Benjamin-girard-1/magnetometer-node/docs/Components choices/Capture d’écran, le 2026-01-07 à 11.52.20.png

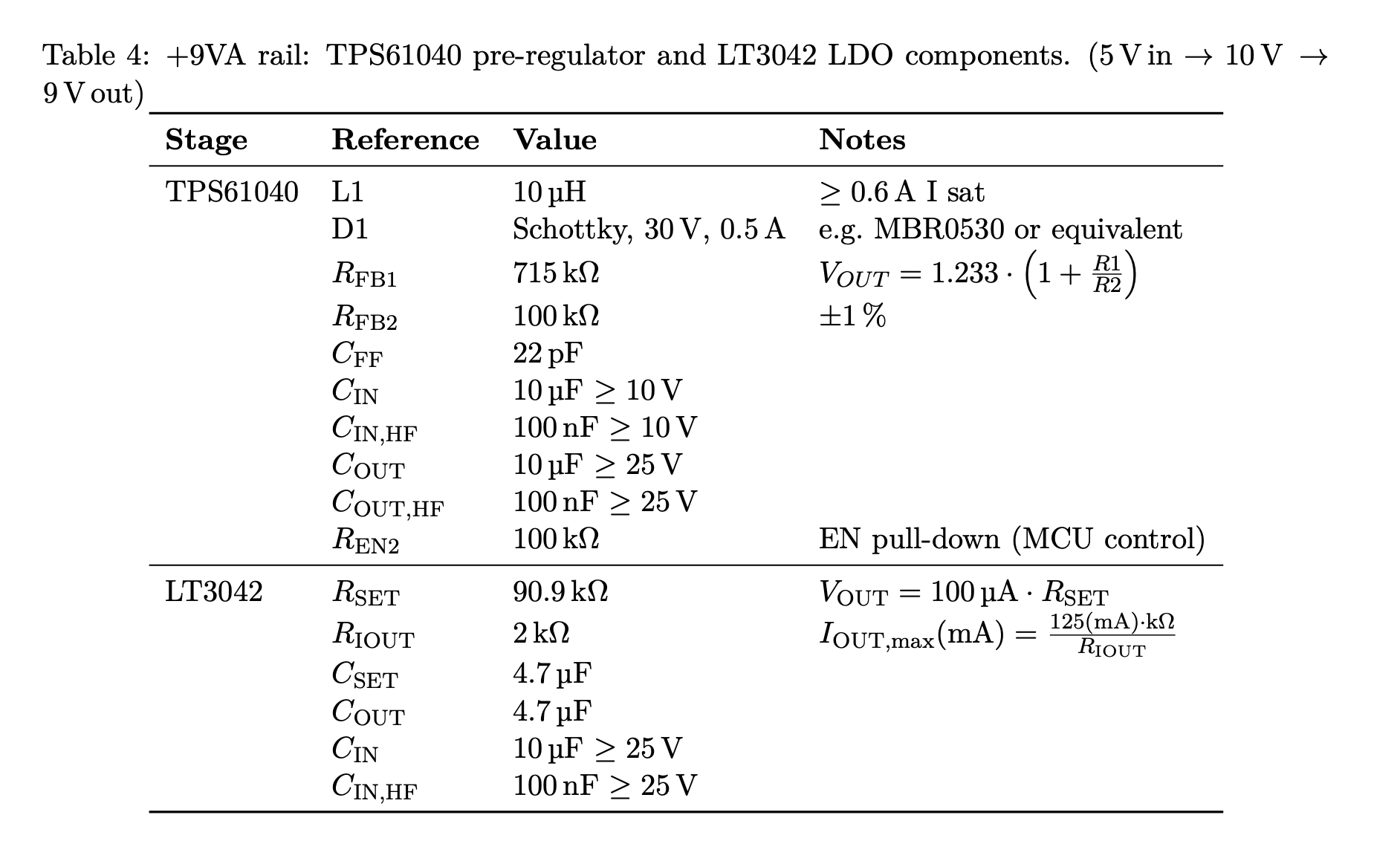
docs/Components choices/Capture d’écran, le 2026-01-07 à 11.52.20.png
