Benjamin-girard-1/magnetometer-node/docs/Components choices/fig/Lt3042.png

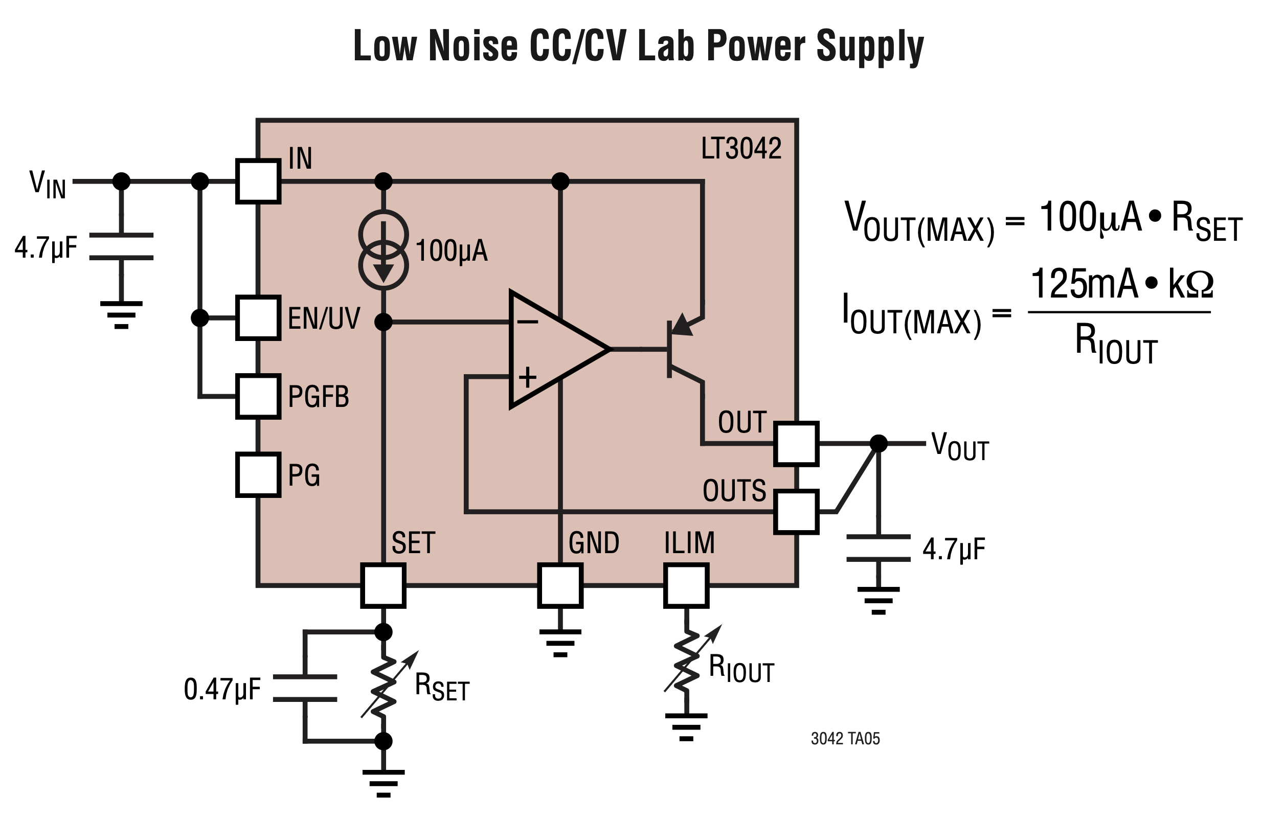
docs/Components choices/fig/Lt3042.png
