Benjamin-girard-1/magnetometer-node/docs/Components choices/fig/TPS62912.png

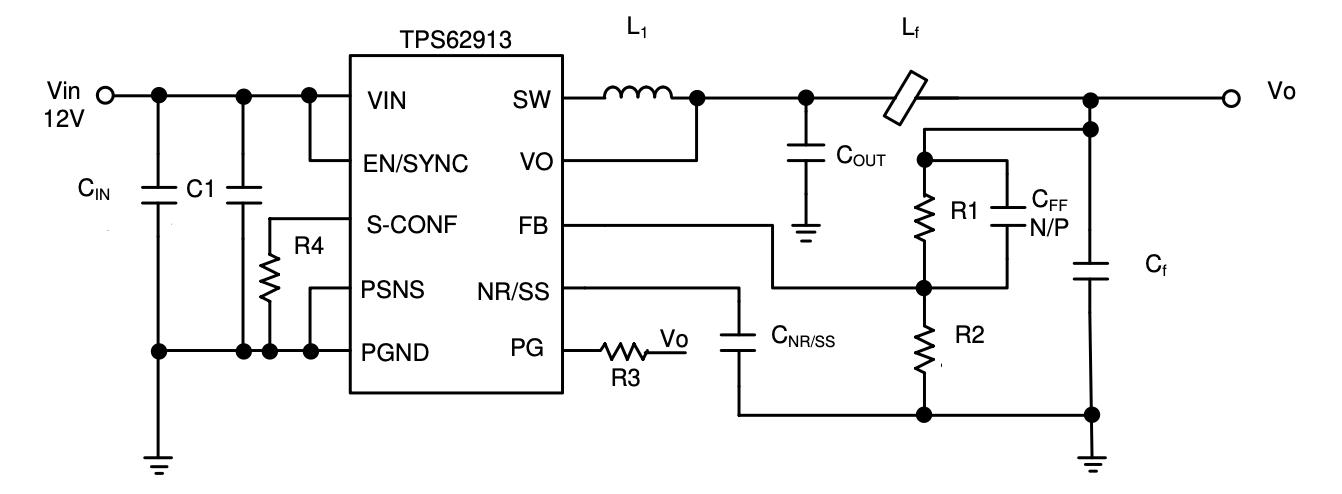
docs/Components choices/fig/TPS62912.png
