Benjamin-girard-1/magnetometer-node/hardware/pcb/Expension_card_design/3D_Assembly/Step_files/magnetometer_node_mainboard_simple.step

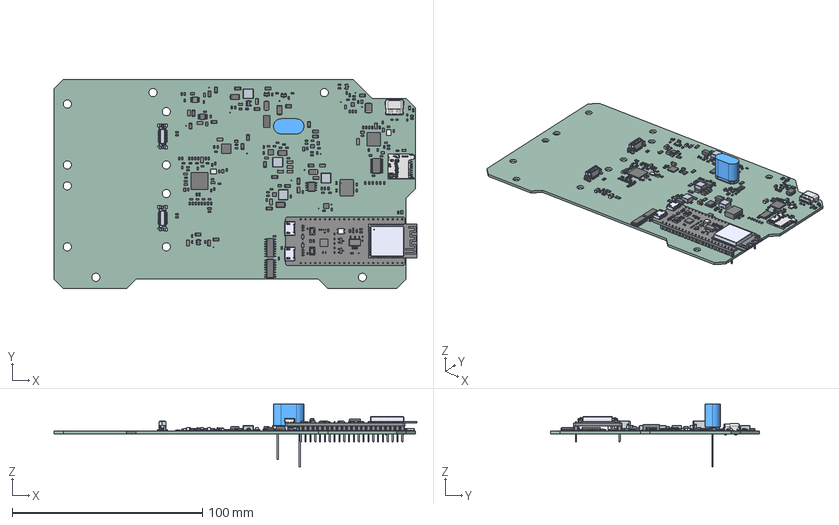
[picture p14: CAD file, 2026-04-30]
hardware/pcb/Expension_card_design/3D_Assembly/Step_files/magnetometer_node_mainboard_simple.step
190.7 x 110.0 x 33.0 mm
R_0603_1608Metric x 86
C_0805_2012Metric x 21
C_0603_1608Metric x 62
SOIC-16_3.9x9.9mm_P1.27mm x 2
R_1206_3216Metric x 23
SOT-23-5 x 2
D_SMA x 6
magnetometer_node_mainboard_simple 1.15.1 x 4
MOLD x 2
C_1206_3216Metric x 17
BODY-DGN0008G
LEAD-DGN0008G x 8
PIN1_DGN0008G
DAP_DGN0008G
LED_0805_2012Metric
D_SMB
D_SOD-523 x 4
Molex_micro_sd
QFN-64-1EP_9x9mm_P0.5mm_EP7.35x7.35mm
VSON-10-1EP_3x3mm_P0.5mm_EP1.2x2mm
LGA-14_3x2.5mm_P0.5mm_LayoutBorder3x4y
L_0603_1608Metric
Molex_USB_C_CONNECTOR2012670005
Texas_RGW0020A_VQFN-20-1EP_5x5mm_P0.65mm_EP3.15x3.15mm
R_2512_6332Metric
ESP32-S3-DEVKITC-1-N8
SOT-23 x 3
Crystal_SMD_3225-4Pin_3.2x2.5mm x 2
MSOP-10-1EP_3x3mm_P0.5mm_EP1.68x1.88mm
TSSOP-24_4.4x7.8mm_P0.65mm
QFN-48-1EP_7x7mm_P0.5mm_EP5.15x5.15mm
SCL3300-D01-10_MUR
R_0805_2012Metric
WSON-6-1EP_2x2mm_P0.65mm_EP1x1.6mm
SOIC-8_3.9x4.9mm_P1.27mm
CP_Radial_D8.0mm_P1150mm
geophys_mainboard_PCB
