Benjamin-girard-1/magnetometer-node/hardware/pcb/Expension_card_design/3D_Assembly/Assembly/Expension_design_3D.FCStd

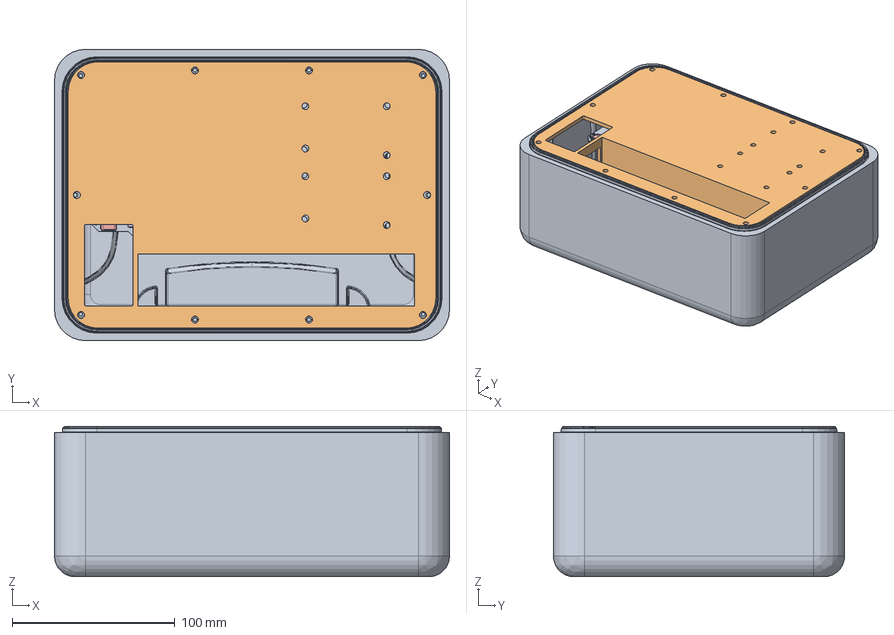
[picture p15: CAD file, 2026-04-30]
hardware/pcb/Expension_card_design/3D_Assembly/Assembly/Expension_design_3D.FCStd
242.8 x 179.0 x 92.5 mm
NANUK_904_Bottom001
R_0603_1608Metric
R_0603_1608Metric001
C_0805_2012Metric
R_0603_1608Metric002
C_0603_1608Metric
C_0603_1608Metric001
C_0805_2012Metric001
SOIC-16_3.9x9.9mm_P1.27mm
C_0603_1608Metric002
R_1206_3216Metric
SOT-23-5
R_0603_1608Metric003
D_SMA
C_0603_1608Metric003
magnetometer_node_mainboard_simple 1.15.1
magnetometer_node_mainboard_simple 1.15.002
magnetometer_node_mainboard_simple 1.15.003
C_0603_1608Metric004
C_0805_2012Metric002
R_1206_3216Metric001
MOLD
R_0603_1608Metric004
MOLD001
R_0603_1608Metric005
C_0603_1608Metric005
R_0603_1608Metric006
C_0603_1608Metric006
magnetometer_node_mainboard_simple 1.15.005
magnetometer_node_mainboard_simple 1.15.006
magnetometer_node_mainboard_simple 1.15.007
R_0603_1608Metric007
R_0603_1608Metric008
R_0603_1608Metric009
R_0603_1608Metric010
C_0805_2012Metric003
C_1206_3216Metric
R_1206_3216Metric002
C_0603_1608Metric007
R_1206_3216Metric003
R_0603_1608Metric011
BODY-DGN0008G
LEAD-DGN0008G
LEAD-DGN0008G001
LEAD-DGN0008G002
LEAD-DGN0008G003
LEAD-DGN0008G004
LEAD-DGN0008G005
LEAD-DGN0008G006
LEAD-DGN0008G007
DAP_DGN0008G
C_0603_1608Metric008
C_0603_1608Metric009
C_1206_3216Metric001
R_0603_1608Metric012
R_1206_3216Metric004
C_1206_3216Metric002
C_0603_1608Metric010
C_1206_3216Metric003
C_0603_1608Metric011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
