Benjamin-girard-1/magnetometer-node/hardware/pcb/Expension_card_design/3D_Assembly/FreeCAD_Designs/904_frame.FCStd

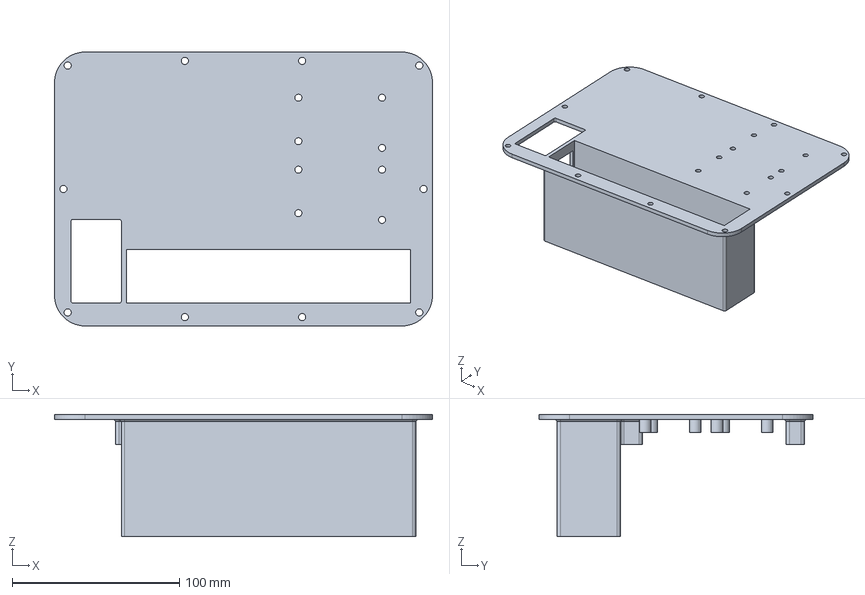
[picture p16: CAD file, 2026-04-30]
hardware/pcb/Expension_card_design/3D_Assembly/FreeCAD_Designs/904_frame.FCStd
225.9 x 163.7 x 73.2 mm
