Benjamin-girard-1/magnetometer-node/hardware/pcb/Expension_card_design/3D_Assembly/SLT_files/04_Coil_Top_HC_v1.stl

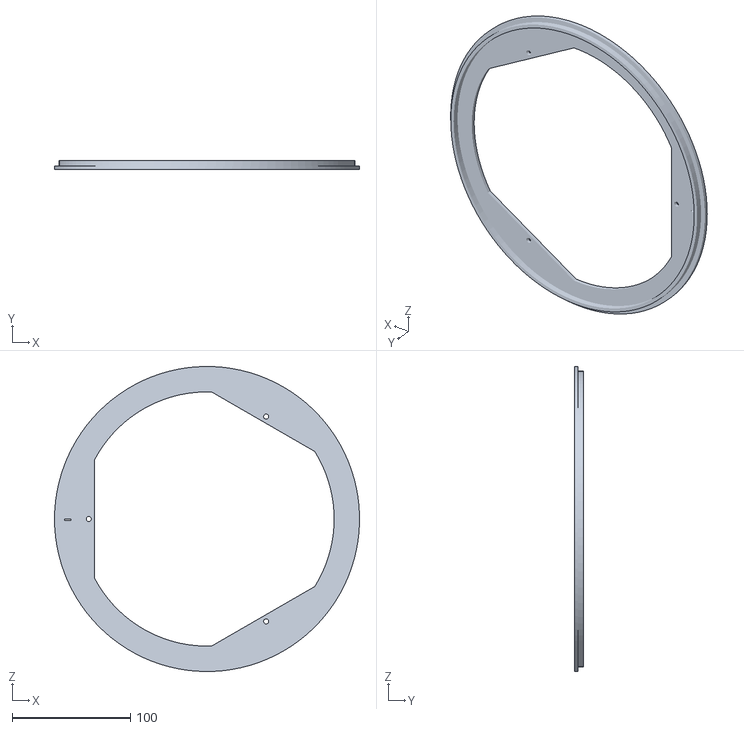
[picture p17: CAD file, 2026-05-25]
hardware/pcb/Expension_card_design/3D_Assembly/SLT_files/04_Coil_Top_HC_v1.stl
257.9 x 8.00 x 258.0
