Benjamin-girard-1/magnetometer-node/hardware/pcb/Expension_card_design/3D_Assembly/Step_files/Bottom_coil_B.stl

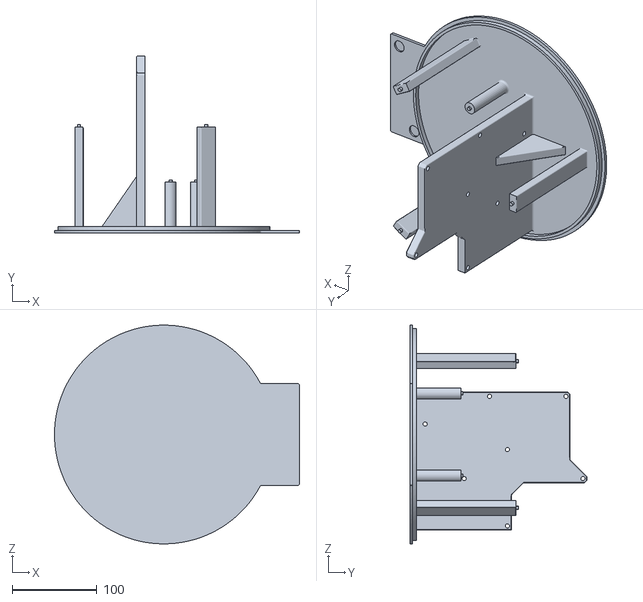
[picture p18: CAD file, 2026-05-25]
hardware/pcb/Expension_card_design/3D_Assembly/Step_files/Bottom_coil_B.stl
288.9 x 209.0 x 257.9
