Benjamin-girard-1/magnetometer-node/hardware/pcb/Expension_card_design/3D_Assembly/FreeCAD_Designs/904_plate.FCStd

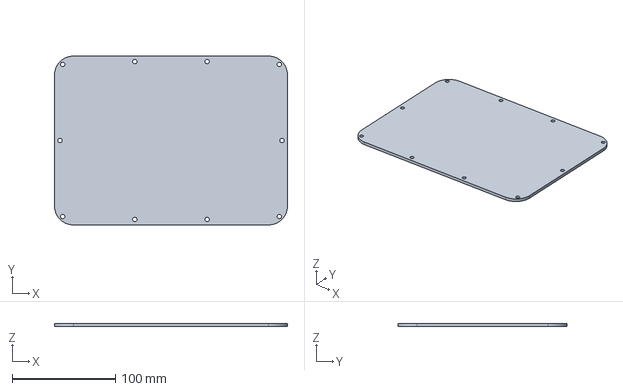
[picture p19: CAD file, 2026-04-30]
hardware/pcb/Expension_card_design/3D_Assembly/FreeCAD_Designs/904_plate.FCStd
225.9 x 163.7 x 3.20 mm
