Benjamin-girard-1/magnetometer-node/hardware/pcb/Expension_card_design/3D_Assembly/SLT_files/01_Base_HC_v1.stl

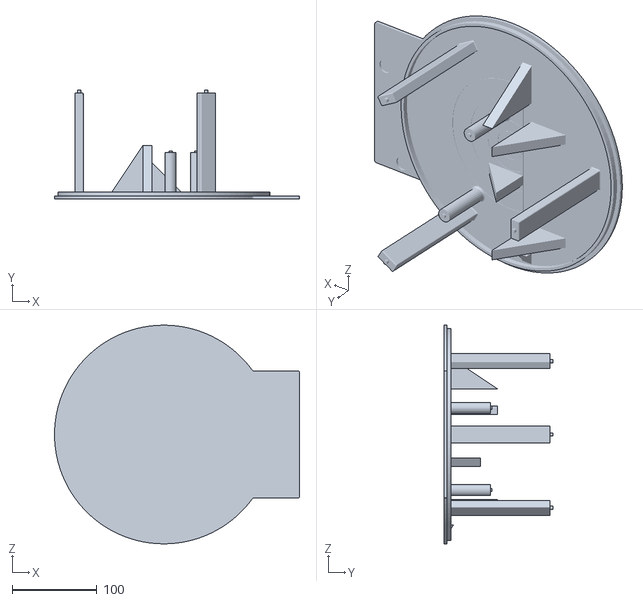
[picture p20: CAD file, 2026-05-25]
hardware/pcb/Expension_card_design/3D_Assembly/SLT_files/01_Base_HC_v1.stl
289.0 x 128.0 x 258.0
