Benjamin-girard-1/magnetometer-node/hardware/pcb/Expension_card_design/3D_Assembly/FreeCAD_Designs/904_body_top.FCStd

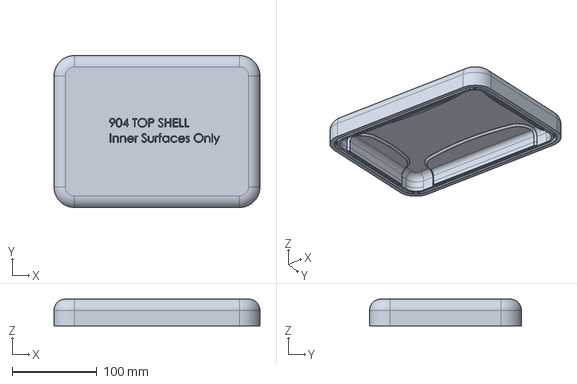
[picture p21: CAD file, 2026-04-30]
hardware/pcb/Expension_card_design/3D_Assembly/FreeCAD_Designs/904_body_top.FCStd
243.0 x 179.2 x 31.8 mm
