Benjamin-girard-1/magnetometer-node/hardware/pcb/Expension_card_design/3D_Assembly/SLT_files/05_Pillar_HC_v1.stl

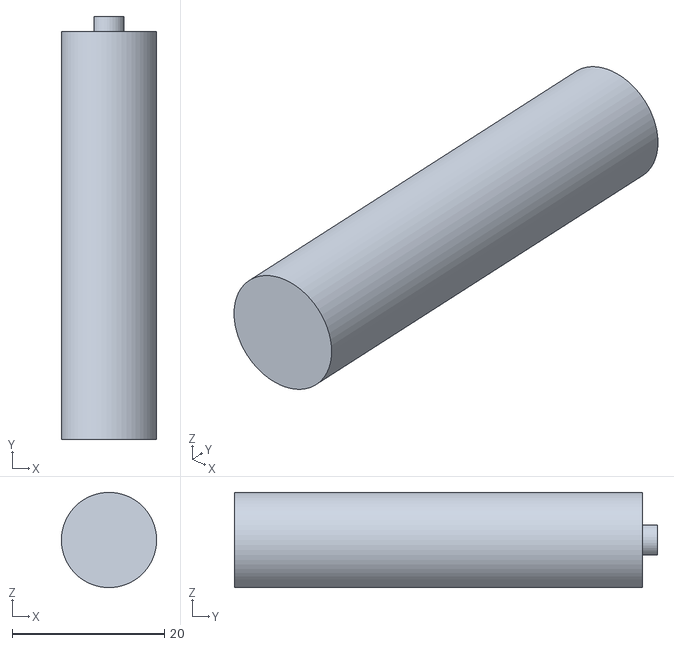
[picture p22: CAD file, 2026-05-25]
hardware/pcb/Expension_card_design/3D_Assembly/SLT_files/05_Pillar_HC_v1.stl
12.5 x 55.5 x 12.5
