Benjamin-girard-1/magnetometer-node/hardware/pcb/Expension_card_design/3D_Assembly/Step_files/904_frame10.step

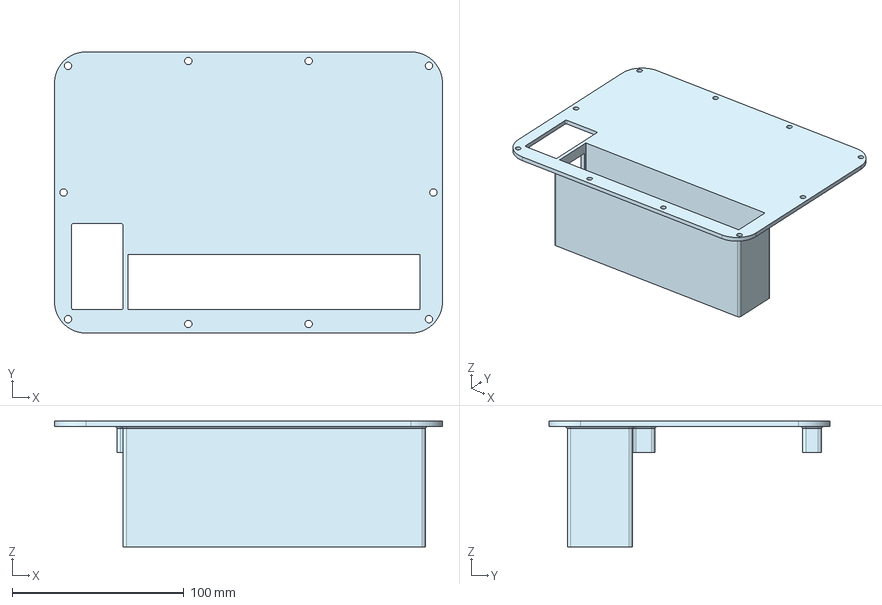
[picture p23: CAD file, 2026-04-30]
hardware/pcb/Expension_card_design/3D_Assembly/Step_files/904_frame10.step
225.9 x 163.7 x 73.2 mm
