Benjamin-girard-1/magnetometer-node/hardware/pcb/Expension_card_design/3D_Assembly/FreeCAD_Designs/904_body_bottom.FCStd

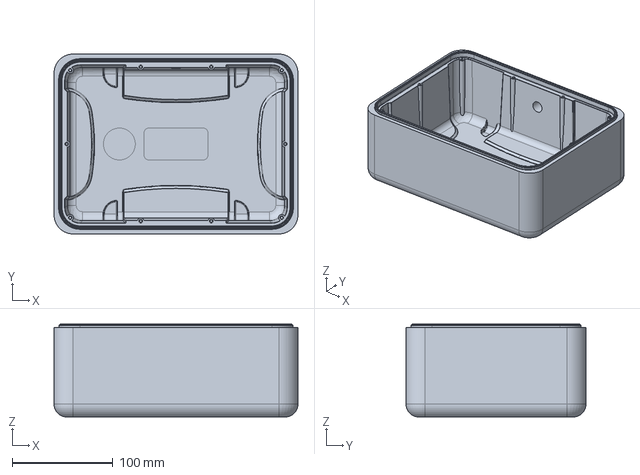
[picture p24: CAD file, 2026-04-30]
hardware/pcb/Expension_card_design/3D_Assembly/FreeCAD_Designs/904_body_bottom.FCStd
242.8 x 179.0 x 92.5 mm
