Benjamin-girard-1/magnetometer-node/hardware/pcb/Expension_card_design/3D_Assembly/SLT_files/03_Back_plate_HC_v1.stl

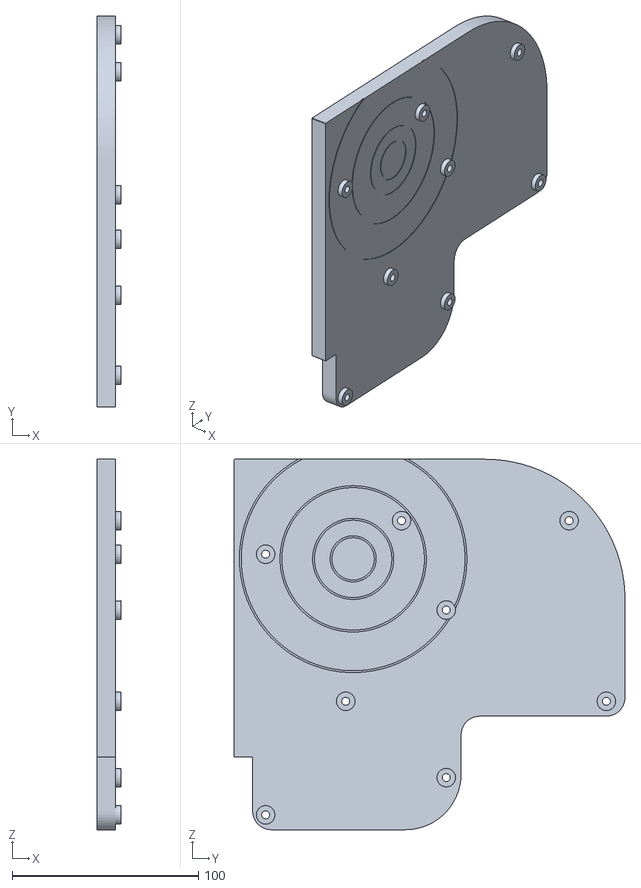
[picture p25: CAD file, 2026-05-25]
hardware/pcb/Expension_card_design/3D_Assembly/SLT_files/03_Back_plate_HC_v1.stl
13.0 x 210.0 x 199.0
