Benjamin-girard-1/magnetometer-node/hardware/pcb/Expension_card_design/3D_Assembly/Step_files/904_frame2.step

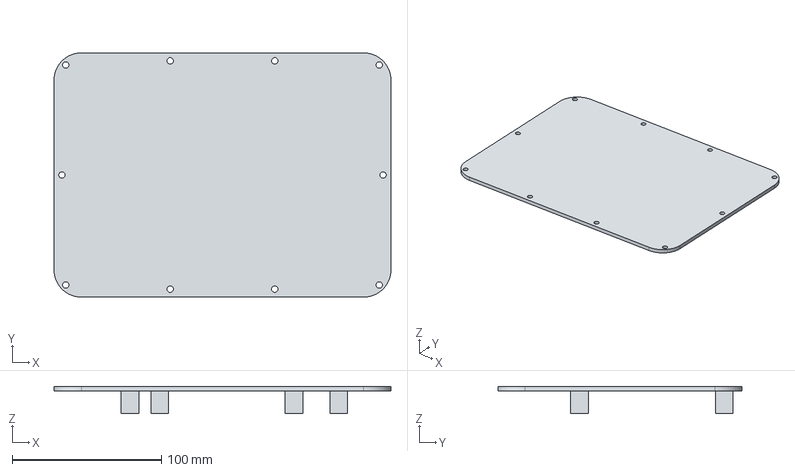
[picture p26: CAD file, 2026-04-30]
hardware/pcb/Expension_card_design/3D_Assembly/Step_files/904_frame2.step
225.9 x 163.7 x 18.2 mm
