Benjamin-girard-1/magnetometer-node/hardware/pcb/Expension_card_design/3D_Assembly/Step_files/Exp_mag.step

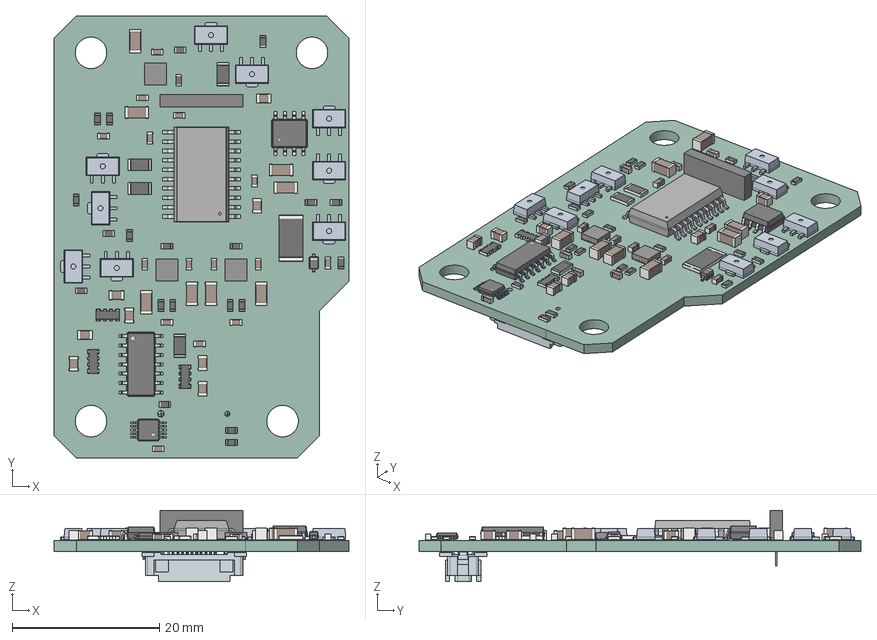
[picture p28: CAD file, 2026-04-30]
hardware/pcb/Expension_card_design/3D_Assembly/Step_files/Exp_mag.step
40.0 x 60.0 x 9.64 mm
R_0603_1608Metric x 21
C_0805_2012Metric x 8
C_0603_1608Metric x 15
C_1206_3216Metric x 8
SOIC20_HNW
BODY-QFN x 3
FRAME-RGT0016C x 3
PIN1-ID x 3
Exp_mag 1.10.1 x 9
SIP8_HMC1001_HNW
R_Array_Convex_4x0603 x 3
SOIC-14_3.9x8.7mm_P1.27mm
R_1206_3216Metric x 4
D_SOD-323
SO-8_3.9x4.9mm_P1.27mm
R_2512_6332Metric
MSOP-10_3x3mm_P0.5mm
magnetic_expension_PCB
