Benjamin-girard-1/magnetometer-node/hardware/pcb/Expension_card_design/3D_Assembly/Step_files/6mm_HEX_Spacer_M4.step

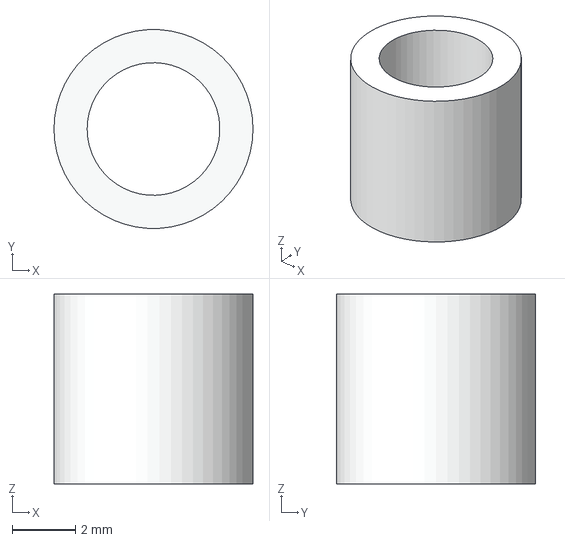
[picture p29: CAD file, 2026-04-30]
hardware/pcb/Expension_card_design/3D_Assembly/Step_files/6mm_HEX_Spacer_M4.step
6.30 x 6.29 x 6.00 mm
