Benjamin-girard-1/magnetometer-node/(list of files, cad)

Other CAD files:
hardware/pcb/Expension_card_design/3D_Assembly/Step_files/904_frame11.step
hardware/pcb/Expension_card_design/3D_Assembly/Step_files/904_plate.step
hardware/pcb/Expension_card_design/3D_Assembly/Step_files/904_frame7.step
hardware/pcb/Expension_card_design/3D_Assembly/Step_files/904_frame3.step
hardware/pcb/Expension_card_design/3D_Assembly/Step_files/904_body_top.step
hardware/pcb/Expension_card_design/3D_Assembly/Step_files/904_frame4.step
hardware/pcb/Expension_card_design/3D_Assembly/Step_files/904_frame.step
hardware/pcb/Expension_card_design/3D_Assembly/Step_files/904_frame8.step
hardware/pcb/Expension_card_design/3D_Assembly/Step_files/904_frame6.step
hardware/pcb/Expension_card_design/3D_Assembly/Step_files/904_frame9.step
hardware/pcb/Expension_card_design/3D_Assembly/Step_files/904_body_bottom.step
hardware/pcb/Expension_card_design/3D_Assembly/Step_files/904_plate_2.step
hardware/pcb/Expension_card_design/3D_Assembly/Step_files/904_frame12.step
hardware/pcb/Expension_card_design/3D_Assembly/Step_files/904_frame5.step
hardware/pcb/Expension_card_design/3D_Assembly/Step_files/904_frame12.stl
