Benjamin-girard-1/magnetometer-node/hardware/pcb/Expension_card_design/3D_Assembly/SLT_files/Instruction_impression.docx

Instruction des fichiers à imprimer pour la bobine d’Helmholtz

Pièce 01 (base) : 1x

Pièce 02 (Coil closer) : 2x

Pièce 03 (Back plate) : 1x

Pièce 04 (Coil top) : 1x

Pièce 05 (Pillar) : 2x
