Benjamin-girard-1/magnetometer-node/firmware/esp32/ESP32-S3-WROOM-1/Mainboard/geophys-daq/calibration_code/noise_density_compare_difference.png

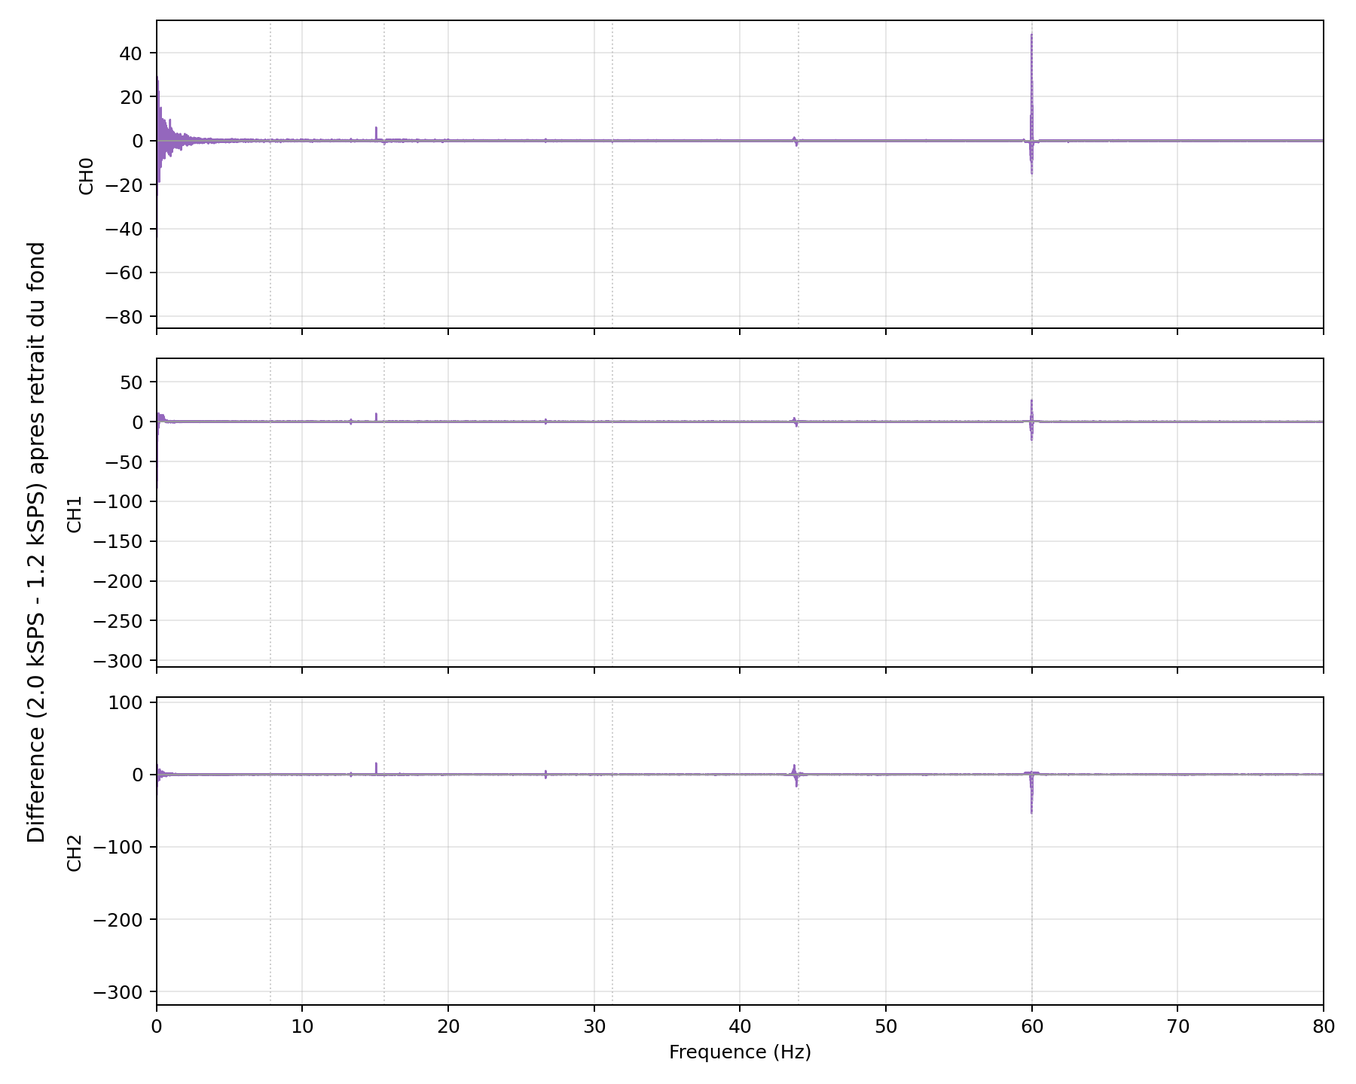
firmware/esp32/ESP32-S3-WROOM-1/Mainboard/geophys-daq/calibration_code/noise_density_compare_difference.png
