Benjamin-girard-1/magnetometer-node/firmware/esp32/ESP32-S3-WROOM-1/Mainboard/geophys-daq/calibration_data/board_mag_1/x axis/x_axis_ch2_noise_density_all.png

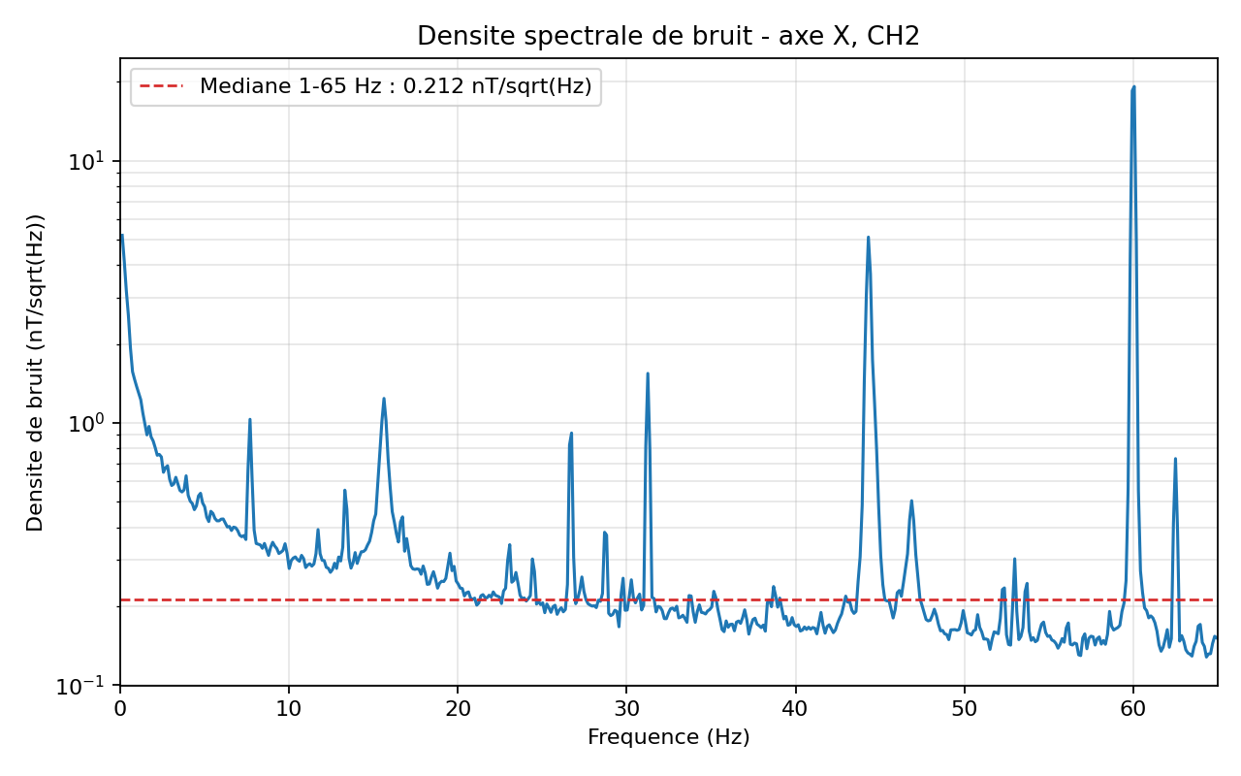
firmware/esp32/ESP32-S3-WROOM-1/Mainboard/geophys-daq/calibration_data/board_mag_1/x axis/x_axis_ch2_noise_density_all.png
