Benjamin-girard-1/magnetometer-node/firmware/esp32/ESP32-S3-WROOM-1/Mainboard/geophys-daq/calibration_data/board_mag_1/y axis/y_axis_ch1_calibration.png

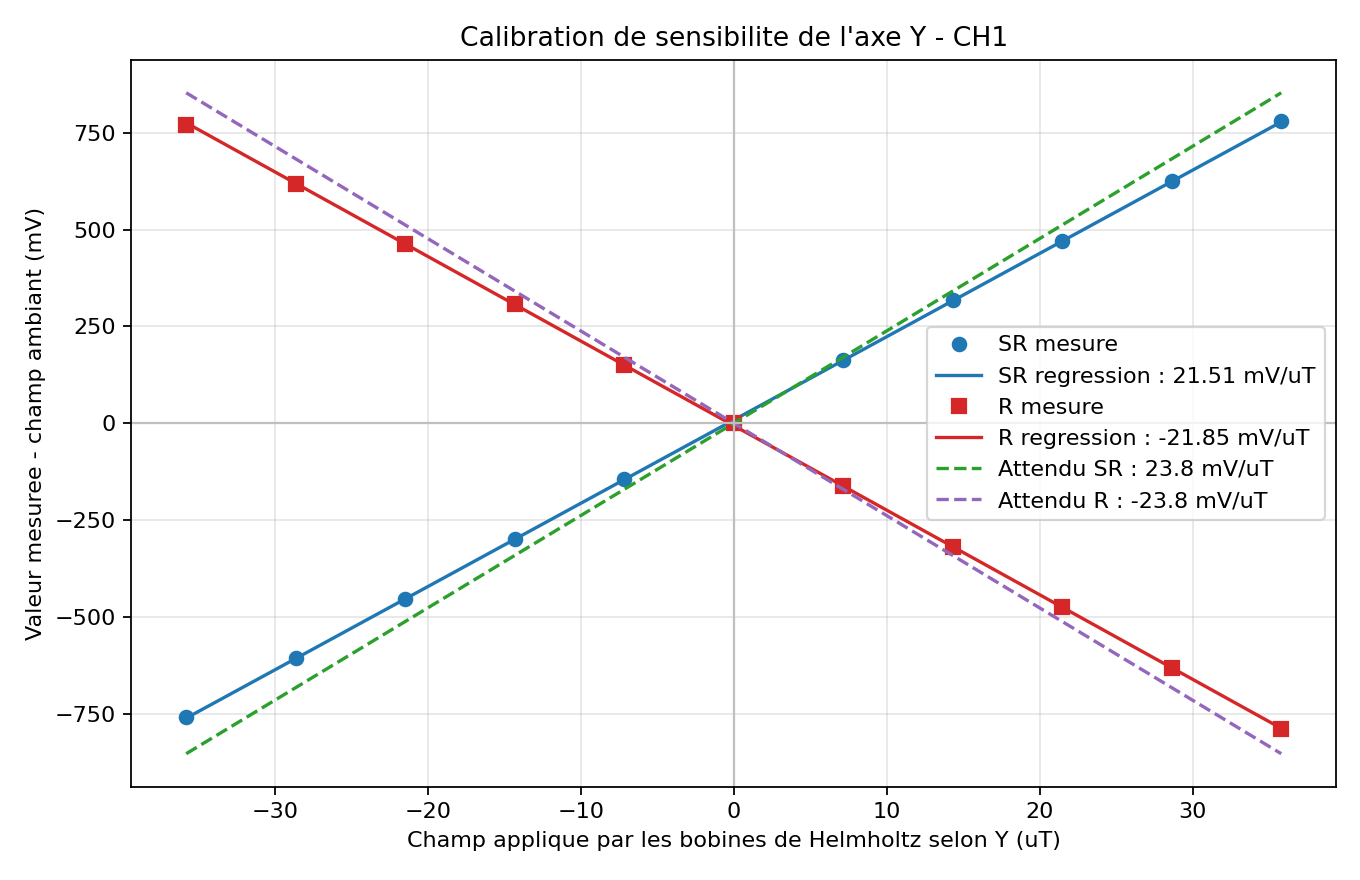
firmware/esp32/ESP32-S3-WROOM-1/Mainboard/geophys-daq/calibration_data/board_mag_1/y axis/y_axis_ch1_calibration.png
