Benjamin-girard-1/magnetometer-node/firmware/esp32/ESP32-S3-WROOM-1/Mainboard/geophys-daq/calibration_data/board_mag_1/z axis/z_axis_ch0_noise_density_z_f200_n16384.png

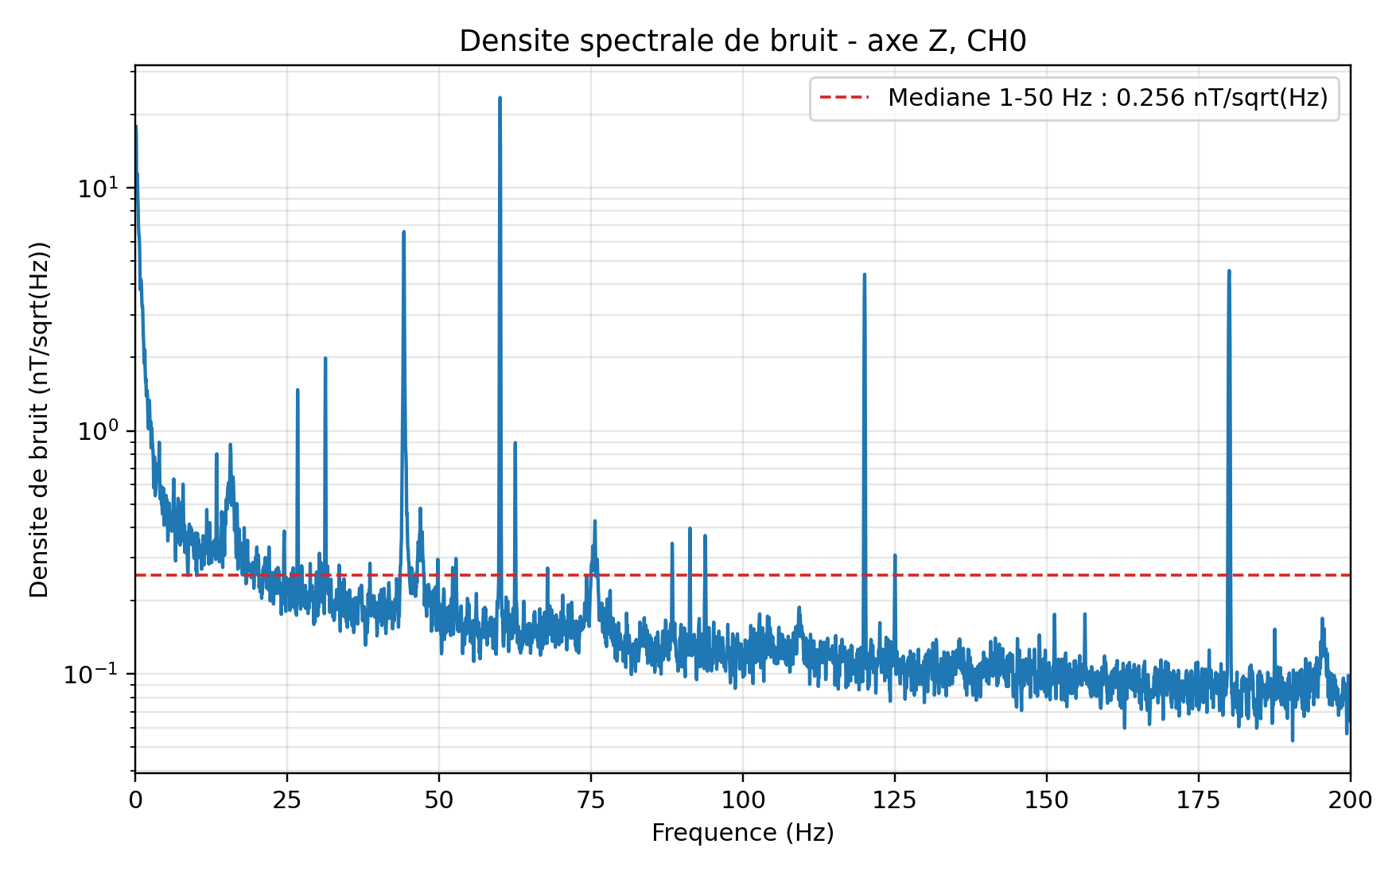
firmware/esp32/ESP32-S3-WROOM-1/Mainboard/geophys-daq/calibration_data/board_mag_1/z axis/z_axis_ch0_noise_density_z_f200_n16384.png
