Benjamin-girard-1/magnetometer-node/firmware/esp32/ESP32-S3-WROOM-1/Mainboard/geophys-daq/tools/spice/models/tests/opa1197_tran_settle.cir

* OPA1197_FUNC transient settling from DC input
.include ../OPA1197_functional.lib

VCC vcc 0 15
VEE vee 0 -15
VIN inp 0 1
XU1 inp out vcc vee out OPA1197_FUNC

.tran 1u 100u
.control
run
print v(out)[length(v(out))-1]
print v(xu1.err)[length(v(out))-1]
quit
.endc
.end
