Benjamin-girard-1/magnetometer-node/hardware/pcb/Expension_card_design/mainboard_v2/mainboard_v2.kicad_pcb

## KiCad design hardware/pcb/Expension_card_design/mainboard_v2/mainboard_v2.kicad_pcb (2026-06-26)

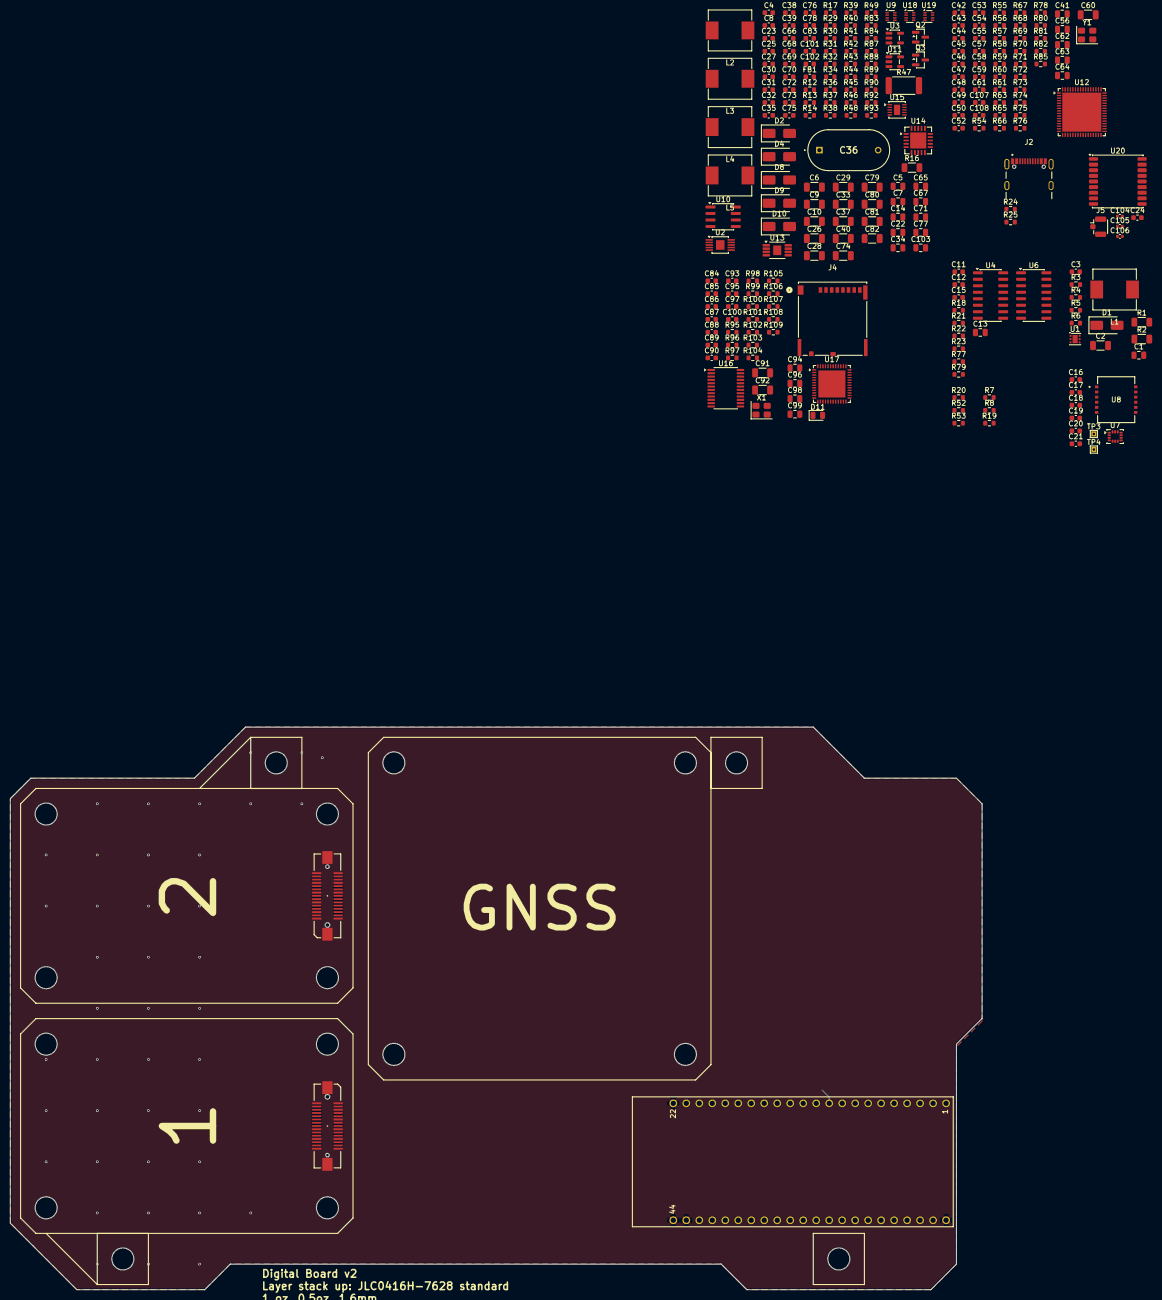
[picture p42: board mainboard_v2.kicad_pcb from above]

Board: 4 copper layers, 190.0 x 110.0 mm, 260 parts (0 on the bottom side), 178 nets.

Parts:
C1, C7, C13, C22, C34, C41, C56, C65, C67, C71, C77, C96: 10u; C_0805_2012Metric
C2, C6, C9, C10, C37, C40, C79, C80, C81, C82, C91, C92: 4u7; C_1206_3216Metric
C3, C66, C68, C73, C78: 10n; C_0603_1608Metric
C4: 22p; C_0603_1608Metric
C5, C14, C62, C63, C64, C94, C98, C99, C103: 1u; C_0805_2012Metric
C8, C11, C12, C15, C16, C17, C18, C19, C20, C21, C23, C25, C38, C39, C42, C43, C44, C45, C46, C47, C48, C55, C58, C59, C61, C69, C72, C76, C84, C85, C86, C87, C88, C89, C90, C93, C95, C101, C102: 100n; C_0603_1608Metric
C24: 10u; C_0603_1608Metric
C26, C28: 22u; C_1206_3216Metric
C27, C97, C100: 15p; C_0603_1608Metric
C29, C33, C60, C74: 47u; C_1206_3216Metric
C30, C83: 4n7; C_0603_1608Metric
C31, C75: 10p; C_0603_1608Metric
C32, C35: 22n; C_0603_1608Metric
C36: 470mF; C_Radial_D8.0mm_P11.50mm
C49, C50, C52, C53, C54, C57, C107, C108: 1n; C_0603_1608Metric
C70: 220n; C_0603_1608Metric
C104, C105, C106: 100n; C_0402_1005Metric
D1, D2, D4, D8, D9, D10: SS34; D_SMA
D11: LED; LED_0805_2012Metric
FB1: 120Ω@100MHz 2A 50mΩ; L_0603_1608Metric
H1, H2, H3, H4, H5, H6, H7, H8, H9, H10, H11, H12, H13, H14, H15, H16: MountingHole; MountingHole_4.3mm_M4
J1, J3: 550910374; CONN_MOLEX_02x15_55091-0374
J2: USB_C_Receptacle_USB2.0_16P; GCT_USB4105-GF-A
J4: Micro_SD_CARD; CONN_503398-1892_MOL
J5: Conn_Coaxial; U.FL_Hirose_U.FL-R-SMT-1_Vertical
L1, L2, L3, L4, L5: 10u; ZEMS0850-100M_8.5x8.0mm
Q2: AO3401A; SOT-23
Q3: AO3400A; SOT-23
R1, R2: 0; R_1206_3216Metric
R3: 49k9; R_0603_1608Metric
R4, R7, R8, R17, R29, R31, R41, R42, R49, R52, R53, R56, R70, R73, R75, R78, R87, R90, R93, R95, R96, R108: 100k; R_0603_1608Metric
R5, R18, R19, R20, R39, R58, R77, R79, R97, R99, R100, R101, R102, R103, R104, R107, R109: 10k; R_0603_1608Metric
R6: 3k6; R_0603_1608Metric
R12, R92: 510k; R_0603_1608Metric
R13, R55, R80, R105: 1k; R_0603_1608Metric
R14, R48: 200k; R_0603_1608Metric
R16: 90k9; R_1206_3216Metric
R21, R22, R23, R57, R59, R60, R61, R63, R65, R66, R67, R68, R69, R71, R72, R74, R76, R81, R82, R85: 22; R_0603_1608Metric
R24, R25: 5k1; R_0603_1608Metric
R30, R32, R34, R37, R54: 300k; R_0603_1608Metric
R36: R_0603_1608Metric
R38, R43: 75k; R_0603_1608Metric
R40: 24k; R_0603_1608Metric
R44, R83: 39k; R_0603_1608Metric
R45, R46: 100; R_0603_1608Metric
R47: 22; R_2512_6332Metric
R84, R98: 12k; R_0603_1608Metric
R88: 330k; R_0603_1608Metric
R89: 10; R_0603_1608Metric
R106: 68k; R_0603_1608Metric
TP3, TP4: TestPoint; TestPoint_THTPad_1.0x1.0mm_Drill0.5mm
U1: TPS61170; WSON-6-1EP_2x2mm_P0.65mm_EP1x1.6mm
U2: LT3042xMSE; MSOP-10-1EP_3x3mm_P0.5mm_EP1.68x1.88mm
U3: TPS61040DBV; SOT-23-5
U4, U6: 74HC595D,118; SOIC-16_3.9x9.9mm_P1.27mm
U5: ESP32-S3-DevKitC; MODULE_ESP32-S3-DEVKITC
U7: LSM6DSVETR; LGA-14_3x2.5mm_P0.5mm_LayoutBorder3x4y
U8: SCL3300-D01-10; SCL3300-D01-10_MUR
U9, U18: TPS2116DRL; SOT-583-8
U10: TPS54331DR; SOIC-8_3.9x4.9mm_P1.27mm
U11: TPS7A2033PDBVR; SOT-23-5
U12: AD7779ACPZ; QFN-64-1EP_9x9mm_P0.5mm_EP7.65x7.65mm
U13: TPS7A4901DGNR; HVSSOP-8-1EP_3x3mm_P0.65mm_EP1.57x1.89mm
U14: TPS7A3301RGWR; Texas_RGW0020A_VQFN-20-1EP_5x5mm_P0.65mm_EP3.15x3.15mm
U15: TPS63700DRCR; VSON-10-1EP_3x3mm_P0.5mm_EP1.2x2mm
U16: TS3A27518EPWR; TSSOP-24_4.4x7.8mm_P0.65mm
U17: USB2641-HZH-02; QFN-48-1EP_7x7mm_P0.5mm_EP5.3x5.3mm
U19: TPS62933; SOT-583-8
U20: MAX-M10S; ublox_MAX
X1: X322524MOB4SI; Crystal_SMD_3225-4Pin_3.2x2.5mm
Y1: OT2JI-111-8.192M; Crystal_SMD_3225-4Pin_3.2x2.5mm

Connections:
+1V65: J1.17, J3.17, U12.57 (VCM)
+3V3: C11.1, C12.1, C13.1, C15.1, C16.2, C17.2, C18.2, C19.2, C24.1, C29.1, C47.1, C55.1, C56.1, C84.1, C85.1, C86.1, C87.1, C88.1, C89.1, C90.1, C91.1, C92.1, C93.1, C94.2, C95.1, C96.1, C104.1, C105.1, C106.1, J4.4 (VDD), L3.2, R18.1, R19.2, R20.2, R29.1, R38.1, R42.1, R58.2, R75.1, R77.1, R78.1, R79.1, R95.1, R96.1, R97.1, R99.1, R100.1, R101.1, R102.1, R103.1, R104.1, U4.16 (VCC), U5.1 (ESP_3V3), U5.2 (ESP_3V3), U6.16 (VCC), U7.5 (VDD_IO), U7.8 (VDD), U8.4 (VDD), U8.9 (DVIO), U12.24 (IOVDD), U16.8 (VCC), U17.5 (VDD33), U17.12 (VDD33), U17.16 (VDD33), U17.25 (VDD33), U17.34 (VDD33), U17.41 (VDD33), U17.48 (VDD33), U20.6 (V_BCKP), U20.7 (VCC_IO), U20.8 (VCC), Y1.4 (VDD)
+3V3A: C39.1, C40.1, C41.1, C42.1, C43.1, C44.1, C45.1, C46.1, J1.22, J3.22, U11.5 (OUT), U12.6 (AVDD1A), U12.43 (AVDD1B), U12.52 (AVDD2B), U12.54 (FORMAT1), U12.55 (FORMAT0), U12.58 (AVDD2A), U12.62 (AVDD4)
+3V3D: J1.23, J3.23
+5V: C10.1, C23.2, C37.1, C38.1, C77.1, C103.1, L2.1, Q2.2, R1.1, R30.2, R44.1, R89.2, U3.5 (VIN), U9.3 (VIN1), U9.5 (MODE), U11.1 (IN), U15.5 (IN), U18.2 (VOUT), U18.7 (VOUT)
+5VA: C66.1, C67.1, J1.19, J3.19, R83.1, U13.1 (OUT)
+9VA: C6.1, J1.21, J3.21, R54.1, U2.9 (OUTS), U2.10 (OUT)
+10V: C4.1, C5.1, C7.1, C8.1, C65.1, D2.1 (K), R12.1, U2.1 (IN), U2.2 (IN), U2.3 (EN/UV), U2.6 (PGFB), U13.5 (EN), U13.8 (IN)
+18V: J1.18, J3.18, R2.2
-5VA: C73.1, C74.1, J1.20, J3.20, R88.1, U14.1 (OUT), U14.20 (OUT)
-6V2: C71.1, C72.1, C78.1, C79.1, C80.1, C81.1, C82.1, D10.2 (A), R92.2, R93.2, U14.13 (EN), U14.15 (IN), U14.16 (IN), U15.8 (OUT)
/ADC_AD777x/ADC_9VA_MON: C48.1, R54.2, R55.1, R56.1
/ADC_AD777x/ADC_9VA_MON_FLT: R55.2, U12.63 (AUXAIN+)
/ADC_AD777x/ADC_AREG1CAP: C63.1, U12.59 (AREG1CAP)
/ADC_AD777x/ADC_AREG2CAP: C64.1, U12.51 (AREG2CAP)
/ADC_AD777x/ADC_CONVST_SAR: R70.1, U6.5 (QF), U12.17 (CONVST_SAR)
/ADC_AD777x/ADC_CS: R21.1, R58.1, U12.18 (ALERT/~CS)
/ADC_AD777x/ADC_DRDY: U5.16 (GPIO10), U12.30 (~DRDY)
/ADC_AD777x/ADC_DREGCAP: C62.1, U12.23 (DREGCAP)
/ADC_AD777x/ADC_IN0+: C49.1, R57.2, U12.2 (AIN0+)
/ADC_AD777x/ADC_IN0-: C49.2, R59.2, U12.1 (AIN0-)
/ADC_AD777x/ADC_IN1+: C50.1, R60.2, U12.4 (AIN1+)
/ADC_AD777x/ADC_IN1-: C50.2, R63.2, U12.3 (AIN1-)
/ADC_AD777x/ADC_IN2+: C52.1, R65.2, U12.10 (AIN2+)
/ADC_AD777x/ADC_IN2-: C52.2, R67.2, U12.9 (AIN2-)
/ADC_AD777x/ADC_IN3+: C57.1, C107.1, R66.2, R74.2, U12.12 (AIN3+), U12.37 (AIN7+)
/ADC_AD777x/ADC_IN3-: C57.2, C107.2, R76.2, R81.2, U12.11 (AIN3-), U12.38 (AIN7-)
/ADC_AD777x/ADC_IN4+: C53.1, R68.2, U12.47 (AIN4+)
/ADC_AD777x/ADC_IN4-: C53.2, R69.2, U12.48 (AIN4-)
/ADC_AD777x/ADC_IN5+: C54.1, R71.2, U12.45 (AIN5+)
/ADC_AD777x/ADC_IN5-: C54.2, R72.2, U12.46 (AIN5-)
/ADC_AD777x/ADC_IN6+: C108.1, R82.2, U12.39 (AIN6+)
/ADC_AD777x/ADC_IN6-: C108.2, R85.2, U12.40 (AIN6-)
/ADC_AD777x/ADC_MCLK: U12.32 (XTAL2/MCLK), Y1.3 (OUT)
/ADC_AD777x/ADC_MCLK_EN: R78.2, U6.4 (QE), Y1.1 (Tri-State)
/ADC_AD777x/ADC_REF+: C58.1, C59.1, C60.1, R80.1, U12.8 (REF1+), U12.41 (REF2+)
/ADC_AD777x/ADC_REF_OUT: C61.1, R80.2, U12.49 (REF_OUT)
/ADC_AD777x/ADC_RESET: R75.2, U6.2 (QC), U12.36 (~RESET)
/ADC_AD777x/ADC_SCLK: R22.1, U12.19 (DCLK2/SCLK)
/ADC_AD777x/ADC_SDI: R23.1, U12.20 (DCLK1/SDI)
/ADC_AD777x/ADC_SDO: R61.2, U5.20 (GPIO14)
/ADC_AD777x/ADC_SDO_R: R61.1, U12.21 (DCLK0/SDO)
/ADC_AD777x/ADC_START: R73.1, U6.3 (QD), U12.33 (~START)
/ADC_AD777x/AIN0+: J3.4, R59.1
/ADC_AD777x/AIN0-: J3.5, R57.1
/ADC_AD777x/AIN1+: J3.11, R63.1
/ADC_AD777x/AIN1-: J3.10, R60.1
/ADC_AD777x/AIN2+: J3.8, R65.1
/ADC_AD777x/AIN2-: J3.7, R67.1
/ADC_AD777x/AIN4+: J1.11, R69.1
/ADC_AD777x/AIN4-: J1.10, R68.1
/ADC_AD777x/AIN5+: J1.7, R71.1
/ADC_AD777x/AIN5-: J1.8, R72.1
/ADC_AD777x/AIN7+: J1.5, R74.1
/ADC_AD777x/AIN7-: J1.4, R76.1
/ADC_AD777x/TH1+: J3.13, R66.1
/ADC_AD777x/TH1-: J3.14, R81.1
/ADC_AD777x/TH2+: J1.13, R82.1
/ADC_AD777x/TH2-: J1.14, R85.1
/DATA_SAVING/+5VBUS: J2.A4 (VBUS), J2.B4 (VBUS), R106.1, R108.1
/DATA_SAVING/CC1: J2.B5 (CC2), R25.1
/DATA_SAVING/CC2: J2.A5 (CC1), R24.1
/DATA_SAVING/CRFLIT: C99.1, U17.15 (CRFILT)
/DATA_SAVING/D+: J2.A6 (D+), J2.B6 (D+), U17.42 (USB+)
/DATA_SAVING/D-: J2.A7 (D-), J2.B7 (D-), U17.43 (USB-)
/DATA_SAVING/EN_SD_MUX: R96.2, U4.6 (QG), U16.20 (~EN)
/DATA_SAVING/E_CLK: R101.2, U5.5 (GPIO5), U16.23 (NC3)
/DATA_SAVING/E_CMD: R102.2, U5.9 (GPIO16), U16.21 (NC4)
/DATA_SAVING/E_D0: R100.2, U5.6 (GPIO5), U16.1 (NC2)
/DATA_SAVING/E_D1: R99.2, U5.4 (GPIO4), U16.2 (NC1)
/DATA_SAVING/E_D2: R104.2, U5.7 (GPIO7), U16.22 (NC6)
/DATA_SAVING/E_D3: R103.2, U5.8 (GPIO15), U16.19 (NC5)
/DATA_SAVING/LED_IN: D11.2 (A), R105.2
/DATA_SAVING/LED_OUT: R105.1, U17.37 (LED)
/DATA_SAVING/MCLK: J4.5 (CLK), U16.7 (COM3)
/DATA_SAVING/MCMD: J4.3 (CMD), U16.9 (COM4)
/DATA_SAVING/MD0: J4.7 (DAT0), U16.6 (COM2)
/DATA_SAVING/MD1: J4.8 (DAT1), U16.4 (COM1)
/DATA_SAVING/MD2: J4.1 (DAT2), U16.12 (COM6)
/DATA_SAVING/MD3: J4.2 (DAT3), U16.10 (COM5)
/DATA_SAVING/PLL_FLIT: C98.1, U17.46 (PLLFILT)
/DATA_SAVING/RBIAS: R98.1, U17.47 (RBIAS)
/DATA_SAVING/SD_MUX_SEL: R95.2, U4.15 (QA), U16.14 (IN2), U16.24 (IN1)
/DATA_SAVING/SD_WP: R109.1, U17.13 (SD_WP)
/DATA_SAVING/SD_nCD: R107.1, U17.14 (SD_nCD)
/DATA_SAVING/USB2641_XTAL1: C100.1, U17.45 (XTAL1), X1.1
/DATA_SAVING/USB2641_XTAL2: C97.1, U17.44 (XTAL2), X1.3
/DATA_SAVING/USB2641_nRESET: R97.2, U4.5 (QF), U17.38 (nRESET)
/DATA_SAVING/USB_CLK: U16.15 (NO3), U17.21 (SD_CLK)
/DATA_SAVING/USB_CMD: U16.17 (NO4), U17.24 (SD_CMD)
/DATA_SAVING/USB_D0: U16.13 (NO2), U17.18 (SD_D0)
/DATA_SAVING/USB_D1: U16.11 (NO1), U17.17 (SD_D1)
/DATA_SAVING/USB_D2: U16.16 (NO6), U17.33 (SD_D2)
/DATA_SAVING/USB_D3: U16.18 (NO5), U17.32 (SD_D3)
/DATA_SAVING/VBUS_DET_3V: R106.2, U17.39 (VBUS_DET)
/DEVICE_DETECT_1: J3.2, R20.1, U5.13 (GPIO3)
/DEVICE_DETECT_2: J1.2, R19.1, U5.12 (GPIO8)
/GNSS/GPS_RX: U5.38 (GPIO48), U20.2 (TXD)
/GNSS/GPS_TX: U5.37 (GPIO45), U20.3 (RXD)
/IMU/CS_SCL: U5.14 (GPIO46), U8.5 (CS)
/IMU/MISO: U5.15 (GPIO9), U7.1 (SDO), U8.6 (MISO)
/IMU/MOSI: U5.11 (GPIO18), U7.14 (SDA), U8.7 (MOSI)
/IMU/SCLK: U5.10 (GPIO17), U7.13 (SCL), U8.8 (SCK)
/MCU_ESP32S3/EN_BST_18V: R4.1, U1.5 (CTRL), U4.3 (QD)
/MCU_ESP32S3/EN_SUPERCAP_CHARGE: R46.2, U5.28 (GPIO42)
/MCU_ESP32S3/ESP_CS: R21.2, U5.17 (GPIO11)
/MCU_ESP32S3/ESP_SCLK: R22.2, U5.18 (GPIO12)
/MCU_ESP32S3/ESP_SDO: R23.2, U5.19 (GPIO13)
/MCU_ESP32S3/SR_CHAIN_DATA: U4.9 (QH'), U6.14 (SER)
/MCU_ESP32S3/SR_DATA: U4.14 (SER), U5.42 (GPIO19)
/MCU_ESP32S3/SR_LATCH: U4.12 (RCLK), U5.40 (GPIO21), U6.12 (RCLK)
/MCU_ESP32S3/SR_OE_N: R18.2, U4.13 (~OE), U5.41 (GPIO20), U6.13 (~OE)
/MCU_ESP32S3/SR_SHIFT_CLK: U4.11 (SRCLK), U5.39 (GPIO47), U6.11 (SRCLK)
/POWER/5V_HOLDUP_CAP: C14.1, D9.1 (K), U9.6 (VIN2)
/POWER/5V_STEP_DOWN_IN: C28.1, R48.1, U9.2 (VOUT), U9.7 (VOUT), U10.2 (VIN)
/POWER/5V_SUPERCAP: C36.1, D9.2 (A), R47.2
/POWER/5V_USB_PRESENT: R29.2, U9.8 (ST)
/POWER/+5V_SOLAR: C27.2, C33.1, C102.2, L5.2, R32.2, R37.2, U18.3 (VIN1), U18.5 (MODE)
/POWER/BST_10V_FB: C4.2, R14.2, R17.1, U3.3 (FB)
/POWER/BST_10V_FB_DIV: R12.2, R14.1
/POWER/BST_10V_SW: D2.2 (A), L2.2, U3.1 (SW)
/POWER/INV_N5V5_COMP: C83.1, U15.1 (COMP)
/POWER/INV_N5V5_FB: C75.1, R87.2, R92.1, U15.9 (FB)
/POWER/INV_N5V5_FF: C75.2, R93.1
/POWER/INV_N5V5_SW: D10.1 (K), L4.1, U15.6 (SW)
/POWER/INV_N5V5_VIN: C69.1, R89.1, U15.3 (VIN)
/POWER/INV_N5V5_VREF: C70.1, R87.1, U15.10 (VREF)
/POWER/LDO_9V_ILIM: R13.2, U2.5 (ILIM)
/POWER/LDO_9V_SET: C9.1, R16.1, U2.7 (SET)
/POWER/LDO_N5V_FB: C73.2, R88.2, R90.1, U14.3 (FB)
/POWER/LDO_N5V_NR: C76.1, U14.14 (NR/SS)
/POWER/LDO_P5V_FB: C66.2, R83.2, R84.1, U13.2 (FB)
/POWER/LDO_P5V_NR: C68.1, U13.6 (NR/SS)
/POWER/SOLAR_PRESENT: R42.2, U18.8 (ST)
/POWER/SOLAR_VOLTAGE: C34.1, C101.2, R34.2, U19.3 (VIN)
/POWER/STPD_3V3_BOOT: C26.1, U10.1 (BOOT)
/POWER/STPD_3V3_COMP: C30.1, C31.1, U10.6 (COMP)
/POWER/STPD_3V3_COMP_F: C30.2, R39.1
/POWER/STPD_3V3_PH: C26.2, D4.1 (K), L3.1, U10.8 (PH)
/POWER/STPD_3V3_SS: C32.1, U10.4 (SS)
/POWER/STPD_3V3_VSENS: R38.2, R40.1, U10.5 (VSENSE)
/RESET_1: J3.26, R52.1, U6.6 (QG)
/RESET_2: J1.26, R7.1, U6.15 (QA)
/SCL_1: J3.28, U5.30 (GPIO40)
/SCL_2: J1.28, U5.27 (GPIO2)
/SDA_1: J3.29, U5.29 (GPIO41)
/SDA_2: J1.29, U5.26 (GPIO1)
/SENSOR_SET_RESET_DRIVER/+18V_OUT: C2.1, D1.1 (K), R2.1, R3.1
/SENSOR_SET_RESET_DRIVER/BST_18V_COMP: R5.1, U1.2 (COMP)
/SENSOR_SET_RESET_DRIVER/BST_18V_COMP_FILT: C3.1, R5.2
/SENSOR_SET_RESET_DRIVER/BST_18V_FB: R3.2, R6.1, U1.1 (FB)
/SENSOR_SET_RESET_DRIVER/BST_18V_IN: C1.1, L1.1, R1.2, U1.6 (VIN)
/SENSOR_SET_RESET_DRIVER/BST_18V_SW: D1.2 (A), L1.2, U1.4 (SW)
/SET_1: J3.25, R53.1, U6.7 (QH)
/SET_2: J1.25, R8.1, U6.1 (QB)
GND: C1.2, C2.2, C3.2, C5.2, C6.2, C7.2, C8.2, C9.2, C10.2, C11.2, C12.2, C13.2, C14.2, C15.2, C16.1, C17.1, C18.1, C19.1, C20.1, C21.1, C22.2, C23.1, C24.2, C28.2, C29.2, C31.2, C32.2, C33.2, C34.2, C35.2, C36.2, C37.2, C38.2, C39.2, C40.2, C41.2, C42.2, C43.2, C44.2, C45.2, C46.2, C47.2, C48.2, C55.2, C56.2, C58.2, C59.2, C60.2, C61.2, C62.2, C63.2, C64.2, C65.2, C67.2, C68.2, C69.2, C70.2, C71.2, C72.2, C74.2, C76.2, C77.2, C78.2, C79.2, C80.2, C81.2, C82.2, C83.2, C84.2, C85.2, C86.2, C87.2, C88.2, C89.2, C90.2, C91.2, C92.2, C93.2, C94.1, C95.2, C96.2, C97.2, C98.2, C99.2, C100.2, C101.1, C102.1, C103.2, C104.2, C105.2, C106.2, D4.2 (A), D11.1 (K), J1.1, J1.3, J1.6, J1.9, J1.12, J1.15, J1.16, J1.24, J1.27, J1.30, J1.P1, J1.P2, J2.A1 (GND), J2.B1 (GND), J2.S1 (SHIELD), J3.1, J3.3, J3.6, J3.9, J3.12, J3.15, J3.16, J3.24, J3.27, J3.30, J3.P1, J3.P2, J4.6 (VSS), J4.10 (SHIELD), J4.11 (VSS), J4.12 (VSS), J4.13 (VSS), J4.14 (VSS), J5.2 (Ext_2), L4.2, Q3.2, R4.2, R6.2, R7.2, R8.2, R13.1, R16.2, R17.2, R24.2, R25.2, R31.2, R36.2, R39.2, R40.2, R41.2, R43.2, R49.2, R52.2, R53.2, R56.2, R70.2, R73.2, R84.2, R90.2, R98.2, R107.2, R108.2, R109.2, U1.3 (GND), U1.7 (TP), U2.8 (GND), U2.11 (GND), U3.2 (GND), U4.8 (GND), U5.22 (GND), U5.23 (GND), U5.43 (GND), U5.44 (GND), U6.8 (GND), U7.2 (SDx), U7.3 (SCx), U7.6 (GND), U7.7 (GND), U8.1 (AVSS), U8.3 (RESERVED), U8.11 (DVSS), U8.12 (EMC_GND), U9.1 (GND), U10.7 (GND), U11.2 (GND), U11.4 (NC), U12.5 (AVSS1A), U12.7 (REF1-), U12.22 (DGND), U12.31 (XTAL1), U12.42 (REF2-), U12.44 (AVSS1B), U12.50 (AVSS2B), U12.53 (AVSS3), U12.56 (CLK_SEL), U12.60 (AVSS2A), U12.61 (AVSS4), U12.64 (AUXAIN-), U12.65 (EPAD(AVSSx)), U13.3 (NC), U13.4 (GND), U13.9 (PwPd), U14.7 (GND), U14.21 (EP), U15.2 (GND), U15.7 (PSGND), U15.11 (PowerPAD), U16.5 (GND), U17.40 (TEST), U17.49 (GND), U18.1 (GND), U19.4 (GND), U20.1 (GND), U20.10 (GND), U20.12 (GND), X1.2, X1.4, Y1.2 (GND)
unnamed: D8.2 (A), Q2.3
unnamed: D8.1 (K), R47.1
unnamed: Q2.1, R45.2
unnamed: Q3.1, R46.1, R49.1
unnamed: Q3.3, R44.2, R45.1
unnamed: R77.2, U4.10 (~SRCLR)
unnamed: R79.2, U6.10 (~SRCLR)
unnamed: TP3.1 (1_1), U7.4 (INT1)
unnamed: TP4.1 (1_1), U7.9 (INT2)
unnamed: C21.2, U8.2 (A_EXTC)
unnamed: C20.2, U8.10 (D_EXTC)
unnamed: R30.1, R31.1, U9.4 (PR1)
unnamed: R43.1, R48.2, U10.3 (EN)
unnamed: U12.34 (~SYNC_OUT), U12.35 (~SYNC_IN)
unnamed: R37.1, R41.1, U18.4 (PR1)
unnamed: C22.1, FB1.2, U18.6 (VIN2)
unnamed: C25.2, U19.6 (BST)
unnamed: R34.1, U19.2 (EN)
unnamed: C27.1, R32.1, U19.8 (FB)
unnamed: R36.1, U19.1 (RT)
unnamed: C35.1, U19.7 (SS)
unnamed: C25.1, L5.1, U19.5 (SW)
