Benjamin-girard-1/magnetometer-node/hardware/pcb/Expension_card_design/magnetic_expension_v2/magnetic_expension_v2.kicad_pcb

## KiCad design hardware/pcb/Expension_card_design/magnetic_expension_v2/magnetic_expension_v2.kicad_pcb (2026-06-26)

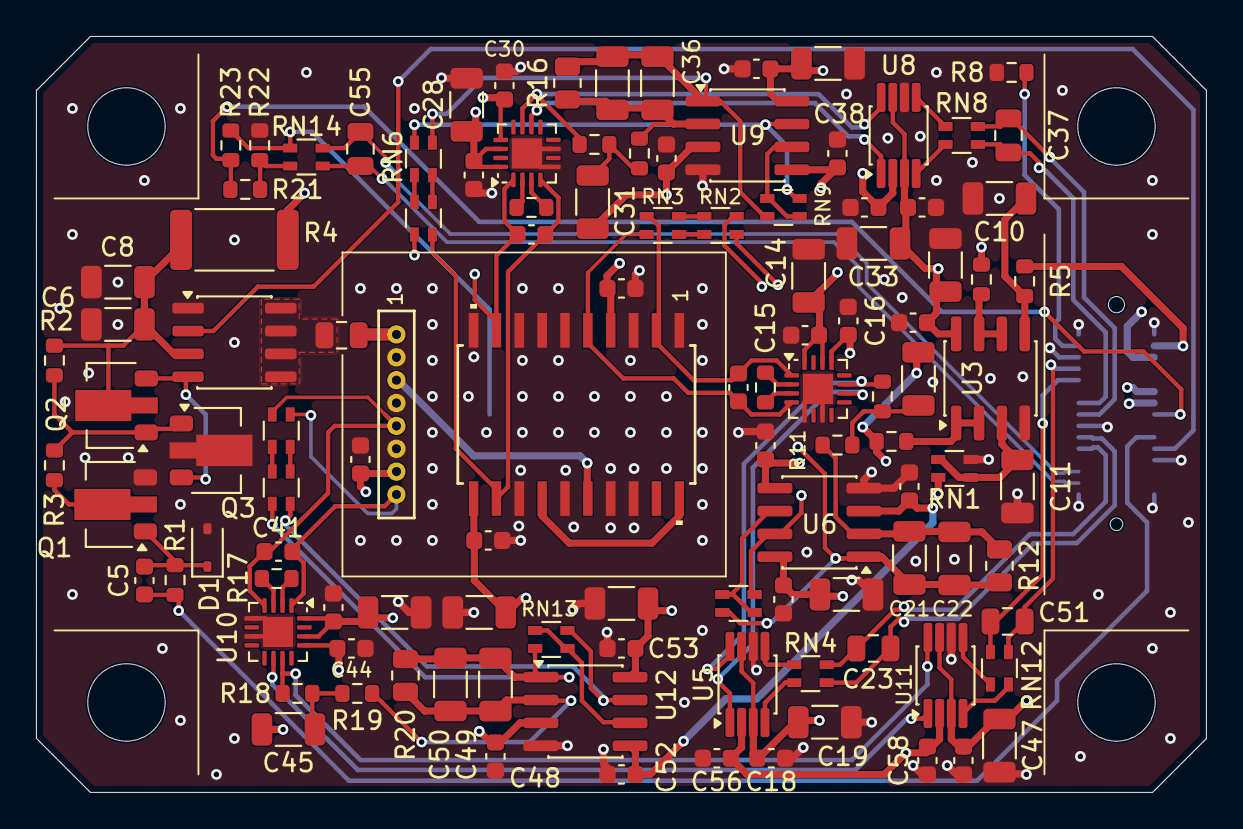
[picture p43: board magnetic_expension_v2.kicad_pcb from above]

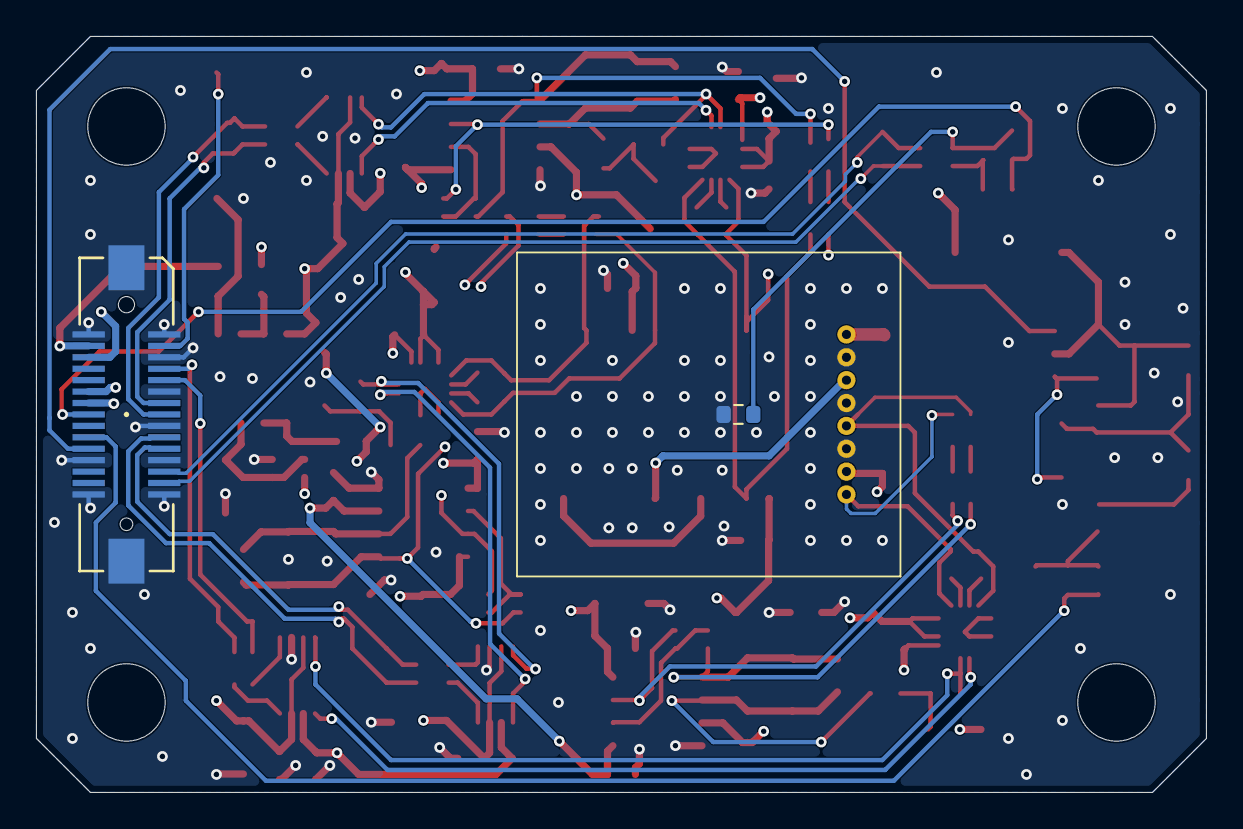
[picture p44: board magnetic_expension_v2.kicad_pcb from below]

Board: 4 copper layers, 65.0 x 42.0 mm, 118 parts (2 on the bottom side), 79 nets.

Parts:
C1, C6, C8: 10u; C_1206_3216Metric
C2, C3, C4, C9, C15, C16, C18, C20, C24, C25, C29, C30, C32, C34, C38, C39, C43, C44, C46, C48, C52, C53, C56, C57, C58: 100n; C_0603_1608Metric
C5: 1n; C_0603_1608Metric
C7, C23, C37, C51, C55: 220n; C_0805_2012Metric
C10, C11, C12, C14, C19, C21, C22, C26, C28, C33, C35, C36, C40, C42, C47, C49, C50, C54: 4u7; C_1206_3216Metric
C13, C27, C41: 10n; C_0603_1608Metric
C17, C31, C45: 47u; C_1206_3216Metric
D1: 1N4148WS; D_SOD-323
H1, H2, H3, H4: MountingHole; MountingHole_4.3mm_M4
J1: 528850374; CONN_MOLEX_02x15_52885-0374
Q1, Q2: D882; SOT-89-3
Q3: B772; SOT-89-3
Q4: DMC3028LSD; SO-8_3.9x4.9mm_P1.27mm
R1, R2, R3, R5: 1k; R_0603_1608Metric
R4: 220; R_2512_6332Metric
R6, R7: 20; R_0603_1608Metric
R8, R11, R15, R19: 20k; R_0603_1608Metric
R9, R13, R17: 120; R_0603_1608Metric
R10, R14, R18: 300k; R_0603_1608Metric
R12, R16, R20: 100M; R_0805_2012Metric
R21, R22, R23: 100k; R_0603_1608Metric
RN1: 10k; R_Array_Convex_2x0603
RN2, RN3, RN5, RN6, RN7, RN9, RN10, RN11, RN13: 20k; R_Array_Convex_2x0603
RN4, RN8, RN12, RN14: 1k; R_Array_Convex_2x0603
TH1: 100k NTC; R_0603_1608Metric
U1: HMC1001-RC; SIP8_HMC1001_HNW
U2: HMC1002-TR; SOIC20_HNW
U3, U6, U9, U12: OPA2197xD; SOIC-8_3.9x4.9mm_P1.27mm
U4, U7, U10: INA851RGTR; VQFN-16-1EP_3x3mm_P0.5mm_EP1.68x1.68mm
U5, U8, U11: THP210DGK; VSSOP-8_3x3mm_P0.65mm

Connections:
+1V65: J1.17, R5.1
+1V65B: C56.1, C57.1, C58.1, R7.2, U5.2 (VCM), U8.2 (VCM), U11.2 (VCM)
+3V3A: J1.23, R21.2, R23.2
+4V5B: C16.1, C17.2, C20.1, C24.1, C30.1, C31.2, C34.1, C38.1, C44.1, C45.2, C48.1, C52.1, R6.2, U4.13 (VOCM), U6.3 (+), U6.5 (+), U7.13 (VOCM), U9.3 (+), U9.5 (+), U10.13 (VOCM), U12.3 (+), U12.5 (+)
+9VA: C9.1, C12.1, C14.1, C15.1, C18.1, C19.1, C25.1, C26.1, C28.1, C29.1, C32.1, C33.1, C39.1, C40.1, C42.1, C43.1, C46.1, C47.1, C53.1, C54.1, J1.21, U3.8 (V+), U4.14 (VS+), U4.16 (VCLAMP+), U5.3 (V+), U5.7 (~PD), U6.8 (V+), U7.14 (VS+), U7.16 (VCLAMP+), U8.3 (V+), U8.7 (~PD), U9.8 (V+), U10.14 (VS+), U10.16 (VCLAMP+), U11.3 (V+), U11.7 (~PD), U12.8 (V+)
+9Vb: C1.1, C2.1, C3.1, C4.1, J1.22, RN1.2 (R2.1), U1.7 (VBRIDGE), U2.4 (VBRIDGE(A)), U2.11 (VBRIDGE(B))
+18V: J1.18, R4.2
/CONNECTOR/DEVICE_DETECT: J1.2, R8.1
/CONNECTOR/SENSOR_RESET_CTRL: J1.26, Q4.2 (G1)
/CONNECTOR/SENSOR_SET_CTRL: C5.1, J1.25, R1.1
/CONNECTOR/TH+: C55.1, J1.13, RN14.2 (R2.1)
/CONNECTOR/TH-: C55.2, J1.14, RN14.1 (R1.1)
/CONNECTOR/X_CONN+: C23.2, J1.10, RN4.1 (R1.1)
/CONNECTOR/X_CONN-: C23.1, J1.11, RN4.2 (R2.1)
/CONNECTOR/Y_CONN+: C37.2, J1.7, RN8.1 (R1.1)
/CONNECTOR/Y_CONN-: C37.1, J1.8, RN8.2 (R2.1)
/CONNECTOR/Z_CONN+: C51.2, J1.4, RN12.1 (R1.1)
/CONNECTOR/Z_CONN-: C51.1, J1.5, RN12.2 (R2.1)
/SENSOR_3AXIS_HMC100X/BR_X+: C13.1, RN3.1 (R1.1), U2.2 (OUT+(A)), U4.1 (IN-)
/SENSOR_3AXIS_HMC100X/BR_X-: C13.2, RN3.2 (R2.1), U2.5 (OUT-(A)), U4.4 (IN+)
/SENSOR_3AXIS_HMC100X/BR_Y+: C27.1, RN7.1 (R1.1), U2.9 (OUT+(B)), U7.1 (IN-)
/SENSOR_3AXIS_HMC100X/BR_Y-: C27.2, RN7.2 (R2.1), U2.12 (OUT-(B)), U7.4 (IN+)
/SENSOR_3AXIS_HMC100X/BR_Z+: C41.1, RN11.1 (R1.1), U1.8 (OUT-), U10.1 (IN-)
/SENSOR_3AXIS_HMC100X/BR_Z-: C41.2, RN11.2 (R2.1), U1.5 (OUT+), U10.4 (IN+)
/SENSOR_3AXIS_HMC100X/SETRESET_AFTER_1001: U1.3 (S/R-), U2.16 (S/R+(A))
/SENSOR_3AXIS_HMC100X/SETRESET_AFTER_1002A: U2.14 (S/R+(B)), U2.20 (S/R-(A))
/SENSOR_3AXIS_HMC100X/SETRESET_STRAP: C7.2, U1.1 (S/R+)
/SENSOR_SET_RESET_DRIVER/3V3_SET_CTRL: C5.2, D1.1 (K), Q1.1 (B), R1.2
/SENSOR_SET_RESET_DRIVER/18V_BUF: Q2.1 (B), Q3.1, R2.2, R3.1
/SENSOR_SET_RESET_DRIVER/18V_IN: C6.1, C8.1, Q2.2 (C), Q4.3 (S2), R2.1, R4.1
/SENSOR_SET_RESET_DRIVER/18V_PULSE: C7.1, Q4.5 (D2), Q4.6 (D2), Q4.7 (D1), Q4.8 (D1)
/SENSOR_SET_RESET_DRIVER/PULL_DOWN: Q1.2 (C), R3.2
/SENSOR_SET_RESET_DRIVER/PULSE_SET_CTRL: Q2.3 (E), Q3.3, Q4.4 (G2)
/THERMISTOR/TH_BRIDGE+: R21.1, R22.1, RN14.4 (R1.2)
/THERMISTOR/TH_BRIDGE-: R23.1, RN14.3 (R2.2), TH1.2
/VOLTAGE_REF/1V65_FB: R7.1, U3.6 (-), U3.7
/VOLTAGE_REF/1V65_FLTR: C10.1, R5.2, U3.5 (+)
/VOLTAGE_REF/4V5_DIV: C11.1, RN1.1 (R1.1), RN1.3 (R2.2), U3.3 (+)
/VOLTAGE_REF/4V5_FB: R6.1, U3.1, U3.2 (-)
/X_BALANCING/COMP+: C21.2, C22.2, R12.2, RN2.3 (R2.2), RN5.4 (R1.2), U6.1
/X_BALANCING/COMP-: RN2.4 (R1.2), RN5.2 (R2.1), U6.7
/X_BALANCING/INA_OUT+: R10.1, U4.11 (OUT+), U5.8 (+)
/X_BALANCING/INA_OUT-: U4.10 (OUT-), U5.1 (-)
/X_BALANCING/INA_OUT_FLTR+: C17.1, R10.2, R11.1
/X_BALANCING/INT_FB: C21.1, C22.1, R11.2, R12.1, U6.2 (-)
/X_BALANCING/INV_FB: RN5.1 (R1.1), RN5.3 (R2.2), U6.6 (-)
/X_BALANCING/THP_OUT+: RN4.4 (R1.2), U5.4
/X_BALANCING/THP_OUT-: RN4.3 (R2.2), U5.5
/X_BALANCING/X_RG+: R9.2, U4.2 (RG+)
/X_BALANCING/X_RG-: R9.1, U4.3 (RG-)
/Y_BALANCING/COMP+: C35.2, C36.2, R16.2, RN6.3 (R2.2), RN9.4 (R1.2), U9.1
/Y_BALANCING/COMP-: RN6.4 (R1.2), RN9.2 (R2.1), U9.7
/Y_BALANCING/INA_OUT+: R14.1, U7.11 (OUT+), U8.8 (+)
/Y_BALANCING/INA_OUT-: U7.10 (OUT-), U8.1 (-)
/Y_BALANCING/INA_OUT_FLTR+: C31.1, R14.2, R15.1
/Y_BALANCING/INT_FB: C35.1, C36.1, R15.2, R16.1, U9.2 (-)
/Y_BALANCING/INV_FB: RN9.1 (R1.1), RN9.3 (R2.2), U9.6 (-)
/Y_BALANCING/THP_OUT+: RN8.4 (R1.2), U8.4
/Y_BALANCING/THP_OUT-: RN8.3 (R2.2), U8.5
/Y_BALANCING/X_RG+: R13.2, U7.2 (RG+)
/Y_BALANCING/X_RG-: R13.1, U7.3 (RG-)
/Z_BALANCING/COMP+: C49.2, C50.2, R20.2, RN10.3 (R2.2), RN13.4 (R1.2), U12.1
/Z_BALANCING/COMP-: RN10.4 (R1.2), RN13.2 (R2.1), U12.7
/Z_BALANCING/INA_OUT+: R18.1, U10.11 (OUT+), U11.8 (+)
/Z_BALANCING/INA_OUT-: U10.10 (OUT-), U11.1 (-)
/Z_BALANCING/INA_OUT_FLTR+: C45.1, R18.2, R19.1
/Z_BALANCING/INT_FB: C49.1, C50.1, R19.2, R20.1, U12.2 (-)
/Z_BALANCING/INV_FB: RN13.1 (R1.1), RN13.3 (R2.2), U12.6 (-)
/Z_BALANCING/THP_OUT+: RN12.4 (R1.2), U11.4
/Z_BALANCING/THP_OUT-: RN12.3 (R2.2), U11.5
/Z_BALANCING/X_RG+: R17.2, U10.2 (RG+)
/Z_BALANCING/X_RG-: R17.1, U10.3 (RG-)
GND: C1.2, C2.2, C3.2, C4.2, C6.2, C8.2, C9.2, C10.2, C11.2, C12.2, C14.2, C15.2, C16.2, C18.2, C19.2, C20.2, C24.2, C25.2, C26.2, C28.2, C29.2, C30.2, C32.2, C33.2, C34.2, C38.2, C39.2, C40.2, C42.2, C43.2, C44.2, C46.2, C47.2, C48.2, C52.2, C53.2, C54.2, C56.2, C57.2, C58.2, D1.2 (A), J1.1, J1.3, J1.6, J1.9, J1.12, J1.15, J1.16, J1.27, J1.30, J1.P1, J1.P2, Q1.3 (E), Q3.2, Q4.1 (S1), R8.2, R22.2, RN1.4 (R1.2), TH1.1, U1.2 (OFFSET+), U1.4 (GND), U1.6 (OFFSET-), U2.1 (GND1(A)), U2.3 (OFFSET-(A)), U2.6 (GND2(A)), U2.7 (S/R-(B)), U2.8 (GND1(B)), U2.10 (OFFSET-(B)), U2.13 (GND2(B)), U2.15 (OFFSET+(B)), U2.17 (OFFSET(+A)), U2.18 (GND_PLN), U3.4 (V-), U4.5 (VCLAMP-), U4.7 (VS-), U4.17 (TP), U5.6 (V-), U6.4 (V-), U7.5 (VCLAMP-), U7.7 (VS-), U7.17 (TP), U8.6 (V-), U9.4 (V-), U10.5 (VCLAMP-), U10.7 (VS-), U10.17 (TP), U11.6 (V-), U12.4 (V-)
unnamed: RN2.1 (R1.1), RN3.4 (R1.2)
unnamed: RN2.2 (R2.1), RN3.3 (R2.2)
unnamed: RN6.1 (R1.1), RN7.4 (R1.2)
unnamed: RN6.2 (R2.1), RN7.3 (R2.2)
unnamed: RN10.1 (R1.1), RN11.4 (R1.2)
unnamed: RN10.2 (R2.1), RN11.3 (R2.2)
