Benjamin-girard-1/magnetometer-node/hardware/pcb/Expension_card_design/magnetic_expension/magnetic_expension.kicad_pcb

## KiCad design hardware/pcb/Expension_card_design/magnetic_expension/magnetic_expension.kicad_pcb (2026-06-23, an earlier design)

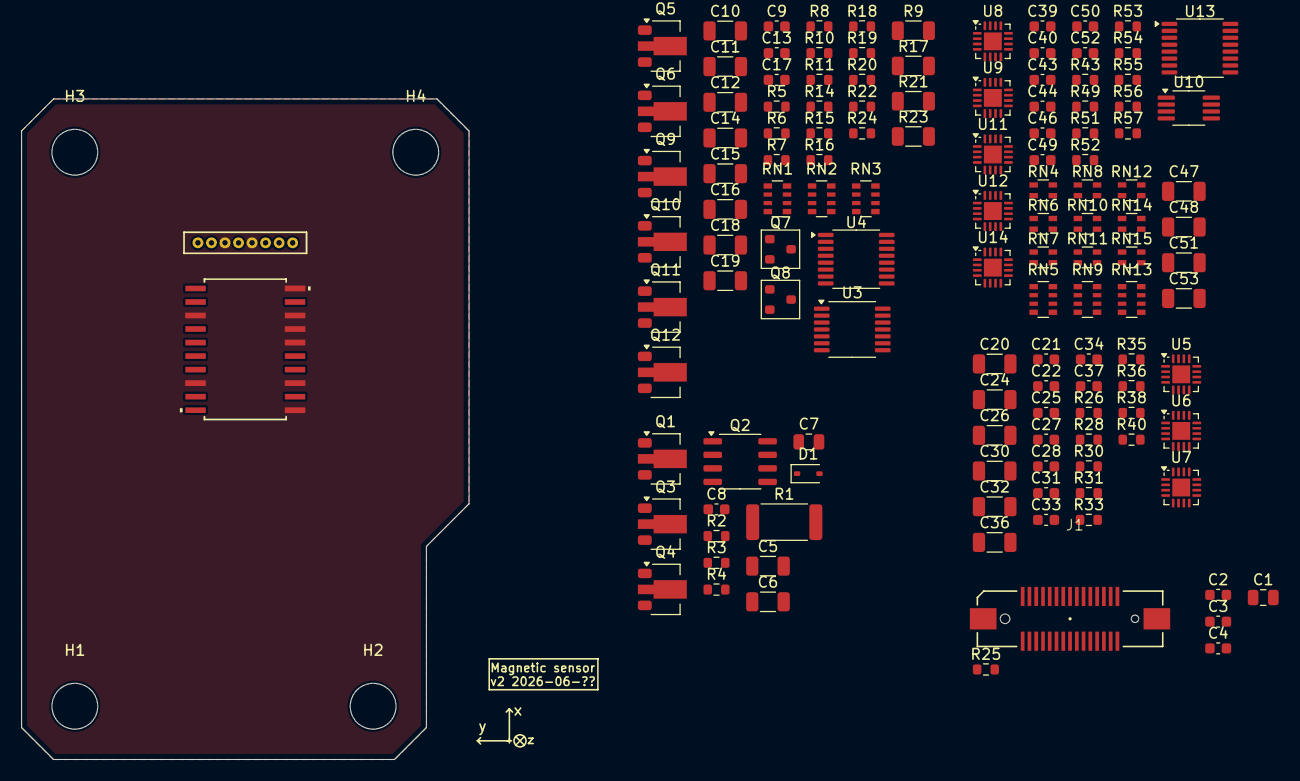
[picture p45: board magnetic_expension.kicad_pcb from above]

Board: 4 copper layers, 42.0 x 62.0 mm, 134 parts (0 on the bottom side), 101 nets, no tracks yet.

Parts:
C1: 10u; C_0805_2012Metric
C2, C3, C4, C9, C13, C17, C21, C25, C27, C31, C33, C37, C46, C52: 100n; C_0603_1608Metric
C5, C6: 10u; C_1206_3216Metric
C7: 220n; C_0805_2012Metric
C8, C39, C43, C49: 1n; C_0603_1608Metric
C10, C11, C12, C14, C15, C16, C18, C19, C20, C24, C26, C30, C32, C36, C47, C48, C51, C53: 4u7; C_1206_3216Metric
C22, C28, C34: 10n; C_0603_1608Metric
C40, C44, C50: 220n; C_0603_1608Metric
D1: 1N4148WS; D_SOD-323
H1, H2, H3, H4: MountingHole; MountingHole_4.3mm_M4
J1: 528850374; CONN_MOLEX_02x15_52885-0374
Q1, Q4, Q5, Q9, Q11: D882; SOT-89-3
Q2: DMC3028LSD; SO-8_3.9x4.9mm_P1.27mm
Q3, Q6, Q10, Q12: B772; SOT-89-3
Q7: MMBT5551; SOT-23
Q8: MMBT5401; SOT-23
R1: 220; R_2512_6332Metric
R2, R3, R4, R43, R49, R51, R52, R53, R55, R56, R57: 1k; R_0603_1608Metric
R5, R10, R14, R18, R19, R24: 470; R_0603_1608Metric
R6, R8, R15, R16, R20, R22: 22k; R_0603_1608Metric
R7: 10; R_0603_1608Metric
R9, R17, R23: 200; R_1206_3216Metric
R11, R25, R54: 20k; R_0603_1608Metric
R21: 20; R_1206_3216Metric
R26, R30, R31, R35, R36, R40: 49.9; R_0603_1608Metric
R28, R33, R38: 100; R_0603_1608Metric
RN1, RN2, RN3, RN5, RN9, RN13: 10k; R_Array_Convex_4x0603
RN4, RN8, RN12: 20k; R_Array_Convex_2x0603
RN6, RN7, RN10, RN11, RN14, RN15: 5k; R_Array_Convex_2x0603
U1: HMC1001-RC; SIP8_HMC1001_HNW
U2: HMC1002-TR; SOIC20_HNW
U3: OPA4197xPW; TSSOP-14_4.4x5mm_P0.65mm
U4, U13: DAC7678SPWR; TSSOP-16_4.4x5mm_P0.65mm
U5, U6, U7: INA851RGTR; VQFN-16-1EP_3x3mm_P0.5mm_EP1.68x1.68mm
U8, U9, U11, U12, U14: THS4551IRGTR; VQFN-16-1EP_3x3mm_P0.5mm_EP1.68x1.68mm
U10: DAC8571IDGK; MSOP-8_3x3mm_P0.65mm

Connections:
+1V65: J1.17, U3.12 (+)
+1V65B: C17.1, R21.2, U5.13 (VOCM), U6.13 (VOCM), U7.13 (VOCM), U8.9 (V_{OCM}), U9.9 (V_{OCM}), U11.9 (V_{OCM}), U12.9 (V_{OCM}), U14.9 (V_{OCM})
+3V3A: C46.1, C47.1, C52.1, C53.1, J1.22, U5.16 (VCLAMP+), U6.16 (VCLAMP+), U7.16 (VCLAMP+), U8.5 (V_{S+}), U8.6 (V_{S+}), U8.7 (V_{S+}), U8.8 (V_{S+}), U9.5 (V_{S+}), U9.6 (V_{S+}), U9.7 (V_{S+}), U9.8 (V_{S+}), U11.5 (V_{S+}), U11.6 (V_{S+}), U11.7 (V_{S+}), U11.8 (V_{S+}), U11.12 (~PD), U12.5 (V_{S+}), U12.6 (V_{S+}), U12.7 (V_{S+}), U12.8 (V_{S+}), U12.12 (~PD), U13.2 (ADDR0), U13.3 (AV_{DD}), U13.8 (V_{REFIN}/V_{REFOUT}), U14.5 (V_{S+}), U14.6 (V_{S+}), U14.7 (V_{S+}), U14.8 (V_{S+}), U14.12 (~PD)
+5VA: C20.1, C21.1, C24.1, C25.1, C30.1, C31.1, J1.19, Q5.2, Q9.2, Q11.2, R7.1, R11.2, R54.2, U3.4 (V+), U5.14 (VS+), U6.14 (VS+), U7.14 (VS+)
+9VA: C1.1, C2.1, C3.1, C4.1, J1.21, U1.7 (VBRIDGE), U2.4 (VBRIDGE(A)), U2.11 (VBRIDGE(B))
+18V: J1.18, R1.2
-5VA: C26.1, C27.1, C32.1, C33.1, C36.1, C37.1, J1.20, Q6.2, Q10.2, Q12.2, U3.11 (V-), U5.7 (VS-), U6.7 (VS-), U7.7 (VS-)
/BRIDGE_OFFSET/DAC_B_OUTA: RN5.8 (R1.2), U13.4 (V_{OUT}A)
/BRIDGE_OFFSET/DAC_B_OUTB: RN5.6 (R3.2), U13.13 (V_{OUT}B)
/BRIDGE_OFFSET/DAC_B_OUTC: RN9.8 (R1.2), U13.5 (V_{OUT}C)
/BRIDGE_OFFSET/DAC_B_OUTD: RN9.6 (R3.2), U13.12 (V_{OUT}D)
/BRIDGE_OFFSET/DAC_B_OUTE: RN13.8 (R1.2), U13.6 (V_{OUT}E)
/BRIDGE_OFFSET/DAC_B_OUTF: RN13.6 (R3.2), U13.11 (V_{OUT}F)
/BRIDGE_OFFSET/V_{OUT}+: R49.2, U9.10 (+)
/BRIDGE_OFFSET/V_{OUT}-: R43.2, U9.11 (-)
/BRIDGE_OFFSET/X_COMP_FILT+: RN5.1 (R1.1), RN5.7 (R2.2)
/BRIDGE_OFFSET/X_COMP_FILT-: RN5.3 (R3.1), RN5.5 (R4.2)
/BRIDGE_OFFSET/X_CONN+: C40.2, C50.2, J1.10, R52.2, R57.2
/BRIDGE_OFFSET/X_CONN-: C40.1, C50.1, J1.11, R51.2, R56.2
/BRIDGE_OFFSET/X_INA_FILT+: C39.1, RN6.2 (R2.1), RN7.3 (R2.2)
/BRIDGE_OFFSET/X_INA_FILT-: C39.2, RN6.1 (R1.1), RN7.4 (R1.2)
/BRIDGE_OFFSET/X_SUM_FB+: RN4.3 (R2.2), RN5.4 (R4.1), RN7.2 (R2.1), U11.3 (-)
/BRIDGE_OFFSET/X_SUM_FB-: RN4.4 (R1.2), RN5.2 (R2.1), RN7.1 (R1.1), U11.2 (+)
/BRIDGE_OFFSET/X_SUM_OUT+: R52.1, RN4.2 (R2.1), U11.10 (+)
/BRIDGE_OFFSET/X_SUM_OUT-: R51.1, RN4.1 (R1.1), U11.11 (-)
/BRIDGE_OFFSET/Y_COMP_FILT+: RN9.1 (R1.1), RN9.7 (R2.2)
/BRIDGE_OFFSET/Y_COMP_FILT-: RN9.3 (R3.1), RN9.5 (R4.2)
/BRIDGE_OFFSET/Y_CONN+: C44.2, J1.7, R55.2
/BRIDGE_OFFSET/Y_CONN-: C44.1, J1.8, R53.2
/BRIDGE_OFFSET/Y_INA_FILT+: C43.1, RN10.2 (R2.1), RN11.3 (R2.2)
/BRIDGE_OFFSET/Y_INA_FILT-: C43.2, RN10.1 (R1.1), RN11.4 (R1.2)
/BRIDGE_OFFSET/Y_SUM_FB+: RN8.3 (R2.2), RN9.4 (R4.1), RN11.2 (R2.1), U12.3 (-)
/BRIDGE_OFFSET/Y_SUM_FB-: RN8.4 (R1.2), RN9.2 (R2.1), RN11.1 (R1.1), U12.2 (+)
/BRIDGE_OFFSET/Y_SUM_OUT+: R55.1, RN8.2 (R2.1), U12.10 (+)
/BRIDGE_OFFSET/Y_SUM_OUT-: R53.1, RN8.1 (R1.1), U12.11 (-)
/BRIDGE_OFFSET/Z_COMP_FILT+: C48.1, RN13.1 (R1.1), RN13.7 (R2.2)
/BRIDGE_OFFSET/Z_COMP_FILT-: C51.1, RN13.3 (R3.1), RN13.5 (R4.2)
/BRIDGE_OFFSET/Z_INA_FILT+: C49.1, RN14.2 (R2.1), RN15.3 (R2.2)
/BRIDGE_OFFSET/Z_INA_FILT-: C49.2, RN14.1 (R1.1), RN15.4 (R1.2)
/BRIDGE_OFFSET/Z_SUM_FB+: RN12.3 (R2.2), RN13.4 (R4.1), RN15.2 (R2.1), U14.3 (-)
/BRIDGE_OFFSET/Z_SUM_FB-: RN12.4 (R1.2), RN13.2 (R2.1), RN15.1 (R1.1), U14.2 (+)
/BRIDGE_OFFSET/Z_SUM_OUT+: R57.1, RN12.2 (R2.1), U14.10 (+)
/BRIDGE_OFFSET/Z_SUM_OUT-: R56.1, RN12.1 (R1.1), U14.11 (-)
/CONNECTOR/DEVICE_DETECT: J1.2, R25.1
/CONNECTOR/I2C.SCL: J1.28, U4.16 (SCL)
/CONNECTOR/I2C.SDA: J1.29, U4.15 (SDA)
/CONNECTOR/SENSOR_RESET_CTRL: J1.26, Q2.2 (G1)
/CONNECTOR/SENSOR_SET_CTRL: C8.1, J1.25, R4.1
/INA_GAIN/BR_FTL_X+: C22.1, C28.1, C34.1, R26.2, R31.2, R36.2, U5.1 (IN-), U6.1 (IN-), U7.1 (IN-)
/INA_GAIN/BR_FTL_X-: C22.2, C28.2, C34.2, R30.2, R35.2, R40.2, U5.4 (IN+), U6.4 (IN+), U7.4 (IN+)
/INA_GAIN/BR_X+: R26.1, U2.2 (OUT+(A))
/INA_GAIN/BR_X-: R30.1, U2.5 (OUT-(A))
/INA_GAIN/BR_Y+: R36.1, U2.9 (OUT+(B))
/INA_GAIN/BR_Y-: R40.1, U2.12 (OUT-(B))
/INA_GAIN/BR_Z+: R31.1, U1.8 (OUT-)
/INA_GAIN/BR_Z-: R35.1, U1.5 (OUT+)
/INA_GAIN/X_RG+: R28.2, U5.2 (RG+)
/INA_GAIN/X_RG-: R28.1, U5.3 (RG-)
/INA_GAIN/Y_RG+: R38.2, U7.2 (RG+)
/INA_GAIN/Y_RG-: R38.1, U7.3 (RG-)
/INA_GAIN/Z_RG+: R33.2, U6.2 (RG+)
/INA_GAIN/Z_RG-: R33.1, U6.3 (RG-)
/MAGNETIC_OFFSET_DRIVERS/1V65_FB: R21.1, U3.13 (-), U3.14
/MAGNETIC_OFFSET_DRIVERS/OFFSET_X+: R9.2, RN1.5, U2.17 (OFFSET(+A))
/MAGNETIC_OFFSET_DRIVERS/OFFSET_Y+: R17.2, RN2.5, U2.15 (OFFSET+(B))
/MAGNETIC_OFFSET_DRIVERS/OFFSET_Z+: R23.2, RN3.5, U1.2 (OFFSET+)
/MAGNETIC_OFFSET_DRIVERS/OFF_X_BN: Q5.1, R5.2, R6.2
/MAGNETIC_OFFSET_DRIVERS/OFF_X_BP: Q6.1, R8.2, R10.2
/MAGNETIC_OFFSET_DRIVERS/OFF_X_DRV: R5.1, R10.1, U3.1
/MAGNETIC_OFFSET_DRIVERS/OFF_X_INN: C11.1, RN1.4, RN1.7, U3.2 (-)
/MAGNETIC_OFFSET_DRIVERS/OFF_X_INP: C12.1, RN1.3, RN1.8, U3.3 (+)
/MAGNETIC_OFFSET_DRIVERS/OFF_X_SENSE_P: Q5.3, Q6.3, R6.1, R8.1, R9.1, RN1.6
/MAGNETIC_OFFSET_DRIVERS/OFF_Y_BN: Q9.1, R14.2, R15.2
/MAGNETIC_OFFSET_DRIVERS/OFF_Y_BP: Q10.1, R16.2, R18.2
/MAGNETIC_OFFSET_DRIVERS/OFF_Y_DRV: R14.1, R18.1, U3.7
/MAGNETIC_OFFSET_DRIVERS/OFF_Y_INN: C15.1, RN2.4, RN2.7, U3.6 (-)
/MAGNETIC_OFFSET_DRIVERS/OFF_Y_INP: C16.1, RN2.3, RN2.8, U3.5 (+)
/MAGNETIC_OFFSET_DRIVERS/OFF_Y_SENSE_P: Q9.3, Q10.3, R15.1, R16.1, R17.1, RN2.6
/MAGNETIC_OFFSET_DRIVERS/OFF_Z_BN: Q11.1, R19.2, R20.2
/MAGNETIC_OFFSET_DRIVERS/OFF_Z_BP: Q12.1, R22.2, R24.2
/MAGNETIC_OFFSET_DRIVERS/OFF_Z_DRV: R19.1, R24.1, U3.8
/MAGNETIC_OFFSET_DRIVERS/OFF_Z_INN: C18.1, RN3.4, RN3.7, U3.9 (-)
/MAGNETIC_OFFSET_DRIVERS/OFF_Z_INP: C19.1, RN3.3, RN3.8, U3.10 (+)
/MAGNETIC_OFFSET_DRIVERS/OFF_Z_SENSE_P: Q11.3, Q12.3, R20.1, R22.1, R23.1, RN3.6
/SENSOR_3AXIS_HMC100X/SETRESET_AFTER_1001: U1.3 (S/R-), U2.16 (S/R+(A))
/SENSOR_3AXIS_HMC100X/SETRESET_AFTER_1002A: U2.14 (S/R+(B)), U2.20 (S/R-(A))
/SENSOR_3AXIS_HMC100X/SETRESET_STRAP: C7.2, U1.1 (S/R+)
/SENSOR_SET_RESET_DRIVER/3V3_SET_CTRL: C8.2, D1.1 (K), Q4.1 (B), R4.2
/SENSOR_SET_RESET_DRIVER/18V_BUF: Q1.1 (B), Q3.1, R2.2, R3.1
/SENSOR_SET_RESET_DRIVER/18V_IN: C5.1, C6.1, Q1.2 (C), Q2.3 (S2), R1.1, R2.1
/SENSOR_SET_RESET_DRIVER/18V_PULSE: C7.1, Q2.5 (D2), Q2.6 (D2), Q2.7 (D1), Q2.8 (D1)
/SENSOR_SET_RESET_DRIVER/PULL_DOWN: Q4.2 (C), R3.2
/SENSOR_SET_RESET_DRIVER/PULSE_SET_CTRL: Q1.3 (E), Q2.4 (G2), Q3.3
GND: C1.2, C2.2, C3.2, C4.2, C5.2, C6.2, C9.2, C10.2, C11.2, C12.2, C13.2, C14.2, C15.2, C16.2, C17.2, C18.2, C19.2, C20.2, C21.2, C24.2, C25.2, C26.2, C27.2, C30.2, C31.2, C32.2, C33.2, C36.2, C37.2, C46.2, C47.2, C48.2, C51.2, C52.2, C53.2, D1.2 (A), J1.1, J1.3, J1.6, J1.9, J1.12, J1.15, J1.16, J1.24, J1.27, J1.30, J1.P1, J1.P2, Q2.1 (S1), Q3.2, Q4.3 (E), R25.2, U1.4 (GND), U1.6 (OFFSET-), U2.1 (GND1(A)), U2.3 (OFFSET-(A)), U2.6 (GND2(A)), U2.7 (S/R-(B)), U2.8 (GND1(B)), U2.10 (OFFSET-(B)), U2.13 (GND2(B)), U2.18 (GND_PLN), U4.2 (ADDR0), U4.14 (GND), U5.5 (VCLAMP-), U5.17 (TP), U6.5 (VCLAMP-), U6.17 (TP), U7.5 (VCLAMP-), U7.17 (TP), U8.13 (V_{S-}), U8.14 (V_{S-}), U8.15 (V_{S-}), U8.16 (V_{S-}), U8.17 (EP), U9.13 (V_{S-}), U9.14 (V_{S-}), U9.15 (V_{S-}), U9.16 (V_{S-}), U9.17 (EP), U10.8 (GND), U11.13 (V_{S-}), U11.14 (V_{S-}), U11.15 (V_{S-}), U11.16 (V_{S-}), U11.17 (EP), U12.13 (V_{S-}), U12.14 (V_{S-}), U12.15 (V_{S-}), U12.16 (V_{S-}), U12.17 (EP), U13.14 (GND), U14.13 (V_{S-}), U14.14 (V_{S-}), U14.15 (V_{S-}), U14.16 (V_{S-}), U14.17 (EP)
unnamed: Q7.2 (E), Q8.2 (E)
unnamed: R43.1, U9.2 (+)
unnamed: R49.1, U9.3 (-)
unnamed: C9.1, C10.1, R7.2, U4.3 (AV_{DD})
unnamed: C13.1, C14.1, U4.8 (V_{REFIN}/V_{REFOUT})
unnamed: R11.1, U4.9 (~CLR)
unnamed: R54.1, U13.9 (~CLR)
