Benjamin-girard-1/magnetometer-node/hardware/pcb/Expension_card_design/Commande mars 2026/magnetic_board/Untitled/Untitled.kicad_pcb

## KiCad design hardware/pcb/Expension_card_design/Commande mars 2026/magnetic_board/Untitled/Untitled.kicad_pcb (2026-04-30)

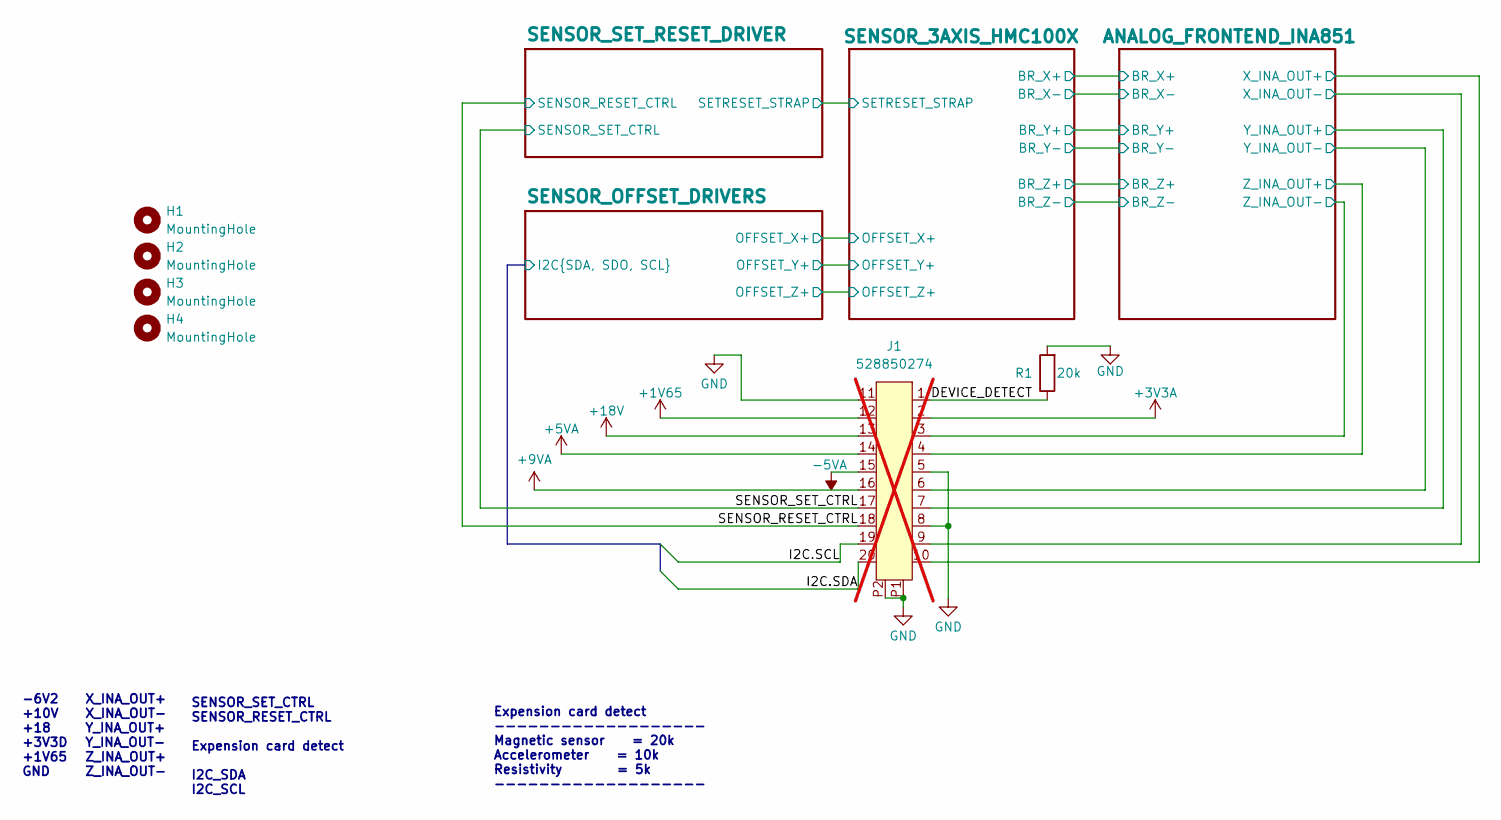
[picture p46: schematic Untitled.kicad_sch]

Parts:
H1, H2, H3, H4: MountingHole; MountingHole_4.3mm_M4
J1: 528850274; CON_528850274_MOL; not fitted
R1: 20k; R_0603_1608Metric; LCSC C4184

Connections:
+1V65: J1.12; also elsewhere on the board
+3V3A: J1.2; also elsewhere on the board
+5VA: J1.14; also elsewhere on the board
+9VA: J1.16; also elsewhere on the board
+18V: J1.13; also elsewhere on the board
-5VA: J1.15; also elsewhere on the board
/ANALOG_FRONTEND_INA851/X_INA_OUT+: J1.10; also elsewhere on the board
/ANALOG_FRONTEND_INA851/X_INA_OUT-: J1.9; also elsewhere on the board
/ANALOG_FRONTEND_INA851/Y_INA_OUT+: J1.7; also elsewhere on the board
/ANALOG_FRONTEND_INA851/Y_INA_OUT-: J1.6; also elsewhere on the board
/ANALOG_FRONTEND_INA851/Z_INA_OUT+: J1.4; also elsewhere on the board
/ANALOG_FRONTEND_INA851/Z_INA_OUT-: J1.3; also elsewhere on the board
/DEVICE_DETECT: J1.1, R1.1
/SENSOR_OFFSET_DRIVERS/I2C.SCL: J1.19; also elsewhere on the board
/SENSOR_OFFSET_DRIVERS/I2C.SDA: J1.20; also elsewhere on the board
/SENSOR_RESET_CTRL: J1.18; also elsewhere on the board
/SENSOR_SET_CTRL: J1.17; also elsewhere on the board
GND: J1.5, J1.8, J1.11, J1.P1, J1.P2, R1.2; also elsewhere on the board

Notes on the sheet:
SENSOR_SET_CTRL SENSOR_RESET_CTRL Expension card detect I2C_SDA I2C_SCL
Expension card detect ------------------- Magnetic sensor = 20k Accelerometer = 10k Resistivity = 5k -------------------
X_INA_OUT+ X_INA_OUT- Y_INA_OUT+ Y_INA_OUT- Z_INA_OUT+ Z_INA_OUT-
-6V2 +10V +18 +3V3D +1V65 GND

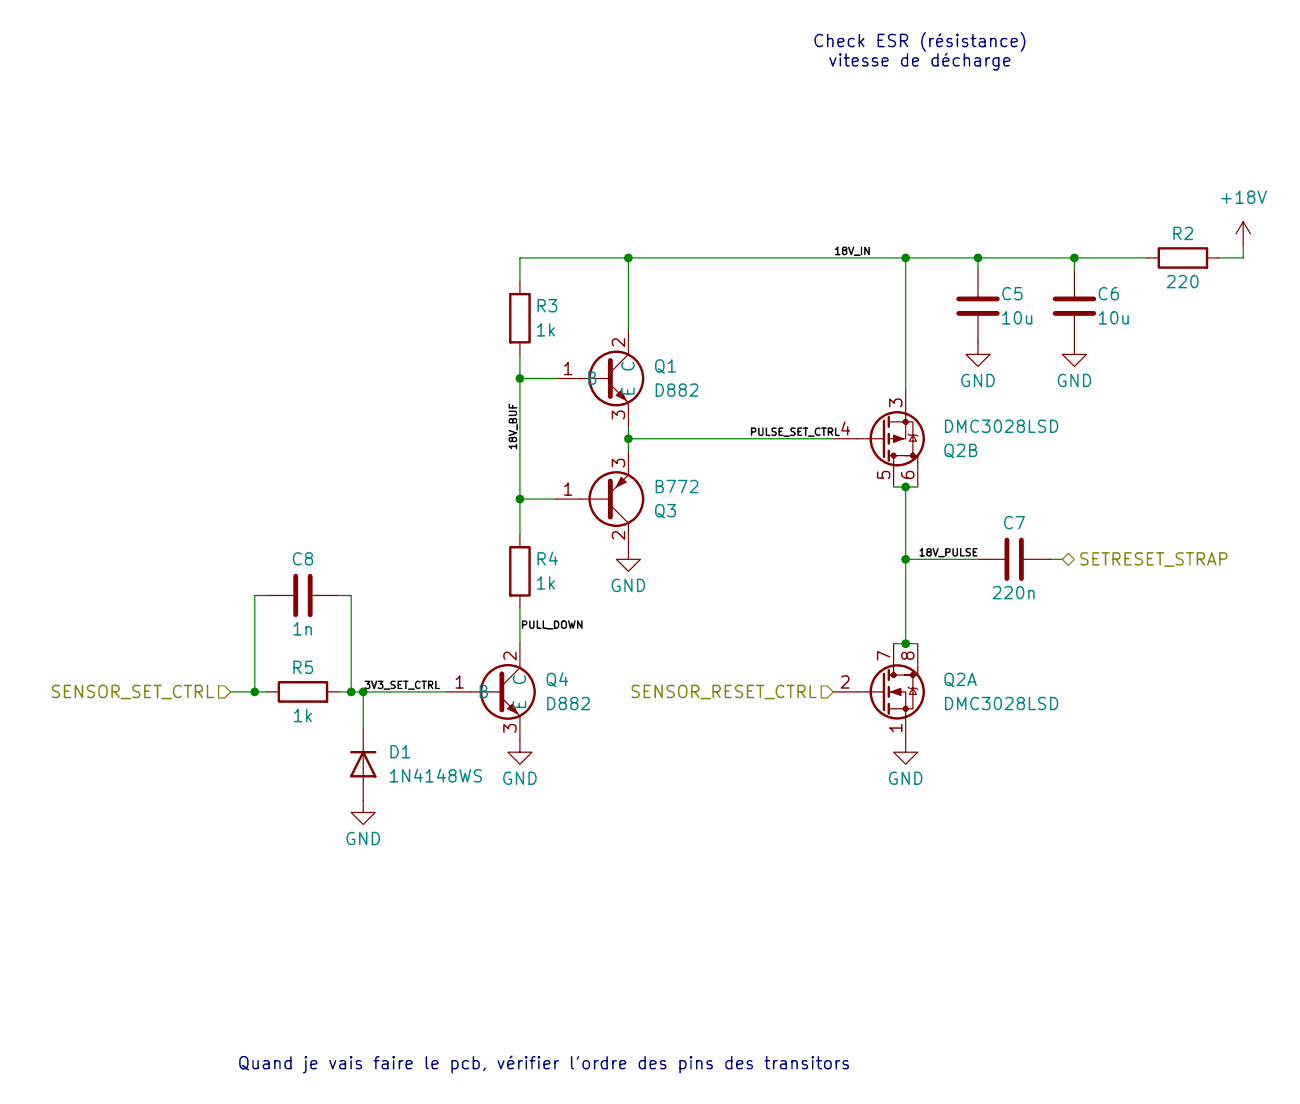
[picture p47: schematic sensor_set_reset_driver.kicad_sch]

Parts:
C5, C6: 10u; C_1206_3216Metric; LCSC C13585
C7: 220n; C_0805_2012Metric; LCSC C5378
C8: 1n; C_0603_1608Metric; LCSC C1588
D1: 1N4148WS; D_SOD-323; LCSC C2128
Q1, Q4: D882; SOT-89-3; LCSC C9634
Q2: DMC3028LSD; SO-8_3.9x4.9mm_P1.27mm; LCSC C460874
Q3: B772; SOT-89-3; LCSC C24278
R2: 220; R_2512_6332Metric; LCSC C4202072
R3, R4, R5: 1k; R_0603_1608Metric; LCSC C21190

Connections:
+18V: R2.2; also elsewhere on the board
/SENSOR_3AXIS_HMC100X/SETRESET_STRAP: C7.2; also elsewhere on the board
/SENSOR_RESET_CTRL: Q2.2 (G1); also elsewhere on the board
/SENSOR_SET_CTRL: C8.1, R5.1; also elsewhere on the board
/SENSOR_SET_RESET_DRIVER/3V3_SET_CTRL: C8.2, D1.1 (K), Q4.1 (B), R5.2
/SENSOR_SET_RESET_DRIVER/18V_BUF: Q1.1 (B), Q3.1, R3.2, R4.1
/SENSOR_SET_RESET_DRIVER/18V_IN: C5.1, C6.1, Q1.2 (C), Q2.3 (S2), R2.1, R3.1
/SENSOR_SET_RESET_DRIVER/18V_PULSE: C7.1, Q2.5 (D2), Q2.6 (D2), Q2.7 (D1), Q2.8 (D1)
/SENSOR_SET_RESET_DRIVER/PULL_DOWN: Q4.2 (C), R4.2
/SENSOR_SET_RESET_DRIVER/PULSE_SET_CTRL: Q1.3 (E), Q2.4 (G2), Q3.3
GND: C5.2, C6.2, D1.2 (A), Q2.1 (S1), Q3.2, Q4.3 (E); also elsewhere on the board

Notes on the sheet:
Check ESR (résistance) vitesse de décharge
Quand je vais faire le pcb, vérifier l'ordre des pins des transitors

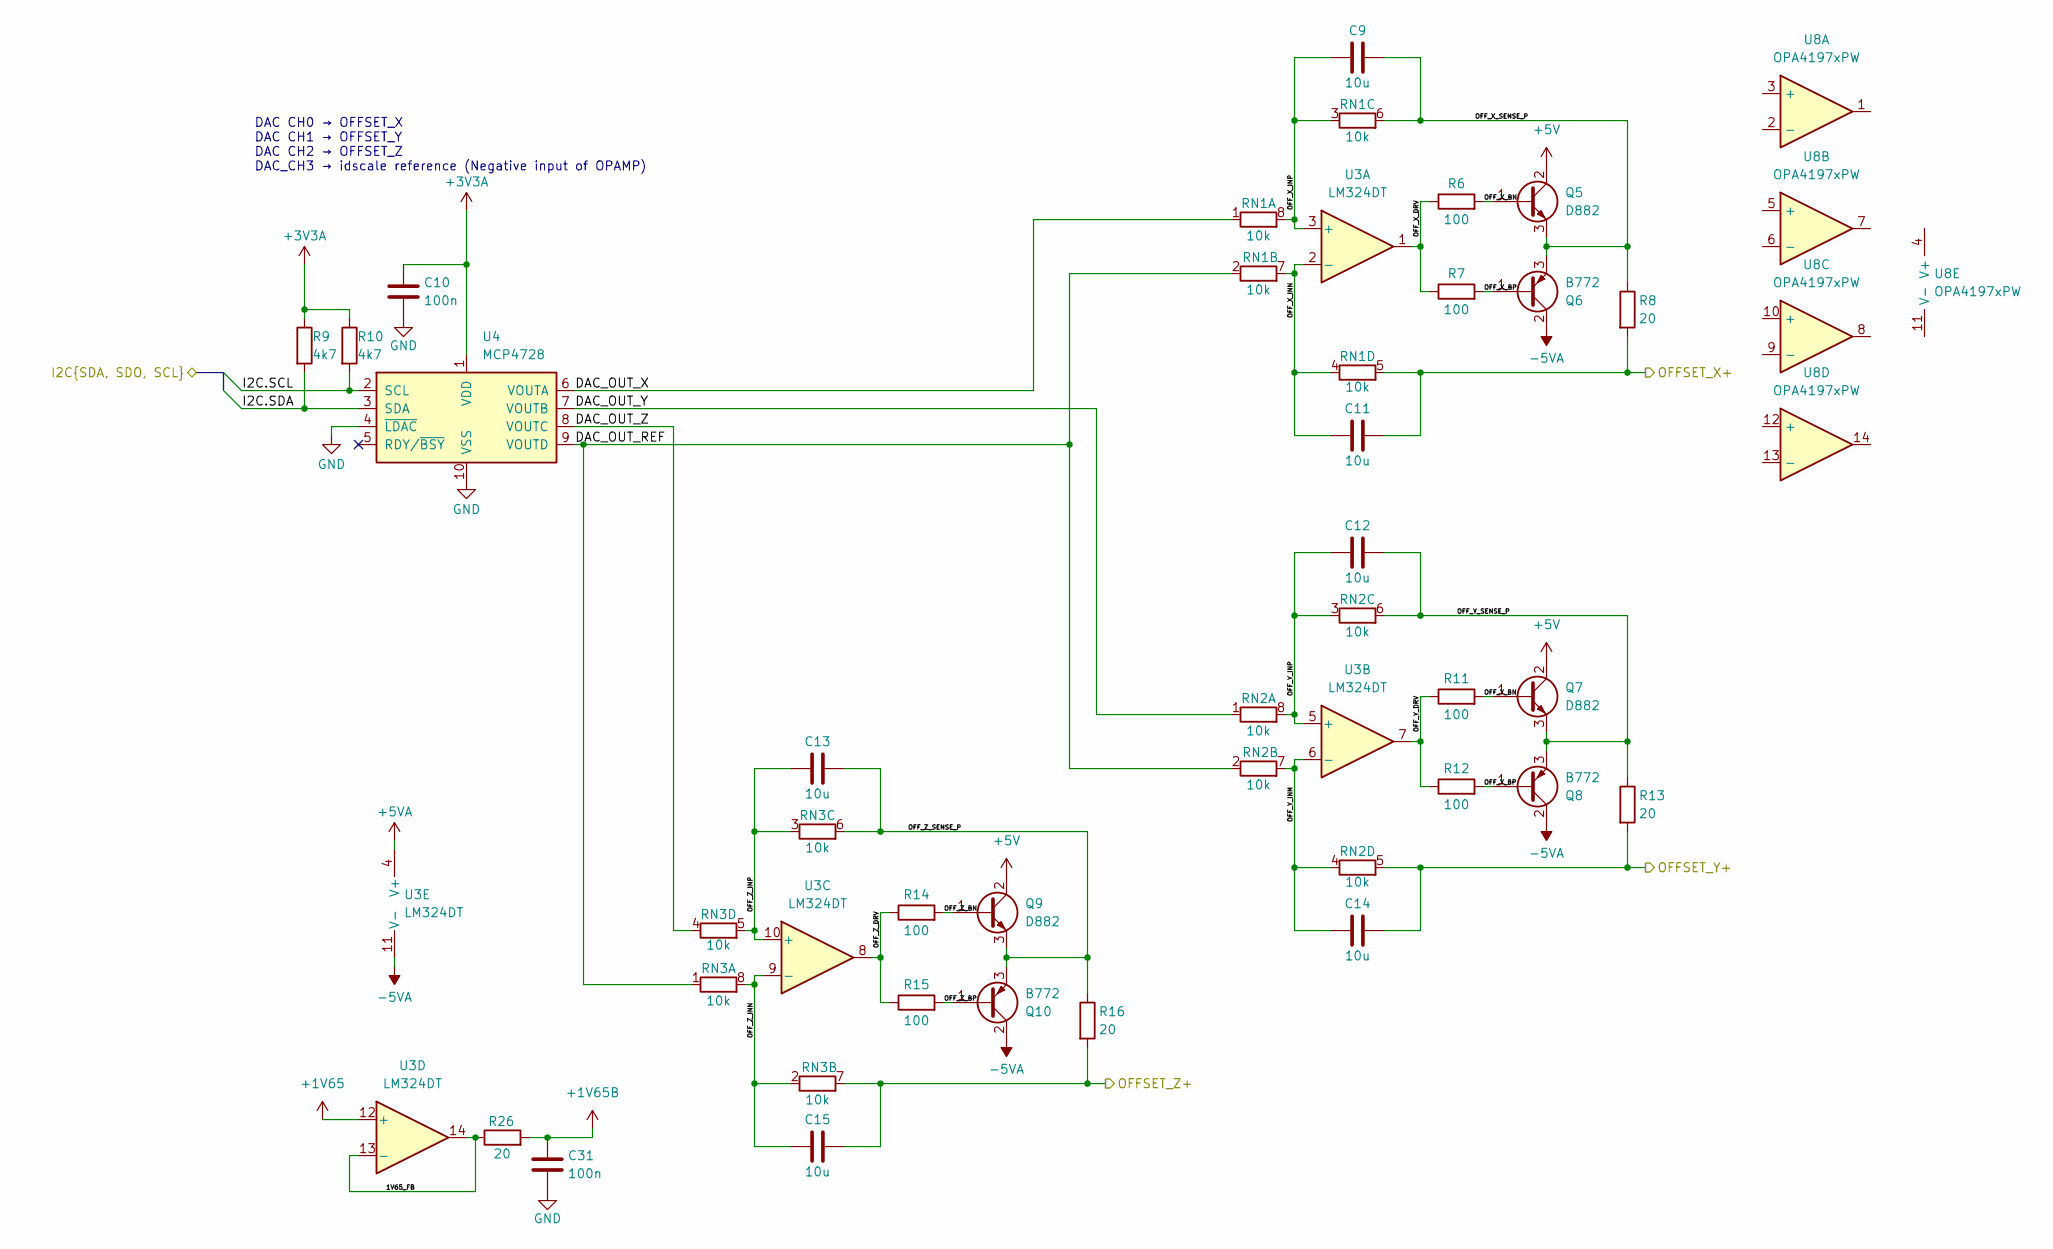
[picture p48: schematic sensor_offset_drivers.kicad_sch]

Parts:
C9, C11, C12, C13, C14, C15: 10u; C_0805_2012Metric; LCSC C15850
C10, C31: 100n; C_0603_1608Metric; LCSC C14663
Q5, Q7, Q9: D882; SOT-89-3; LCSC C9634
Q6, Q8, Q10: B772; SOT-89-3; LCSC C24278
R6, R7, R11, R12, R14, R15: 100; R_0603_1608Metric; LCSC C22775
R8, R13, R16, R26: 20; R_1206_3216Metric; LCSC C17955
R9, R10: 4k7; R_0603_1608Metric; LCSC C23162
RN1, RN2, RN3: 10k; R_Array_Convex_4x0612; LCSC C29718
U3: LM324DT; SOIC-14_3.9x8.7mm_P1.27mm; LCSC C71035
U4: MCP4728; MSOP-10_3x3mm_P0.5mm; LCSC C108207
U8: OPA4197xPW; TSSOP-14_4.4x5mm_P0.65mm

Connections:
+1V65: U3.12 (+); also elsewhere on the board
+1V65B: C31.1, R26.2; also elsewhere on the board
+3V3A: C10.1, R9.1, R10.1, U4.1 (VDD); also elsewhere on the board
+5V: Q5.2, Q7.2, Q9.2
+5VA: U3.4 (V+); also elsewhere on the board
-5VA: Q6.2, Q8.2, Q10.2, U3.11 (V-); also elsewhere on the board
/SENSOR_3AXIS_HMC100X/OFFSET_X+: C11.2, R8.2, RN1.5; also elsewhere on the board
/SENSOR_3AXIS_HMC100X/OFFSET_Y+: C14.2, R13.2, RN2.5; also elsewhere on the board
/SENSOR_3AXIS_HMC100X/OFFSET_Z+: C15.2, R16.2, RN3.7; also elsewhere on the board
/SENSOR_OFFSET_DRIVERS/1V65_FB: R26.1, U3.13 (-), U3.14
/SENSOR_OFFSET_DRIVERS/DAC_OUT_REF: RN1.2, RN2.2, RN3.1, U4.9 (VOUTD)
/SENSOR_OFFSET_DRIVERS/DAC_OUT_X: RN1.1, U4.6 (VOUTA)
/SENSOR_OFFSET_DRIVERS/DAC_OUT_Y: RN2.1, U4.7 (VOUTB)
/SENSOR_OFFSET_DRIVERS/DAC_OUT_Z: RN3.4, U4.8 (VOUTC)
/SENSOR_OFFSET_DRIVERS/I2C.SCL: R10.2, U4.2 (SCL); also elsewhere on the board
/SENSOR_OFFSET_DRIVERS/I2C.SDA: R9.2, U4.3 (SDA); also elsewhere on the board
/SENSOR_OFFSET_DRIVERS/OFF_X_BN: Q5.1, R6.2
/SENSOR_OFFSET_DRIVERS/OFF_X_BP: Q6.1, R7.2
/SENSOR_OFFSET_DRIVERS/OFF_X_DRV: R6.1, R7.1, U3.1
/SENSOR_OFFSET_DRIVERS/OFF_X_INN: C11.1, RN1.4, RN1.7, U3.2 (-)
/SENSOR_OFFSET_DRIVERS/OFF_X_INP: C9.1, RN1.3, RN1.8, U3.3 (+)
/SENSOR_OFFSET_DRIVERS/OFF_X_SENSE_P: C9.2, Q5.3, Q6.3, R8.1, RN1.6
/SENSOR_OFFSET_DRIVERS/OFF_Y_BN: Q7.1, R11.2
/SENSOR_OFFSET_DRIVERS/OFF_Y_BP: Q8.1, R12.2
/SENSOR_OFFSET_DRIVERS/OFF_Y_DRV: R11.1, R12.1, U3.7
/SENSOR_OFFSET_DRIVERS/OFF_Y_INN: C14.1, RN2.4, RN2.7, U3.6 (-)
/SENSOR_OFFSET_DRIVERS/OFF_Y_INP: C12.1, RN2.3, RN2.8, U3.5 (+)
/SENSOR_OFFSET_DRIVERS/OFF_Y_SENSE_P: C12.2, Q7.3, Q8.3, R13.1, RN2.6
/SENSOR_OFFSET_DRIVERS/OFF_Z_BN: Q9.1, R14.2
/SENSOR_OFFSET_DRIVERS/OFF_Z_BP: Q10.1, R15.2
/SENSOR_OFFSET_DRIVERS/OFF_Z_DRV: R14.1, R15.1, U3.8
/SENSOR_OFFSET_DRIVERS/OFF_Z_INN: C15.1, RN3.2, RN3.8, U3.9 (-)
/SENSOR_OFFSET_DRIVERS/OFF_Z_INP: C13.1, RN3.3, RN3.5, U3.10 (+)
/SENSOR_OFFSET_DRIVERS/OFF_Z_SENSE_P: C13.2, Q9.3, Q10.3, R16.1, RN3.6
GND: C10.2, C31.2, U4.4 (~LDAC), U4.10 (VSS); also elsewhere on the board

Notes on the sheet:
DAC CH0 → OFFSET_X DAC CH1 → OFFSET_Y DAC CH2 → OFFSET_Z DAC_CH3 → idscale reference (Negative input of OPAMP)

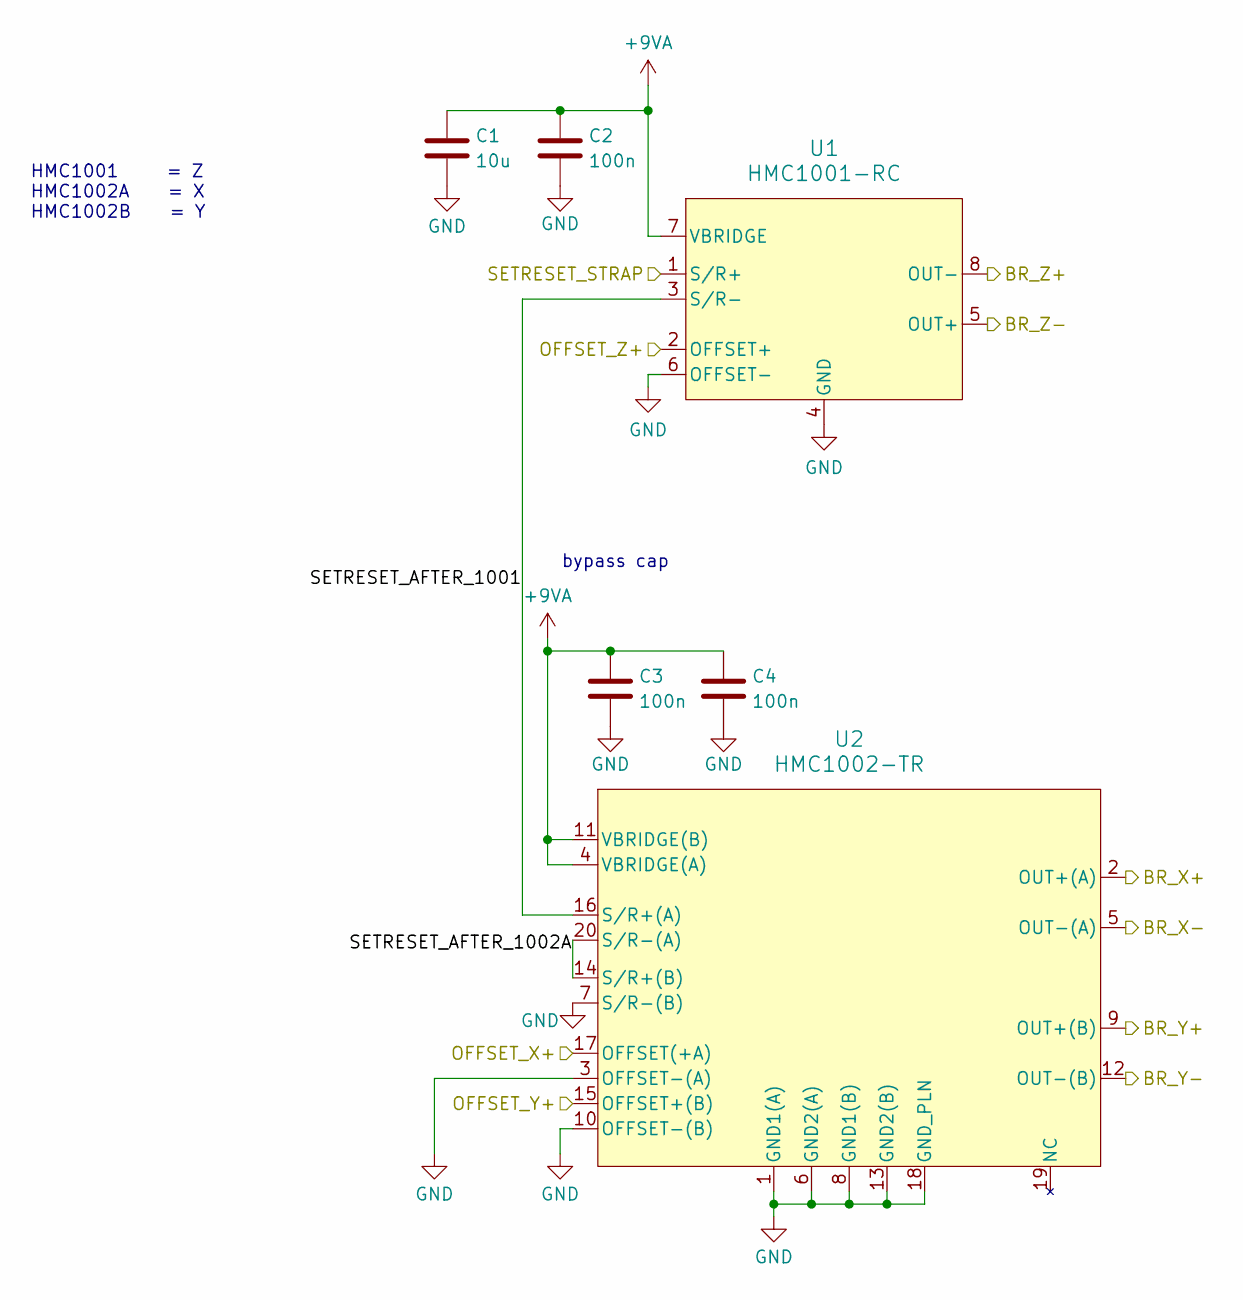
[picture p49: schematic sensor_hmc100x_3axis.kicad_sch]

Parts:
C1: 10u; C_0805_2012Metric; LCSC C15850
C2, C3, C4: 100n; C_0603_1608Metric; LCSC C14663
U1: HMC1001-RC; SIP8_HMC1001_HNW
U2: HMC1002-TR; SOIC20_HNW

Connections:
+9VA: C1.1, C2.1, C3.1, C4.1, U1.7 (VBRIDGE), U2.4 (VBRIDGE(A)), U2.11 (VBRIDGE(B)); also elsewhere on the board
/ANALOG_FRONTEND_INA851/BR_X+: U2.2 (OUT+(A)); also elsewhere on the board
/ANALOG_FRONTEND_INA851/BR_X-: U2.5 (OUT-(A)); also elsewhere on the board
/ANALOG_FRONTEND_INA851/BR_Y+: U2.9 (OUT+(B)); also elsewhere on the board
/ANALOG_FRONTEND_INA851/BR_Y-: U2.12 (OUT-(B)); also elsewhere on the board
/ANALOG_FRONTEND_INA851/BR_Z+: U1.8 (OUT-); also elsewhere on the board
/ANALOG_FRONTEND_INA851/BR_Z-: U1.5 (OUT+); also elsewhere on the board
/SENSOR_3AXIS_HMC100X/OFFSET_X+: U2.17 (OFFSET(+A)); also elsewhere on the board
/SENSOR_3AXIS_HMC100X/OFFSET_Y+: U2.15 (OFFSET+(B)); also elsewhere on the board
/SENSOR_3AXIS_HMC100X/OFFSET_Z+: U1.2 (OFFSET+); also elsewhere on the board
/SENSOR_3AXIS_HMC100X/SETRESET_AFTER_1001: U1.3 (S/R-), U2.16 (S/R+(A))
/SENSOR_3AXIS_HMC100X/SETRESET_AFTER_1002A: U2.14 (S/R+(B)), U2.20 (S/R-(A))
/SENSOR_3AXIS_HMC100X/SETRESET_STRAP: U1.1 (S/R+); also elsewhere on the board
GND: C1.2, C2.2, C3.2, C4.2, U1.4 (GND), U1.6 (OFFSET-), U2.1 (GND1(A)), U2.3 (OFFSET-(A)), U2.6 (GND2(A)), U2.7 (S/R-(B)), U2.8 (GND1(B)), U2.10 (OFFSET-(B)), U2.13 (GND2(B)), U2.18 (GND_PLN); also elsewhere on the board

Notes on the sheet:
HMC1001 = Z HMC1002A = X HMC1002B = Y
bypass cap

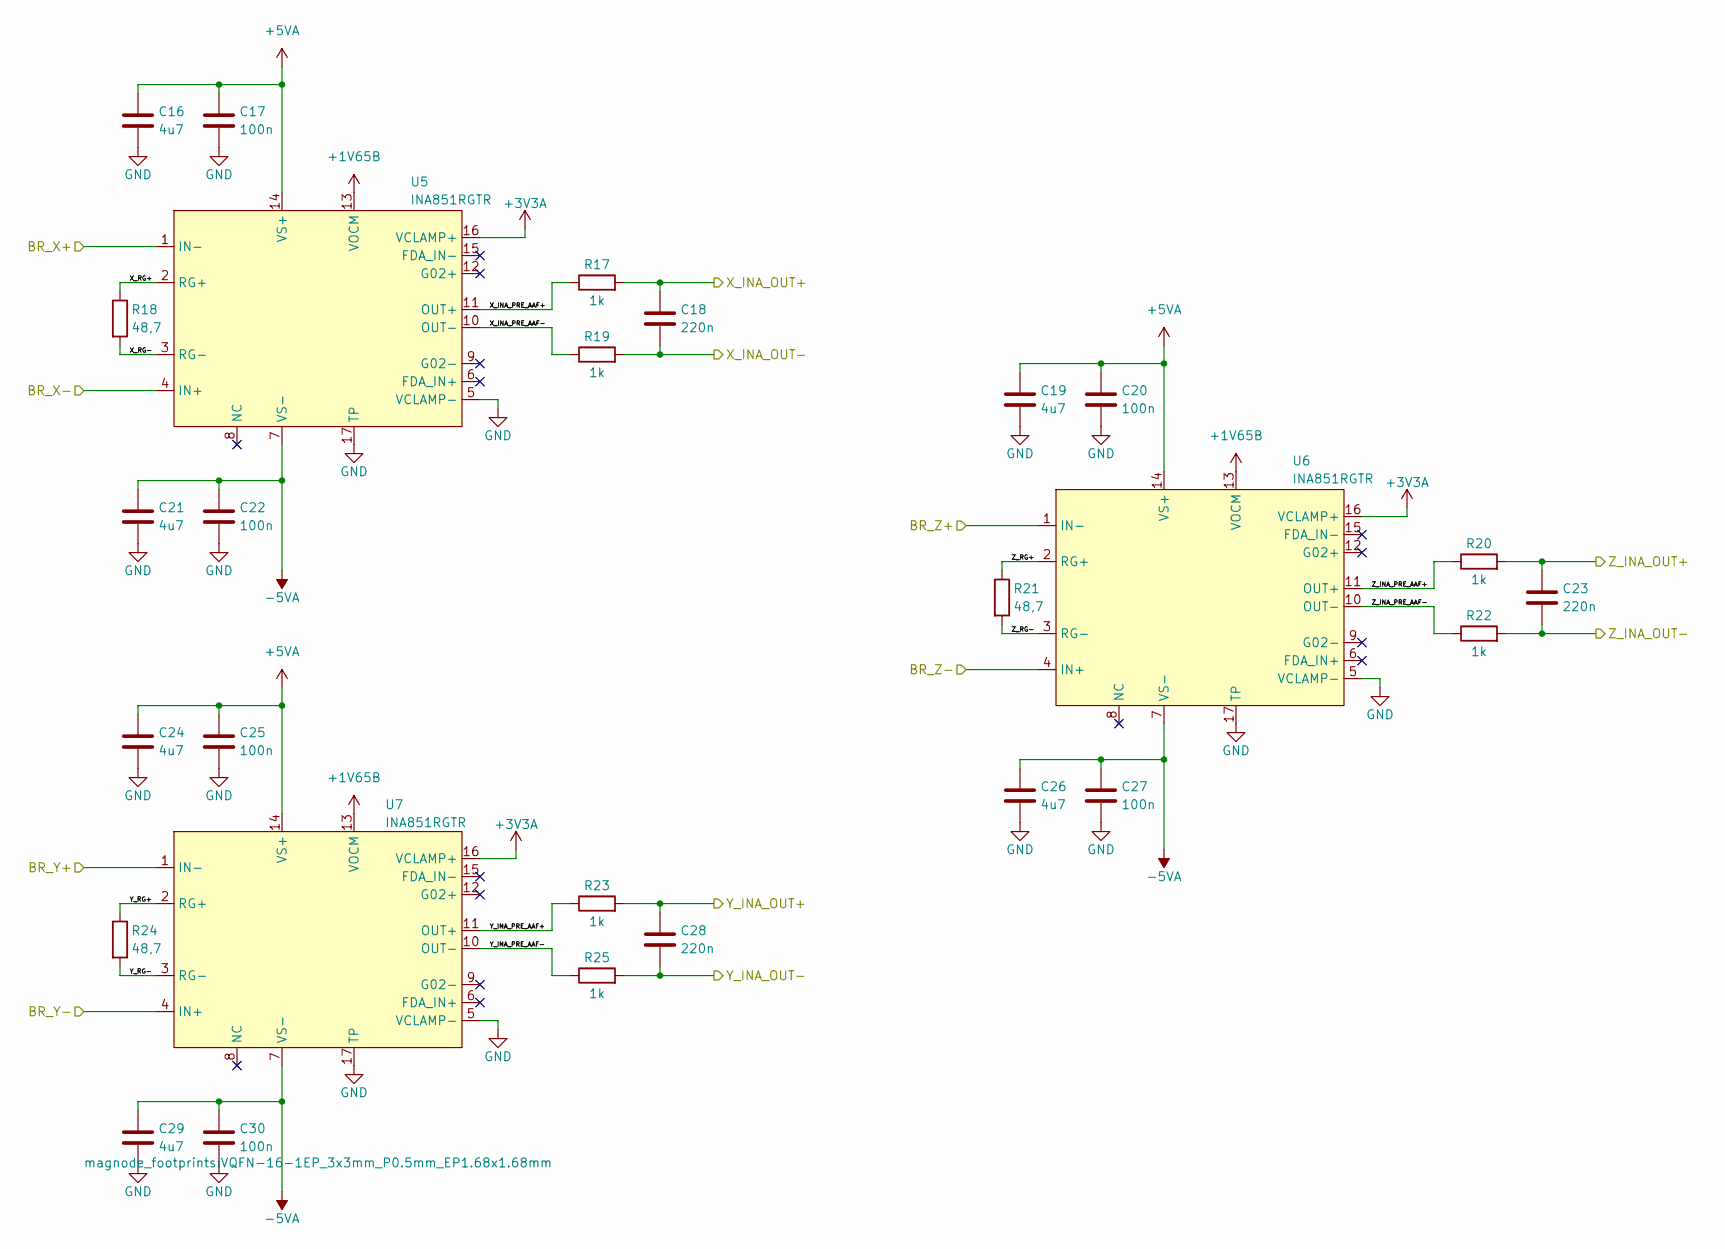
[picture p50: schematic analog_frontend_ina851.kicad_sch]

Parts:
C16, C19, C21, C24, C26, C29: 4u7; C_1206_3216Metric; LCSC C29823
C17, C20, C22, C25, C27, C30: 100n; C_0603_1608Metric; LCSC C14663
C18, C23, C28: 220n; C_0603_1608Metric; LCSC C21120
R17, R19, R20, R22, R23, R25: 1k; R_0603_1608Metric; LCSC C21190
R18, R21, R24: 48,7; R_0603_1608Metric; LCSC C2692820
U5, U6, U7: INA851RGTR; VQFN-16-1EP_3x3mm_P0.5mm_EP1.68x1.68mm; LCSC C5371575

Connections:
+1V65B: U5.13 (VOCM), U6.13 (VOCM), U7.13 (VOCM); also elsewhere on the board
+3V3A: U5.16 (VCLAMP+), U6.16 (VCLAMP+), U7.16 (VCLAMP+); also elsewhere on the board
+5VA: C16.1, C17.1, C19.1, C20.1, C24.1, C25.1, U5.14 (VS+), U6.14 (VS+), U7.14 (VS+); also elsewhere on the board
-5VA: C21.1, C22.1, C26.1, C27.1, C29.1, C30.1, U5.7 (VS-), U6.7 (VS-), U7.7 (VS-); also elsewhere on the board
/ANALOG_FRONTEND_INA851/BR_X+: U5.1 (IN-); also elsewhere on the board
/ANALOG_FRONTEND_INA851/BR_X-: U5.4 (IN+); also elsewhere on the board
/ANALOG_FRONTEND_INA851/BR_Y+: U7.1 (IN-); also elsewhere on the board
/ANALOG_FRONTEND_INA851/BR_Y-: U7.4 (IN+); also elsewhere on the board
/ANALOG_FRONTEND_INA851/BR_Z+: U6.1 (IN-); also elsewhere on the board
/ANALOG_FRONTEND_INA851/BR_Z-: U6.4 (IN+); also elsewhere on the board
/ANALOG_FRONTEND_INA851/X_INA_OUT+: C18.1, R17.2; also elsewhere on the board
/ANALOG_FRONTEND_INA851/X_INA_OUT-: C18.2, R19.2; also elsewhere on the board
/ANALOG_FRONTEND_INA851/X_INA_PRE_AAF+: R17.1, U5.11 (OUT+)
/ANALOG_FRONTEND_INA851/X_INA_PRE_AAF-: R19.1, U5.10 (OUT-)
/ANALOG_FRONTEND_INA851/X_RG+: R18.1, U5.2 (RG+)
/ANALOG_FRONTEND_INA851/X_RG-: R18.2, U5.3 (RG-)
/ANALOG_FRONTEND_INA851/Y_INA_OUT+: C28.1, R23.2; also elsewhere on the board
/ANALOG_FRONTEND_INA851/Y_INA_OUT-: C28.2, R25.2; also elsewhere on the board
/ANALOG_FRONTEND_INA851/Y_INA_PRE_AAF+: R23.1, U7.11 (OUT+)
/ANALOG_FRONTEND_INA851/Y_INA_PRE_AAF-: R25.1, U7.10 (OUT-)
/ANALOG_FRONTEND_INA851/Y_RG+: R24.1, U7.2 (RG+)
/ANALOG_FRONTEND_INA851/Y_RG-: R24.2, U7.3 (RG-)
/ANALOG_FRONTEND_INA851/Z_INA_OUT+: C23.1, R20.2; also elsewhere on the board
/ANALOG_FRONTEND_INA851/Z_INA_OUT-: C23.2, R22.2; also elsewhere on the board
/ANALOG_FRONTEND_INA851/Z_INA_PRE_AAF+: R20.1, U6.11 (OUT+)
/ANALOG_FRONTEND_INA851/Z_INA_PRE_AAF-: R22.1, U6.10 (OUT-)
/ANALOG_FRONTEND_INA851/Z_RG+: R21.1, U6.2 (RG+)
/ANALOG_FRONTEND_INA851/Z_RG-: R21.2, U6.3 (RG-)
GND: C16.2, C17.2, C19.2, C20.2, C21.2, C22.2, C24.2, C25.2, C26.2, C27.2, C29.2, C30.2, U5.5 (VCLAMP-), U5.17 (TP), U6.5 (VCLAMP-), U6.17 (TP), U7.5 (VCLAMP-), U7.17 (TP); also elsewhere on the board

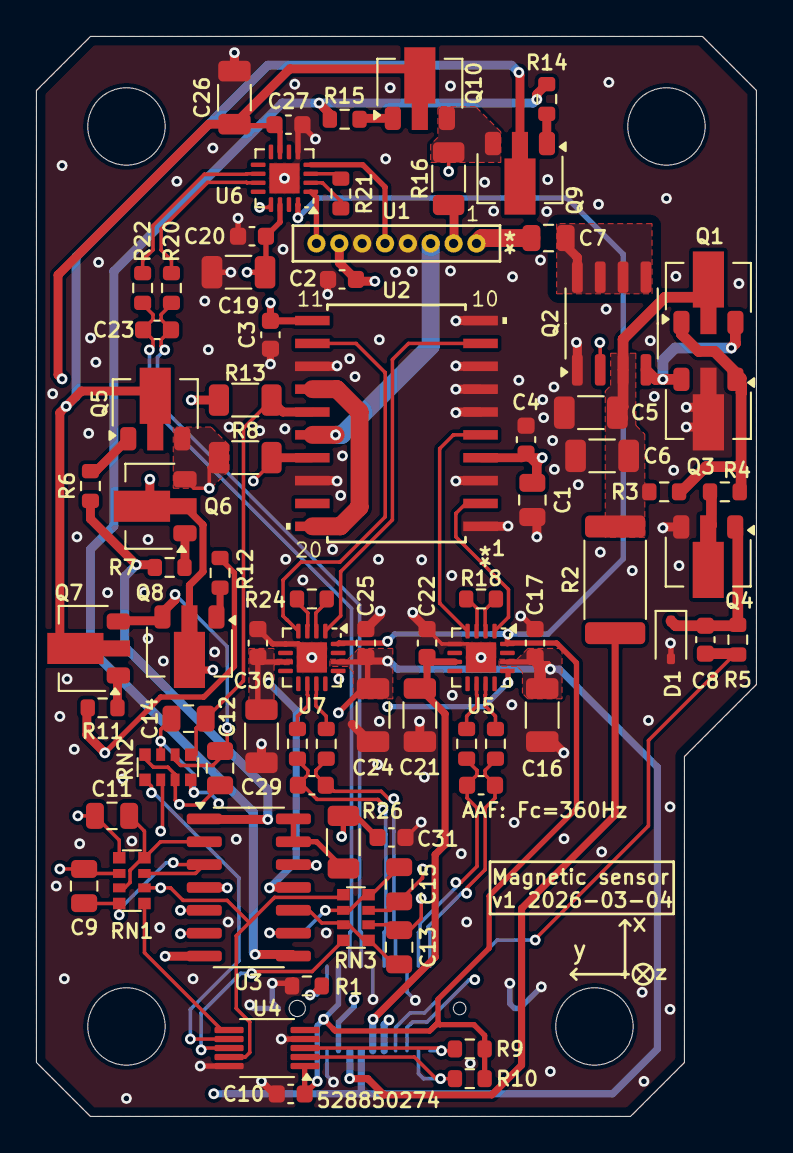
[picture p51: board hardware/pcb/Expension_card_design/Commande mars 2026/magnetic_board/… from above]

Board: 4 copper layers, 40.0 x 60.0 mm, 83 parts (1 on the bottom side), 73 nets.
