Benjamin-girard-1/magnetometer-node/hardware/pcb/magnetometer_node_mainboard/magnetometer_node_mainboard.kicad_pcb

## KiCad design hardware/pcb/magnetometer_node_mainboard/magnetometer_node_mainboard.kicad_pcb (2026-04-30)

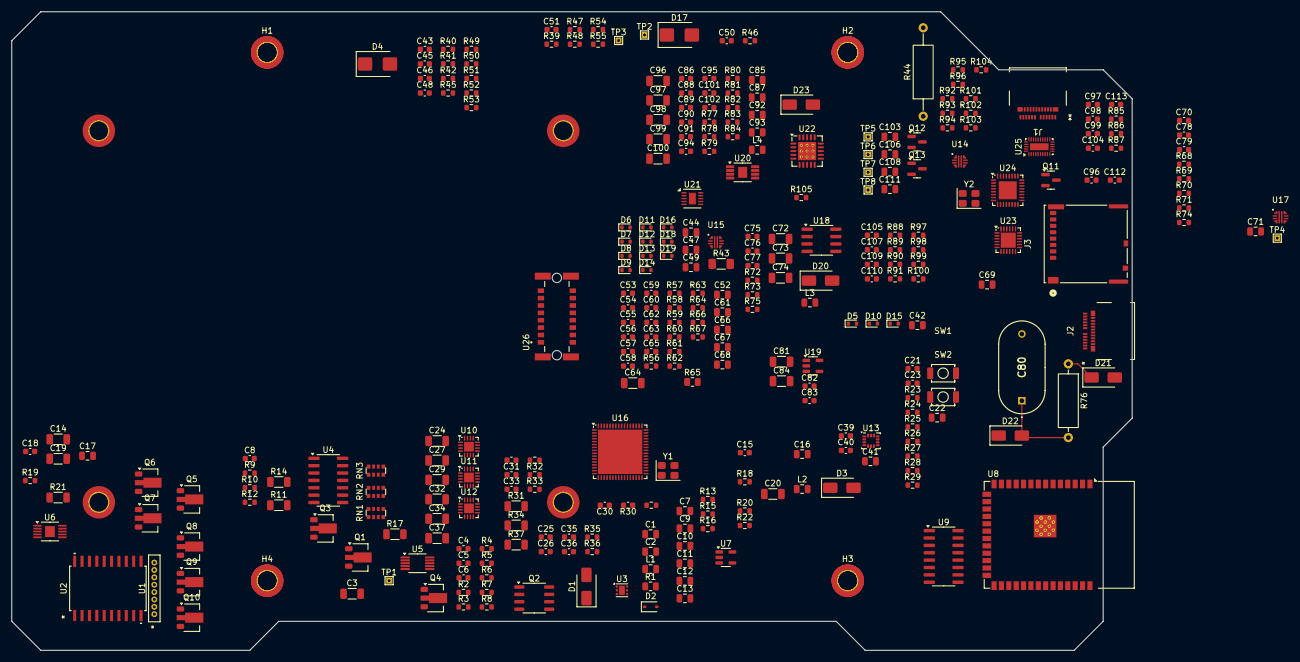
[picture p52: board magnetometer_node_mainboard.kicad_pcb from above]

Board: 2 copper layers, 193.0 x 110.0 mm, 318 parts (0 on the bottom side), 220 nets.

Parts:
C1, C2, C7, C9, C10, C11, C12, C13, C17, C22, C41, C44, C49, C52, C61, C71, C85, C87, C92, C93, C106: 10u; C_0805_2012Metric
C3, C14, C19, C20, C24, C27, C29, C32, C34, C37, C81, C84, C97#2, C98, C99#2, C100: 4u7; C_1206_3216Metric
C4, C26, C31, C36, C62, C90: 220n; C_0603_1608Metric
C5, C46, C51, C79: 1n; C_0603_1608Metric
C6, C45, C50, C77, C78, C86, C88, C95: 10n; C_0603_1608Metric
C8, C18, C21, C23, C25, C28, C30, C33, C35, C38, C39, C40, C43, C48, C53, C54, C55, C56, C57, C58, C59, C60, C63, C65, C70, C82, C83, C89, C94, C96, C97, C98#2, C99, C102, C104, C105, C107, C109, C110: 100n; C_0603_1608Metric
C15: 22p; C_0603_1608Metric
C16, C42, C47, C66, C67, C68, C69, C103, C108, C111: 1u; C_0805_2012Metric
C64, C74, C96#2: 47u; C_1206_3216Metric
C72, C73: 22u; C_1206_3216Metric
C75, C91: 10p; C_0603_1608Metric
C76, C101: 4n7; C_0603_1608Metric
C80: 470mF; C_Radial_D8.0mm_P11.50mm
C112, C113: 18p; C_0603_1608Metric
D1, D3, D20, D21, D22, D23: SS34; D_SMA
D2: 1N4148WS; D_SOD-323
D4, D17: P6SMB6.8CA; D_SMB
D5, D6, D7, D8, D9, D10, D11, D12, D13, D14, D15, D16, D18, D19: H5VUD5BB; D_SOD-523
H1, H2, H3, H4, H5, H5#2, H6, H6#2, H7, H7#2, H8, H8#2: MountingHole_Pad; MountingHole_3.2mm_M3_DIN965_Pad_TopBottom
J1, J2: USB_C_RECEPTACLE_MOLEX; CONN_201267-0005_MOL
J3: Micro_SD_CARD; CONN_503398-1892_MOL
L1, L2, L3, L4: 10u; C_0805_2012Metric
Q1, Q4, Q5, Q7, Q9: D882; SOT-89-3
Q2: DMC3028LSD; SO-8_3.9x4.9mm_P1.27mm
Q3, Q6, Q8, Q10: B772; SOT-89-3
Q11, Q13: AO3400A; SOT-23
Q12: AO3401A; SOT-23
R1: 220; R_0805_2012Metric
R2, R4, R8, R30, R32, R33, R35, R36, R38, R59, R62, R64, R67: 1k; R_0603_1608Metric
R3: 49k9; R_0603_1608Metric
R5, R22, R40, R47, R53, R57, R60, R61, R63, R66, R69, R79, R82, R84, R89, R97, R98, R99, R100, R101, R103, R104: 100k; R_0603_1608Metric
R6, R23, R24, R28, R29, R73, R90, R91, R92, R93, R94: 10k; R_0603_1608Metric
R7: 3k6; R_0603_1608Metric
R9, R10, R12, R13, R15, R16, R51, R52, R86, R88: 100; R_0603_1608Metric
R11, R14, R17: 20; R_1206_3216Metric
R18, R81: 510k; R_0603_1608Metric
R19, R45, R50, R74, R95, R96: 2k; R_0603_1608Metric
R20, R41, R48, R70: 200k; R_0603_1608Metric
R21: 90k9; R_1206_3216Metric
R25, R26, R27, R56: 22; R_0603_1608Metric
R31, R34, R37: 48,7; R_1206_3216Metric
R39, R46, R68: 470k; R_0603_1608Metric
R42, R49, R71, R77, R85: 39k; R_0603_1608Metric
R43: R_1206_3216Metric_Pad1.30x1.75mm_HandSolder
R44: R_Axial_DIN0309_L9.0mm_D3.2mm_P15.24mm_Horizontal
R54, R55: 5k1; R_0603_1608Metric
R58: 300k; R_0603_1608Metric
R65: 2k4; R_0805_2012Metric
R72: 75k; R_0603_1608Metric
R75: 24k; R_0603_1608Metric
R76: 47; R_Axial_DIN0309_L9.0mm_D3.2mm_P12.70mm_Horizontal
R78: 12k; R_0603_1608Metric
R80: 10; R_0603_1608Metric
R83, R87: 330k; R_0603_1608Metric
R102: 680; R_0603_1608Metric
R105: 900k; R_0603_1608Metric
RN1, RN2, RN3: 10k; R_Array_Convex_4x0612
SW1, SW2: TS-1088-AR02016
TP1, TP2, TP3, TP4: TestPoint; TestPoint_THTPad_1.0x1.0mm_Drill0.5mm
TP5: GL3224_SPI_CS; TestPoint_THTPad_1.0x1.0mm_Drill0.5mm
TP6: GL3224_SPI_CK; TestPoint_THTPad_1.0x1.0mm_Drill0.5mm
TP7: GL3224_SPI_MISO; TestPoint_THTPad_1.0x1.0mm_Drill0.5mm
TP8: GL3224_SPI_MOSI; TestPoint_THTPad_1.0x1.0mm_Drill0.5mm
U1: HMC1001-RC; SIP8_HMC1001_HNW
U2: HMC1002-TR; SOIC20_HNW
U3: TPS61170; WSON-6-1EP_2x2mm_P0.65mm_EP1x1.6mm
U4: LM324; SOIC-14_3.9x8.7mm_P1.27mm
U5: MCP4728; MSOP-10_3x3mm_P0.5mm
U6: LT3042xMSE; MSOP-10-1EP_3x3mm_P0.5mm_EP1.68x1.88mm
U7: TPS61040DBV; SOT-23-5
U8: ESP32-S3-WROOM-1
U9: 74HC595D,118; SOIC-16_3.9x9.9mm_P1.27mm
U10, U11, U12: INA851RGTR; VQFN-16-1EP_3x3mm_P0.5mm_EP1.68x1.68mm
U13: ISM330DHCXTR; LGA-14_3x2.5mm_P0.5mm_LayoutBorder3x4y
U14, U15, U17: TPS25210LRPWR; VQFN-HR-10
U16: AD7779; QFN-64-1EP_9x9mm_P0.5mm_EP7.65x7.65mm
U18: TPS54331DR; SOIC-8_3.9x4.9mm_P1.27mm
U19: TPS7A2033PDBVR; SOT-23-5
U20: TPS7A4901DGNR; HVSSOP-8-1EP_3x3mm_P0.65mm_EP1.57x1.89mm
U21: TPS63700DRCR; VSON-10-1EP_3x3mm_P0.5mm_EP1.2x2mm
U22: TPS7A3301RGWR; Texas_RGW0020A_VQFN-20-1EP_5x5mm_P0.65mm_EP3.15x3.15mm_Ther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
U23: TS3A27518ERTW; WQFN-24-1EP_4x4mm_P0.5mm_EP2.6x2.6mm
U24: GL3224-OIY04; QFN-32-1EP_5x5mm_P0.5mm_EP3.1x3.1mm
U25: HD3SS3220RNHR; Texas_RNH0030A_WQFN-30-1EP_2.5x4.5mm_P0.4mm_EP1.2x3.2mm
U26: 2x08_pheonix_connector_male; GPS_TILE_3D
Y1: OT2JI-111-8.192M; Crystal_SMD_3225-4Pin_3.2x2.5mm
Y2: X322525MOB4SI; Crystal_SMD_3225-4Pin_3.2x2.5mm

Connections:
+1V65: U10.13 (VOCM), U11.13 (VOCM), U12.13 (VOCM), U16.57 (VCM)
+3V3: C21.1, C22.1, C23.1, C39.1, C40.1, C41.1, C58.1, C60.1, C61.1, C74.1, C105.1, C106.1, C107.1, C108.2, C109.1, J3.4 (VDD), L3.2, R23.1, R24.1, R28.2, R29.2, R63.1, R66.1, R72.1, R90.1, R91.1, R92.1, R93.1, R94.1, R95.1, R99.1, R100.1, R101.1, U8.2 (3V3), U9.16 (VCC), U13.5 (VDDIO), U13.8 (VDD), U13.12 (CS), U14.3 (PG), U15.3 (PG), U16.24 (IOVDD), U16.54 (FORMAT1), U16.55 (FORMAT0), U17.3 (PG), U23.5 (VCC), U25.8 (VCC33), U26.A1, U26.A2, U26.A3, U26.A4, Y1.4 (VDD)
+3V3A: C52.1, C53.1, C54.1, C55.1, C56.1, C57.1, C83.1, C84.1, R62.1, U10.16 (VCLAMP+), U11.16 (VCLAMP+), U12.16 (VCLAMP+), U16.6 (AVDD1A), U16.43 (AVDD1B), U16.52 (AVDD2B), U16.58 (AVDD2A), U16.62 (AVDD4), U19.1 (OUT)
+3V3D: C8.1, U5.1 (VDD)
+5V: C2.1, C20.1, C44.1, C49.1, C69.1, C70.1, C92.1, C110.1, C111.2, D21.2 (A), L1.1, L2.1, Q5.2, Q7.2, Q9.2, Q12.2 (S), R40.1, R47.1, R51.1, R68.1, R80.2, R85.1, U3.6 (VIN), U4.4 (V+), U7.5 (VIN), U14.6 (OUT), U15.6 (OUT), U17.5 (IN), U21.5 (IN), U25.30 (VDD5)
+5VA: C24.1, C25.1, C27.1, C28.1, C32.1, C33.1, C86.1, C87.1, R77.1, U10.14 (VS+), U11.14 (VS+), U12.14 (VS+), U20.1 (OUT)
+9VA: C14.1, R58.1, U1.7 (VBRIDGE), U2.4 (VBRIDGE(A)), U2.11 (VBRIDGE(B)), U6.9 (OUTS), U6.10 (OUT)
+18V: C3.1, D1.1 (K), R1.2, R3.1
-5VA: C29.1, C30.1, C34.1, C35.1, C37.1, C38.1, C95.1, C96#2.1, Q6.2, Q8.2, Q10.2, R83.1, U4.11 (V-), U10.7 (VS-), U11.7 (VS-), U12.7 (VS-), U22.1 (OUT), U22.20 (OUT)
/ADC_AD777X/ADC_9VA_MON: C59.1, R58.2, R59.1, R60.1
/ADC_AD777X/ADC_9VA_MON_FLT: R59.2, U16.39 (AIN6+)
/ADC_AD777X/ADC_AREG1CAP: C67.1, U16.59 (AREG1CAP)
/ADC_AD777X/ADC_AREG2CAP: C68.1, U16.51 (AREG2CAP)
/ADC_AD777X/ADC_CONVST_SAR: R57.1, U8.11 (IO18), U16.17 (CONVST_SAR)
/ADC_AD777X/ADC_DRDY: U8.39 (IO1), U16.30 (~DRDY)
/ADC_AD777X/ADC_DREGCAP: C66.1, U16.23 (DREGCAP)
/ADC_AD777X/ADC_MCLK: U16.32 (XTAL2/MCLK), Y1.3 (OUT)
/ADC_AD777X/ADC_MCLK_EN: R66.2, U8.36 (RXD0), Y1.1 (Tri-State)
/ADC_AD777X/ADC_REF+: C63.1, C64.1, R67.1, U16.8 (REF1+), U16.41 (REF2+)
/ADC_AD777X/ADC_REF_OUT: C65.1, R67.2, U16.49 (REF_OUT)
/ADC_AD777X/ADC_RESET: R63.2, U8.10 (IO17), U16.36 (~RESET)
/ADC_AD777X/ADC_SDO: R56.1, U16.21 (DCLK0/SDO)
/ADC_AD777X/ADC_START: R61.1, U8.37 (TXD0), U16.33 (~START)
/ADC_AD777X/PT1000_AIN+: C62.1, R62.2, U16.37 (AIN7+)
/ADC_AD777X/PT1000_AIN-: C62.2, R64.2, U16.38 (AIN7-)
/ADC_AD777X/PT1000_DRAIN: R64.1, R65.1
/ADC_AD777X/SPI.CS: R25.1, U16.18 (ALERT/~CS)
/ADC_AD777X/SPI.SCLK: R26.1, U16.19 (DCLK2/SCLK)
/ADC_AD777X/SPI.SDI: R27.1, U16.20 (DCLK1/SDI)
/ADC_AD777X/SPI.SDO: R56.2, U8.7 (IO7)
/ADC_AD777X/X_INA_OUT+: C26.1, R30.2, U16.2 (AIN0+)
/ADC_AD777X/X_INA_OUT-: C26.2, R32.2, U16.1 (AIN0-)
/ADC_AD777X/Y_INA_OUT+: C36.1, R36.2, U16.4 (AIN1+)
/ADC_AD777X/Y_INA_OUT-: C36.2, R38.2, U16.3 (AIN1-)
/ADC_AD777X/Z_INA_OUT+: C31.1, R33.2, U16.10 (AIN2+)
/ADC_AD777X/Z_INA_OUT-: C31.2, R35.2, U16.9 (AIN2-)
/ANALOG_FRONTEND_INA851/BR_X+: U2.2 (OUT+(A)), U10.1 (IN-)
/ANALOG_FRONTEND_INA851/BR_X-: U2.5 (OUT-(A)), U10.4 (IN+)
/ANALOG_FRONTEND_INA851/BR_Y+: U2.9 (OUT+(B)), U12.4 (IN+)
/ANALOG_FRONTEND_INA851/BR_Y-: U2.12 (OUT-(B)), U12.1 (IN-)
/ANALOG_FRONTEND_INA851/BR_Z+: U1.8 (OUT-), U11.4 (IN+)
/ANALOG_FRONTEND_INA851/BR_Z-: U1.5 (OUT+), U11.1 (IN-)
/ANALOG_FRONTEND_INA851/X_INA_PRE_AAF+: R30.1, U10.11 (OUT+)
/ANALOG_FRONTEND_INA851/X_INA_PRE_AAF-: R32.1, U10.10 (OUT-)
/ANALOG_FRONTEND_INA851/X_RG+: R31.1, U10.2 (RG+)
/ANALOG_FRONTEND_INA851/X_RG-: R31.2, U10.3 (RG-)
/ANALOG_FRONTEND_INA851/Y_INA_PRE_AAF+: R36.1, U12.11 (OUT+)
/ANALOG_FRONTEND_INA851/Y_INA_PRE_AAF-: R38.1, U12.10 (OUT-)
/ANALOG_FRONTEND_INA851/Y_RG+: R37.1, U12.2 (RG+)
/ANALOG_FRONTEND_INA851/Y_RG-: R37.2, U12.3 (RG-)
/ANALOG_FRONTEND_INA851/Z_INA_PRE_AAF+: R33.1, U11.11 (OUT+)
/ANALOG_FRONTEND_INA851/Z_INA_PRE_AAF-: R35.1, U11.10 (OUT-)
/ANALOG_FRONTEND_INA851/Z_RG+: R34.1, U11.2 (RG+)
/ANALOG_FRONTEND_INA851/Z_RG-: R34.2, U11.3 (RG-)
/DATA_SAVING/+5VBUS_DATA: C42.1, C43.1, D4.2 (A2), J1.A4 (VBUS), J1.A9 (VBUS), J1.B4 (VBUS), J1.B9 (VBUS), R39.1, R43.2, R44.1, R105.1, U14.5 (IN)
/DATA_SAVING/+5VBUS_DET: R105.2, U25.5 (VBUS_DET)
/DATA_SAVING/CC1: D6.2, J1.A5 (CC1), U25.2 (CC1)
/DATA_SAVING/CC2: D5.2, J1.B5 (CC2), U25.1 (CC2)
/DATA_SAVING/CLK: U8.32 (IO39), U23.22 (NC2)
/DATA_SAVING/CMD: U8.31 (IO38), U23.23 (NC1)
/DATA_SAVING/D0: U8.33 (IO40), U23.20 (NC3)
/DATA_SAVING/D1: U8.34 (IO41), U23.18 (NC4)
/DATA_SAVING/D2: U8.35 (IO42), U23.16 (NC5)
/DATA_SAVING/D3: U8.26 (IO45), U23.19 (NC6)
/DATA_SAVING/D+: D16.2, D19.2, J1.A6 (D+), J1.B6 (D+), J2.A6 (D+), J2.B6 (D+), U8.14 (USB_D+), U24.32 (DP)
/DATA_SAVING/D-: D15.2, D18.2, J1.A7 (D-), J1.B7 (D-), J2.A7 (D-), J2.B7 (D-), U8.13 (USB_D-), U24.31 (DM)
/DATA_SAVING/EN_SD_MUX: R98.1, U9.5 (QF), U23.17 (~EN)
/DATA_SAVING/EN_USB_READ: R88.1, R97.1, U9.6 (QG), U23.11 (IN2), U23.21 (IN1)
/DATA_SAVING/RX1+: D9.2, J1.B11 (RX1+), U25.15 (RX1p)
/DATA_SAVING/RX1-: D10.2, J1.B10 (RX1-), U25.14 (RX1n)
/DATA_SAVING/RX2+: D7.2, J1.A11 (RX2+), U25.18 (RX2p)
/DATA_SAVING/RX2-: D8.2, J1.A10 (RX2-), U25.19 (RX2n)
/DATA_SAVING/TX1+: D14.2, J1.A2 (TX1+), U25.17 (TX1p)
/DATA_SAVING/TX1-: D13.2, J1.A3 (TX1-), U25.16 (TX1n)
/DATA_SAVING/TX2+: D12.2, J1.B2 (TX2+), U25.21 (TX2p)
/DATA_SAVING/TX2-: D11.2, J1.B3 (TX2-), U25.20 (TX2n)
/GPS_TILE/GPS_NRESET: U9.4 (QE), U26.B1
/GPS_TILE/GPS_TIMEPULSE: U8.8 (IO15), U26.B2
/GPS_TILE/GPS_UART.RX: U8.16 (IO46), U26.B4
/GPS_TILE/GPS_UART.TX: U8.24 (IO47), U26.B5
/IMU/I2C.SCL: U5.2 (SCL), U8.38 (IO2), U13.13 (SCL)
/IMU/I2C.SDA: U5.3 (SDA), U8.4 (IO4), U13.14 (SDA)
/IMU/I2C.SDO: U8.15 (IO3), U13.1 (SDO/SA0)
/IO_CONNECTOR/+5VBUS_DEBUG: C47.1, C48.1, D17.2 (A2), J2.A4 (VBUS), J2.A9 (VBUS), J2.B4 (VBUS), J2.B9 (VBUS), R46.1, U15.5 (IN)
/IO_CONNECTOR/EN_KEEPALIVE: R52.1, U8.25 (IO48)
/IO_CONNECTOR/EN_KEEPALIVE_DRAIN: Q11.3 (D), R51.2
/IO_CONNECTOR/EN_KEEPALIVE_GATE: Q11.1 (G), R52.2, R53.1
/MCU_ESP32S3/ADC_SPI_CS: R25.2, U8.5 (IO5)
/MCU_ESP32S3/ADC_SPI_SCLK: R26.2, U8.6 (IO6)
/MCU_ESP32S3/ADC_SPI_SDI: R27.2, U8.12 (IO8)
/MCU_ESP32S3/DAC_LDAC_N: U5.4 (~LDAC), U9.7 (QH)
/MCU_ESP32S3/EN_BST_10V: U7.4 (EN), U9.15 (QA)
/MCU_ESP32S3/EN_BST_18V: R5.1, U3.5 (CTRL), U9.3 (QD)
/MCU_ESP32S3/EN_INV_-5V: U9.2 (QC), U21.4 (EN)
/MCU_ESP32S3/EN_LDO_3V3: U9.1 (QB), U19.3 (EN)
/MCU_ESP32S3/ESP32_BOOTH: R24.2, SW2.2, U8.27 (IO0)
/MCU_ESP32S3/ESP32_EN: R23.2, SW1.2, U8.3 (EN)
/MCU_ESP32S3/SENSOR_RESET_CTRL: Q2.2 (G1), U8.17 (IO9)
/MCU_ESP32S3/SENSOR_SET_CTRL: C5.1, R8.1, U8.18 (IO10)
/PWR_3V3A/LDO_3V3_IN: C81.1, C82.1, U19.4 (IN)
/PWR_3V3D/3V3D_EFUSE_DVDT: C79.1, U17.7 (dV/dt)
/PWR_3V3D/3V3D_EFUSE_EN_ULVO: R68.2, R70.1, TP4.1, U17.1 (EN/ULVO)
/PWR_3V3D/3V3D_EFUSE_ILM: R74.1, U17.9 (ILM)
/PWR_3V3D/3V3D_EFUSE_ITIMER: C78.1, U17.10 (ITIMER)
/PWR_3V3D/3V3D_EFUSE_PGTH: R69.2, R71.1, U17.4 (PGTH)
/PWR_3V3D/5V_CAP_CHG: D21.1 (K), R76.1
/PWR_3V3D/5V_HOLDUP: C71.1, C73.1, D22.1 (K), R69.1, U17.6 (OUT), U18.2 (VIN), U18.3 (EN)
/PWR_3V3D/5V_SUPERCAP: C80.1, D22.2 (A), R76.2
/PWR_3V3D/STPD_3V3_BOOT: C72.1, U18.1 (BOOT)
/PWR_3V3D/STPD_3V3_COMP: C75.1, R73.1, U18.6 (COMP)
/PWR_3V3D/STPD_3V3_COMP_F: C76.1, R73.2
/PWR_3V3D/STPD_3V3_PH: C72.2, D20.1 (K), L3.1, U18.8 (PH)
/PWR_3V3D/STPD_3V3_SS: C77.1, U18.4 (SS)
/PWR_3V3D/STPD_3V3_VSENS: R72.2, R75.1, U18.5 (VSENSE)
/PWR_5VA_NEG5/+10V: C15.1, C16.1, C17.1, C18.1, C85.1, D3.1 (K), R18.1, U6.1 (IN), U6.2 (IN), U6.3 (EN/UV), U6.6 (PGFB), U20.5 (EN), U20.8 (IN)
/PWR_5VA_NEG5/INV_N5V5_COMP: C101.1, U21.1 (COMP)
/PWR_5VA_NEG5/INV_N5V5_FB: C91.1, R79.2, R81.1, U21.9 (FB)
/PWR_5VA_NEG5/INV_N5V5_FF: C91.2, R82.1
/PWR_5VA_NEG5/INV_N5V5_SW: D23.1 (K), L4.1, U21.6 (SW)
/PWR_5VA_NEG5/INV_N5V5_VIN: C89.1, R80.1, U21.3 (VIN)
/PWR_5VA_NEG5/INV_N5V5_VREF: C90.1, R79.1, U21.10 (VREF)
/PWR_5VA_NEG5/LDO_N5V_FB: C95.2, R83.2, R84.1, U22.3 (FB)
/PWR_5VA_NEG5/LDO_N5V_NR: C102.1, U22.14 (NR/SS)
/PWR_5VA_NEG5/LDO_P5V_FB: C86.2, R77.2, R78.1, U20.2 (FB)
/PWR_5VA_NEG5/LDO_P5V_NR: C88.1, U20.6 (NR/SS)
/PWR_5VA_NEG5/N5V5_PRE_N5VA: C93.1, C94.1, C97#2.1, C98.1, C99#2.1, C100.1, D23.2 (A), R81.2, R82.2, U21.8 (OUT), U22.13 (EN), U22.15 (IN), U22.16 (IN)
/PWR_9V_BRIDGE/BST_10V_FB: C15.2, R20.2, R22.1, U7.3 (FB)
/PWR_9V_BRIDGE/BST_10V_SW: D3.2 (A), L2.2, U7.1 (SW)
/PWR_9V_BRIDGE/LDO_9V_ILIM: R19.1, U6.5 (ILIM)
/PWR_9V_BRIDGE/LDO_9V_SET: C19.1, R21.1, U6.7 (SET)
/SENSOR_3AXIS_HMC100X/OFFSET_X+: C9.2, R11.2, RN1.5 (R4.2), U2.17 (OFFSET(+A))
/SENSOR_3AXIS_HMC100X/OFFSET_Y+: C12.2, R14.2, RN2.5 (R4.2), U2.15 (OFFSET+(B))
/SENSOR_3AXIS_HMC100X/OFFSET_Z+: C13.2, R17.2, RN3.5 (R4.2), U1.2 (OFFSET+)
/SENSOR_3AXIS_HMC100X/SETRESET_AFTER_1001: U1.3 (S/R-), U2.16 (S/R+(A))
/SENSOR_3AXIS_HMC100X/SETRESET_AFTER_1002A: U2.14 (S/R+(B)), U2.20 (S/R-(A))
/SENSOR_3AXIS_HMC100X/SETRESET_STRAP: C4.2, U1.1 (S/R+)
/SENSOR_OFFSET_DRIVERS/DAC_OUT_REF: RN1.1 (R1), RN2.1 (R1), RN3.1 (R1), U5.9 (VOUTD)
/SENSOR_OFFSET_DRIVERS/DAC_RDY_N: TP1.1, U5.5 (RDY/~BSY)
/SENSOR_OFFSET_DRIVERS/OFF_X_BN: Q5.1, R9.2
/SENSOR_OFFSET_DRIVERS/OFF_X_BP: Q6.1, R10.2
/SENSOR_OFFSET_DRIVERS/OFF_X_DRV: R9.1, R10.1, U4.1
/SENSOR_OFFSET_DRIVERS/OFF_X_INN: C9.1, RN1.3 (R2.2), U4.2 (-)
/SENSOR_OFFSET_DRIVERS/OFF_X_INP: C7.1, RN1.2 (R1.2), U4.3 (+)
/SENSOR_OFFSET_DRIVERS/OFF_X_SENSE_P: C7.2, Q5.3, Q6.3, R11.1, RN1.4 (R3.2)
/SENSOR_OFFSET_DRIVERS/OFF_Y_BN: Q7.1, R12.2
/SENSOR_OFFSET_DRIVERS/OFF_Y_BP: Q8.1, R13.2
/SENSOR_OFFSET_DRIVERS/OFF_Y_DRV: R12.1, R13.1, U4.7
/SENSOR_OFFSET_DRIVERS/OFF_Y_INN: C12.1, RN2.3 (R2.2), U4.6 (-)
/SENSOR_OFFSET_DRIVERS/OFF_Y_INP: C10.1, RN2.2 (R1.2), U4.5 (+)
/SENSOR_OFFSET_DRIVERS/OFF_Y_SENSE_P: C10.2, Q7.3, Q8.3, R14.1, RN2.4 (R3.2)
/SENSOR_OFFSET_DRIVERS/OFF_Z_BN: Q9.1, R15.2
/SENSOR_OFFSET_DRIVERS/OFF_Z_BP: Q10.1, R16.2
/SENSOR_OFFSET_DRIVERS/OFF_Z_DRV: R15.1, R16.1, U4.8
/SENSOR_OFFSET_DRIVERS/OFF_Z_INN: C13.1, RN3.3 (R2.2), U4.9 (-)
/SENSOR_OFFSET_DRIVERS/OFF_Z_INP: C11.1, RN3.2 (R1.2), U4.10 (+)
/SENSOR_OFFSET_DRIVERS/OFF_Z_SENSE_P: C11.2, Q9.3, Q10.3, R17.1, RN3.4 (R3.2)
/SENSOR_OFFSET_DRIVERS/UNUSED_LM324_CHD: U4.13 (-), U4.14
GND: C1.2, C2.2, C3.2, C6.2, C8.2, C14.2, C16.2, C17.2, C18.2, C19.2, C20.2, C21.2, C22.2, C23.2, C24.2, C25.2, C27.2, C28.2, C29.2, C30.2, C32.2, C33.2, C34.2, C35.2, C37.2, C38.2, C39.2, C40.2, C41.2, C42.2, C43.2, C44.2, C45.2, C46.2, C47.2, C48.2, C49.2, C50.2, C51.2, C52.2, C53.2, C54.2, C55.2, C56.2, C57.2, C58.2, C59.2, C60.2, C61.2, C63.2, C64.2, C65.2, C66.2, C67.2, C68.2, C69.2, C70.2, C71.2, C73.2, C74.2, C75.2, C76.2, C77.2, C78.2, C79.2, C80.2, C81.2, C82.2, C83.2, C84.2, C85.2, C87.2, C88.2, C89.2, C90.2, C92.2, C93.2, C94.2, C96.2, C96#2.2, C97.2, C97#2.2, C98.2, C98#2.2, C99.2, C99#2.2, C100.2, C101.2, C102.2, C103.1, C104.2, C105.2, C106.2, C107.2, C108.1, C109.2, C110.2, C111.1, C112.2, C113.2, D2.2 (A), D4.1 (A1), D5.1, D6.1, D7.1, D8.1, D9.1, D10.1, D11.1, D12.1, D13.1, D14.1, D15.1, D16.1, D17.1 (A1), D18.1, D19.1, D20.2 (A), H1.1, H2.1, H3.1, H4.1, H5#2.1, H6#2.1, H7#2.1, H8.1, J1.A1 (GND), J1.A12 (GND), J1.B1 (GND), J1.B12 (GND), J3.6 (VSS), J3.10 (SHIELD), J3.11 (VSS), J3.12 (VSS), J3.13 (VSS), J3.14 (VSS), L4.2, Q2.1 (S1), Q3.2, Q4.3 (E), Q11.2 (S), Q13.3 (D), R5.2, R7.2, R19.2, R21.2, R22.2, R41.2, R42.2, R43.1, R44.2, R45.2, R48.2, R49.2, R50.2, R53.2, R54.2, R55.2, R57.2, R60.2, R61.2, R65.2, R70.2, R71.2, R74.2, R75.2, R78.2, R84.2, R87.1, R89.2, R97.2, R98.2, R102.1, R103.2, R104.2, SW1.1, SW2.1, U1.4 (GND), U1.6 (OFFSET-), U2.1 (GND1(A)), U2.3 (OFFSET-(A)), U2.6 (GND2(A)), U2.7 (S/R-(B)), U2.8 (GND1(B)), U2.10 (OFFSET-(B)), U2.13 (GND2(B)), U2.18 (GND_PLN), U3.3 (GND), U3.7 (TP), U4.12 (+), U5.10 (VSS), U7.2 (GND), U8.1 (GND), U8.40 (GND), U8.41 (GND), U9.8 (GND), U10.5 (VCLAMP-), U10.17 (TP), U11.5 (VCLAMP-), U11.17 (TP), U12.5 (VCLAMP-), U12.17 (TP), U13.2 (SDx), U13.3 (SCx), U13.6 (GND), U13.7 (GND), U14.8 (GND), U15.8 (GND), U16.5 (AVSS1A), U16.7 (REF1-), U16.22 (DGND), U16.31 (XTAL1), U16.40 (AIN6-), U16.42 (REF2-), U16.44 (AVSS1B), U16.50 (AVSS2B), U16.53 (AVSS3), U16.56 (CLK_SEL), U16.60 (AVSS2A), U16.61 (AVSS4), U16.65 (EPAD(AVSSx)), U17.8 (GND), U18.7 (GND), U19.2 (GND), U19.5 (Pad), U20.3 (NC), U20.4 (GND), U20.9 (PwPd), U21.2 (GND), U21.7 (PSGND), U21.11 (PowerPAD), U22.7 (GND), U22.21 (EP), U23.2 (GND), U23.25 (GND), U24.27 (GND), U24.33 (GND), U25.4 (PORT), U25.12 (ENn_MUX), U25.13 (GND), U25.28 (GND), U25.29 (ENn_CC), U25.31 (GND), U26.A5, U26.A6, U26.A7, U26.A8, U26.B6, U26.B7, U26.B8, U26.MP1, U26.MP2, U26.MP3, U26.MP4, Y1.2 (GND), Y2.2, Y2.4
unnamed: C4.1, Q2.5 (D2), Q2.6 (D2), Q2.7 (D1), Q2.8 (D1)
unnamed: C6.1, R6.2
unnamed: C96.1, C97.1, C98#2.1, C99.1
unnamed: D1.2 (A), L1.2, U3.4 (SW)
unnamed: C5.2, D2.1 (K), Q4.1 (B), R8.2
unnamed: R96.1, U24.14 (LED)
unnamed: J2.A5 (CC1), R55.1
unnamed: J2.B5 (CC2), R54.1
unnamed: J2.A1 (GND), J2.A12 (GND), J2.B1 (GND), J2.B12 (GND)
unnamed: J3.5 (CLK), U23.3 (COM2)
unnamed: J3.3 (CMD), R94.2, U23.1 (COM1)
unnamed: J3.7 (DAT0), R93.2, U23.4 (COM3)
unnamed: J3.8 (DAT1), R92.2, U23.6 (COM4)
unnamed: J3.1 (DAT2), R91.2, U23.7 (COM5)
unnamed: J3.2 (DAT3), R90.2, U23.9 (COM6)
unnamed: Q1.1 (B), Q3.1, R2.2, R4.1
unnamed: C1.1, Q1.2 (C), Q2.3 (S2), R1.1, R2.1
unnamed: Q1.3 (E), Q2.4 (G2), Q3.3
unnamed: Q4.2 (C), R4.2
unnamed: C103.2, C104.1, Q12.3 (D), R87.2, U24.15 (VBUS)
unnamed: Q12.1 (G), R86.2
unnamed: Q13.1 (G), R88.2, R89.1
unnamed: Q13.2 (S), R85.2, R86.1
unnamed: R18.2, R20.1
unnamed: R6.1, U3.2 (COMP)
unnamed: R3.2, R7.1, U3.1 (FB)
unnamed: U6.8 (GND), U6.11 (GND)
unnamed: U8.19 (IO11), U9.14 (SER)
unnamed: U8.21 (IO13), U9.11 (SRCLK)
unnamed: U8.22 (IO14), U9.10 (~SRCLR)
unnamed: R29.1, U8.9 (IO16), U9.12 (RCLK)
unnamed: R28.1, U9.13 (~OE)
unnamed: R39.2, R41.1, TP2.1, U14.1 (EN/ULVO)
unnamed: R45.1, U14.9 (ILM)
unnamed: C45.1, U14.10 (ITIMER)
unnamed: R40.2, R42.1, U14.4 (PGTH)
unnamed: C46.1, U14.7 (dV/dt)
unnamed: R46.2, R48.1, TP3.1, U15.1 (EN/ULVO)
unnamed: R50.1, U15.9 (ILM)
unnamed: C50.1, U15.10 (ITIMER)
unnamed: R47.2, R49.1, U15.4 (PGTH)
unnamed: C51.1, U15.7 (dV/dt)
unnamed: U16.34 (~SYNC_OUT), U16.35 (~SYNC_IN)
unnamed: U23.8 (NO1), U24.21 (SD_CM)
unnamed: U23.10 (NO2), U24.20 (SD_CK)
unnamed: U23.12 (NO3), U24.19 (SD_D0)
unnamed: U23.14 (NO4), U24.18 (SD_D1)
unnamed: U23.15 (NO5), U24.23 (SD_D2)
unnamed: U23.13 (NO6), U24.22 (SD_D3)
unnamed: R102.2, U24.9 (RTERM)
unnamed: U24.4 (RXN), U25.10 (RXn)
unnamed: U24.5 (RXP), U25.9 (RXp)
unnamed: R100.2, R103.1, U24.29 (SD_CDZ)
unnamed: R101.2, R104.1, U24.28 (SD_WP)
unnamed: TP6.1, U24.12 (SPI_CK)
unnamed: R99.2, TP5.1, U24.13 (SPI_CS)
unnamed: TP7.1, U24.10 (SPI_MISO)
unnamed: TP8.1, U24.11 (SPI_MOSI)
unnamed: U24.1 (TXN), U25.7 (TXn)
unnamed: U24.2 (TXP), U25.6 (TXp)
unnamed: C112.1, U24.6 (X1), Y2.1
unnamed: C113.1, U24.7 (X2), Y2.3
