Benjamin-girard-1/magnetometer-node/hardware/pcb/Digital_test_board/Digital_test_board.kicad_pcb

## KiCad design hardware/pcb/Digital_test_board/Digital_test_board.kicad_pcb (2026-04-30)

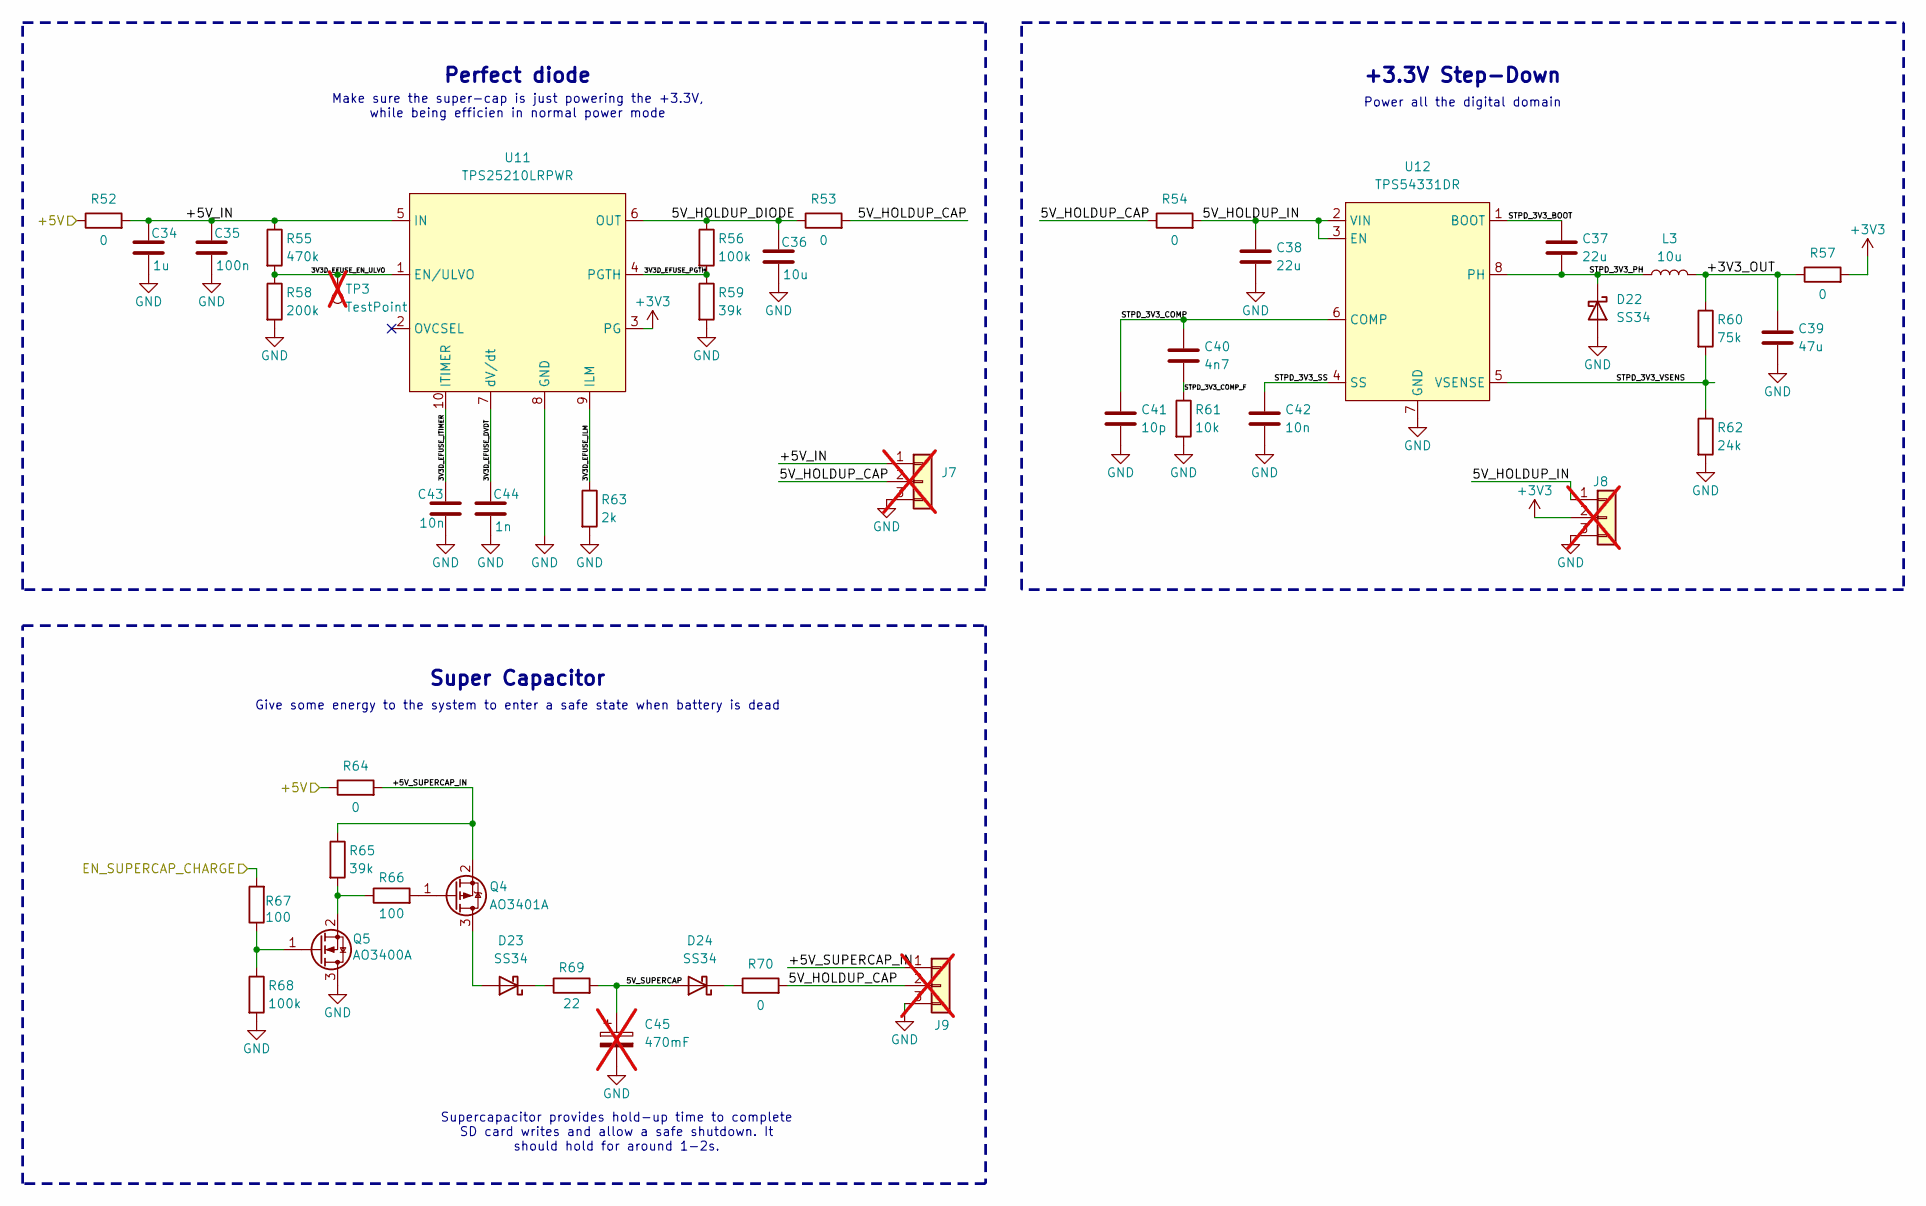
[picture p53: schematic pwr_3v3d.kicad_sch]

Parts:
C34: 1u; C_0805_2012Metric; LCSC C28323
C35: 100n; C_0603_1608Metric; LCSC C14663
C36: 10u; C_0805_2012Metric; LCSC C15850
C37, C38: 22u; C_1206_3216Metric; LCSC C12891
C39: 47u; C_1206_3216Metric; LCSC C96123
C40: 4n7; C_0603_1608Metric; LCSC C53987
C41: 10p; C_0603_1608Metric; LCSC C1634
C42, C43: 10n; C_0603_1608Metric; LCSC C57112
C44: 1n; C_0603_1608Metric; LCSC C1588
C45: 470mF; C_Radial_D8.0mm_P11.50mm; not fitted
D22, D23, D24: SS34; D_SMA; LCSC C8678
J7, J8, J9: Conn_01x03; PinHeader_1x03_P2.54mm_Vertical; not fitted
L3: 10u; L_Sunlord_MWSA0503S; LCSC C177248
Q4: AO3401A; SOT-23; LCSC C15127
Q5: AO3400A; SOT-23; LCSC C20917
R52, R53, R54, R57, R64, R70: 0; R_1206_3216Metric; LCSC C17888
R55: 470k; R_0603_1608Metric; LCSC C23178
R56, R68: 100k; R_0603_1608Metric; LCSC C25803
R58: 200k; R_0603_1608Metric; LCSC C25811
R59, R65: 39k; R_0603_1608Metric; LCSC C23153
R60: 75k; R_0603_1608Metric; LCSC C23242
R61: 10k; R_0603_1608Metric; LCSC C25804
R62: 24k; R_0603_1608Metric; LCSC C23352
R63: 2k; R_0603_1608Metric; LCSC C22975
R66, R67: 100; R_0603_1608Metric; LCSC C22775
R69: 22; R_2512_6332Metric; LCSC C2974113
TP3: TestPoint; TestPoint_THTPad_1.0x1.0mm_Drill0.5mm; not fitted
U11: TPS25210LRPWR; VQFN-HR-10; LCSC C2861226
U12: TPS54331DR; SOIC-8_3.9x4.9mm_P1.27mm; LCSC C9865

Connections:
+3V3: J8.2, R57.2, U11.3 (PG); also elsewhere on the board
+5V: R52.1, R64.1; also elsewhere on the board
/PWR_3V3D/3V3D_EFUSE_DVDT: C44.1, U11.7 (dV/dt)
/PWR_3V3D/3V3D_EFUSE_EN_ULVO: R55.2, R58.1, TP3.1, U11.1 (EN/ULVO)
/PWR_3V3D/3V3D_EFUSE_ILM: R63.1, U11.9 (ILM)
/PWR_3V3D/3V3D_EFUSE_ITIMER: C43.1, U11.10 (ITIMER)
/PWR_3V3D/3V3D_EFUSE_PGTH: R56.2, R59.1, U11.4 (PGTH)
/PWR_3V3D/5V_CAP_CHG: D23.1 (K), R69.1
/PWR_3V3D/5V_HOLDUP: C36.1, R53.1, R56.1, U11.6 (OUT)
/PWR_3V3D/5V_HOLDUP_IN: C38.1, J8.1, R54.2, U12.2 (VIN), U12.3 (EN)
/PWR_3V3D/5V_HOLDUP_bridge: J7.2, J9.2, R53.2, R54.1, R70.2
/PWR_3V3D/5V_SUPERCAP: C45.1, D24.2 (A), R69.2
/PWR_3V3D/5V_SUPERCAP_OUT: D24.1 (K), R70.1
/PWR_3V3D/+3V3_OUT: C39.1, L3.2, R57.1, R60.1
/PWR_3V3D/+5V_CAP_CHG_SW: D23.2 (A), Q4.3 (D)
/PWR_3V3D/+5V_IN: C34.1, C35.1, J7.1, R52.2, R55.1, U11.5 (IN)
/PWR_3V3D/+5V_SUPERCAP_IN: J9.1, Q4.2 (S), R64.2, R65.1
/PWR_3V3D/STPD_3V3_BOOT: C37.1, U12.1 (BOOT)
/PWR_3V3D/STPD_3V3_COMP: C40.1, C41.1, U12.6 (COMP)
/PWR_3V3D/STPD_3V3_COMP_F: C40.2, R61.1
/PWR_3V3D/STPD_3V3_PH: C37.2, D22.1 (K), L3.1, U12.8 (PH)
/PWR_3V3D/STPD_3V3_SS: C42.1, U12.4 (SS)
/PWR_3V3D/STPD_3V3_VSENS: R60.2, R62.1, U12.5 (VSENSE)
/PWR_3V3D/SUPERCAP_CHG_GATE: Q4.1 (G), R66.2
/PWR_3V3D/SUPERCAP_CHG_GATE_PULL: Q5.2 (S), R65.2, R66.1
GND: C34.2, C35.2, C36.2, C38.2, C39.2, C41.2, C42.2, C43.2, C44.2, C45.2, D22.2 (A), J7.3, J8.3, J9.3, Q5.3 (D), R58.2, R59.2, R61.2, R62.2, R63.2, R68.2, U11.8 (GND), U12.7 (GND); also elsewhere on the board

Notes on the sheet:
Make sure the super-cap is just powering the +3.3V, while being efficien in normal power mode
Super Capacitor
Give some energy to the system to enter a safe state when battery is dead
+3.3V Step-Down
Power all the digital domain
Supercapacitor provides hold-up time to complete SD card writes and allow a safe shutdown. It should hold for around 1-2s.
Perfect diode

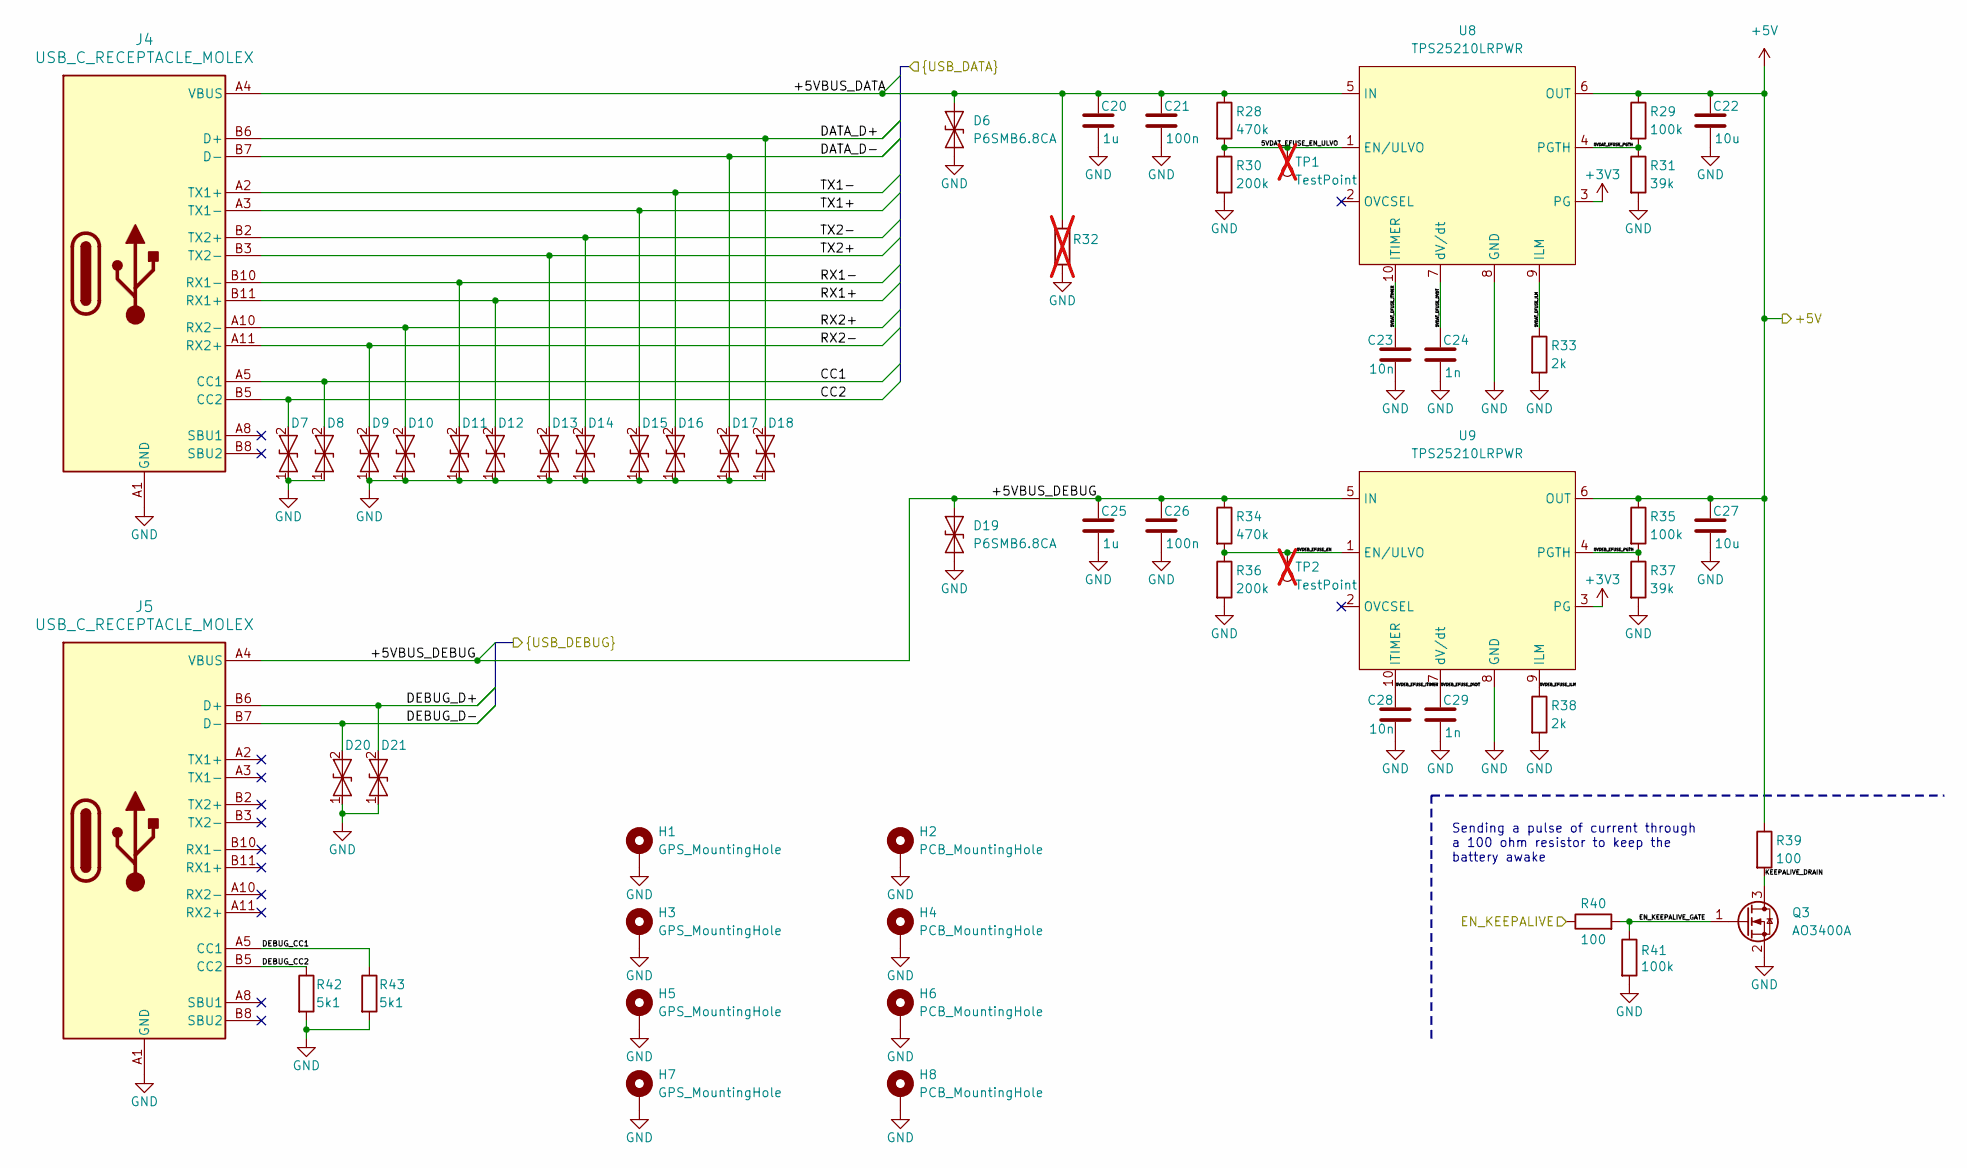
[picture p54: schematic connectors_io.kicad_sch]

Parts:
C20, C25: 1u; C_0805_2012Metric; LCSC C28323
C21, C26: 100n; C_0603_1608Metric; LCSC C14663
C22, C27: 10u; C_0805_2012Metric; LCSC C15850
C23, C28: 10n; C_0603_1608Metric; LCSC C57112
C24, C29: 1n; C_0603_1608Metric; LCSC C1588
D6, D19: P6SMB6.8CA; D_SMB; LCSC C7420377
D7, D8, D9, D10, D11, D12, D13, D14, D15, D16, D17, D18, D20, D21: H5VUD5BB; D_SOD-523; LCSC C20615820
H1, H3, H5, H7: GPS_MountingHole; MountingHole_3.2mm_M3_DIN965_Pad_TopBottom
H2, H4, H6, H8: PCB_MountingHole; MountingHole_3.2mm_M3_DIN965_Pad_TopBottom
J4, J5: USB_C_RECEPTACLE_MOLEX; CONN_201267-0005_MOL; LCSC C565324
Q3: AO3400A; SOT-23; LCSC C20917
R28, R34: 470k; R_0603_1608Metric; LCSC C23178
R29, R35, R41: 100k; R_0603_1608Metric; LCSC C25803
R30, R36: 200k; R_0603_1608Metric; LCSC C25811
R31, R37: 39k; R_0603_1608Metric; LCSC C23153
R32: R_1206_3216Metric_Pad1.30x1.75mm_HandSolder; not fitted
R33, R38: 2k; R_0603_1608Metric; LCSC C22975
R39, R40: 100; R_0603_1608Metric; LCSC C22775
R42, R43: 5k1; R_0603_1608Metric; LCSC C23186
TP1, TP2: TestPoint; TestPoint_THTPad_1.0x1.0mm_Drill0.5mm; not fitted
U8, U9: TPS25210LRPWR; VQFN-HR-10; LCSC C2861226

Connections:
+3V3: U8.3 (PG), U9.3 (PG); also elsewhere on the board
+5V: C22.1, C27.1, R29.1, R35.1, R39.1, U8.6 (OUT), U9.6 (OUT); also elsewhere on the board
/DATA_SAVING/+5VBUS_DATA: C20.1, C21.1, D6.2 (A2), J4.A4 (VBUS), J4.A9 (VBUS), J4.B4 (VBUS), J4.B9 (VBUS), R28.1, R32.2, U8.5 (IN); also elsewhere on the board
/DATA_SAVING/CC1: D8.2, J4.A5 (CC1); also elsewhere on the board
/DATA_SAVING/CC2: D7.2, J4.B5 (CC2); also elsewhere on the board
/DATA_SAVING/DATA_D+: D18.2, J4.A6 (D+), J4.B6 (D+); also elsewhere on the board
/DATA_SAVING/DATA_D-: D17.2, J4.A7 (D-), J4.B7 (D-); also elsewhere on the board
/DATA_SAVING/RX1+: D12.2, J4.B11 (RX1+); also elsewhere on the board
/DATA_SAVING/RX1-: D11.2, J4.B10 (RX1-); also elsewhere on the board
/DATA_SAVING/RX2+: D10.2, J4.A10 (RX2-); also elsewhere on the board
/DATA_SAVING/RX2-: D9.2, J4.A11 (RX2+); also elsewhere on the board
/DATA_SAVING/TX1+: D15.2, J4.A3 (TX1-); also elsewhere on the board
/DATA_SAVING/TX1-: D16.2, J4.A2 (TX1+); also elsewhere on the board
/DATA_SAVING/TX2+: D13.2, J4.B3 (TX2-); also elsewhere on the board
/DATA_SAVING/TX2-: D14.2, J4.B2 (TX2+); also elsewhere on the board
/IO_CONNECTOR/5VDAT_EFUSE_DVDT: C24.1, U8.7 (dV/dt)
/IO_CONNECTOR/5VDAT_EFUSE_EN_ULVO: R28.2, R30.1, TP1.1, U8.1 (EN/ULVO)
/IO_CONNECTOR/5VDAT_EFUSE_ILM: R33.1, U8.9 (ILM)
/IO_CONNECTOR/5VDAT_EFUSE_ITIMER: C23.1, U8.10 (ITIMER)
/IO_CONNECTOR/5VDAT_EFUSE_PGTH: R29.2, R31.1, U8.4 (PGTH)
/IO_CONNECTOR/5VDEB_EFUSE_DVDT: C29.1, U9.7 (dV/dt)
/IO_CONNECTOR/5VDEB_EFUSE_EN: R34.2, R36.1, TP2.1, U9.1 (EN/ULVO)
/IO_CONNECTOR/5VDEB_EFUSE_ILM: R38.1, U9.9 (ILM)
/IO_CONNECTOR/5VDEB_EFUSE_ITIMER: C28.1, U9.10 (ITIMER)
/IO_CONNECTOR/5VDEB_EFUSE_PGTH: R35.2, R37.1, U9.4 (PGTH)
/IO_CONNECTOR/+5VBUS_DEBUG: C25.1, C26.1, D19.2 (A2), J5.A4 (VBUS), J5.A9 (VBUS), J5.B4 (VBUS), J5.B9 (VBUS), R34.1, U9.5 (IN); also elsewhere on the board
/IO_CONNECTOR/DEBUG_CC1: J5.A5 (CC1), R43.1
/IO_CONNECTOR/DEBUG_CC2: J5.B5 (CC2), R42.1
/IO_CONNECTOR/DEBUG_D+: D21.2, J5.A6 (D+), J5.B6 (D+); also elsewhere on the board
/IO_CONNECTOR/DEBUG_D-: D20.2, J5.A7 (D-), J5.B7 (D-); also elsewhere on the board
/IO_CONNECTOR/EN_KEEPALIVE: R40.1; also elsewhere on the board
/IO_CONNECTOR/EN_KEEPALIVE_GATE: Q3.1 (G), R40.2, R41.1
/IO_CONNECTOR/KEEPALIVE_DRAIN: Q3.3 (D), R39.2
GND: C20.2, C21.2, C22.2, C23.2, C24.2, C25.2, C26.2, C27.2, C28.2, C29.2, D6.1 (A1), D7.1, D8.1, D9.1, D10.1, D11.1, D12.1, D13.1, D14.1, D15.1, D16.1, D17.1, D18.1, D19.1 (A1), D20.1, D21.1, H1.1, H2.1, H3.1, H4.1, H5.1, H6.1, H7.1, H8.1, J4.A1 (GND), J4.A12 (GND), J4.B1 (GND), J4.B12 (GND), J5.A1 (GND), J5.A12 (GND), J5.B1 (GND), J5.B12 (GND), Q3.2 (S), R30.2, R31.2, R32.1, R33.2, R36.2, R37.2, R38.2, R41.2, R42.2, R43.2, U8.8 (GND), U9.8 (GND); also elsewhere on the board

Notes on the sheet:
Sending a pulse of current through a 100 ohm resistor to keep the battery awake

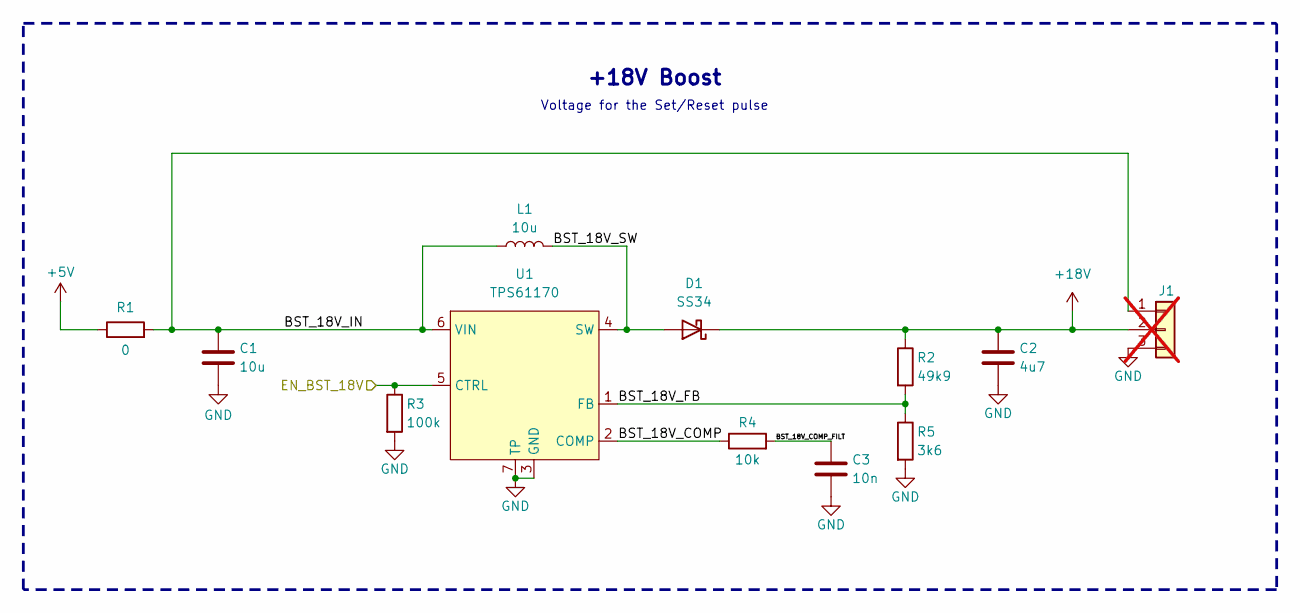
[picture p55: schematic sensor_set_reset_driver.kicad_sch]

Parts:
C1: 10u; C_0805_2012Metric; LCSC C15850
C2: 4u7; C_1206_3216Metric; LCSC C29823
C3: 10n; C_0603_1608Metric; LCSC C57112
D1: SS34; D_SMA; LCSC C8678
J1: Conn_01x03; PinHeader_1x03_P2.54mm_Vertical; not fitted
L1: 10u; L_Sunlord_MWSA0503S; LCSC C177248
R1: 0; R_1206_3216Metric; LCSC C17888
R2: 49k9; R_0603_1608Metric; LCSC C23184
R3: 100k; R_0603_1608Metric; LCSC C25803
R4: 10k; R_0603_1608Metric; LCSC C25804
R5: 3k6; R_0603_1608Metric; LCSC C22980
U1: TPS61170; WSON-6-1EP_2x2mm_P0.65mm_EP1x1.6mm; LCSC C15163

Connections:
+5V: R1.1; also elsewhere on the board
+18V: C2.1, D1.1 (K), J1.2, R2.1
/MCU_ESP32S3/EN_BST_18V: R3.1, U1.5 (CTRL); also elsewhere on the board
/SENSOR_SET_RESET_DRIVER/BST_18V_COMP: R4.1, U1.2 (COMP)
/SENSOR_SET_RESET_DRIVER/BST_18V_COMP_FILT: C3.1, R4.2
/SENSOR_SET_RESET_DRIVER/BST_18V_FB: R2.2, R5.1, U1.1 (FB)
/SENSOR_SET_RESET_DRIVER/BST_18V_IN: C1.1, J1.1, L1.1, R1.2, U1.6 (VIN)
/SENSOR_SET_RESET_DRIVER/BST_18V_SW: D1.2 (A), L1.2, U1.4 (SW)
GND: C1.2, C2.2, C3.2, J1.3, R3.2, R5.2, U1.3 (GND), U1.7 (TP); also elsewhere on the board

Notes on the sheet:
+18V Boost
Voltage for the Set/Reset pulse
