Benjamin-girard-1/magnetometer-node/hardware/pcb/Digital_test_board/Digital_test_board.kicad_pcb

## KiCad design hardware/pcb/Digital_test_board/Digital_test_board.kicad_pcb (continued)

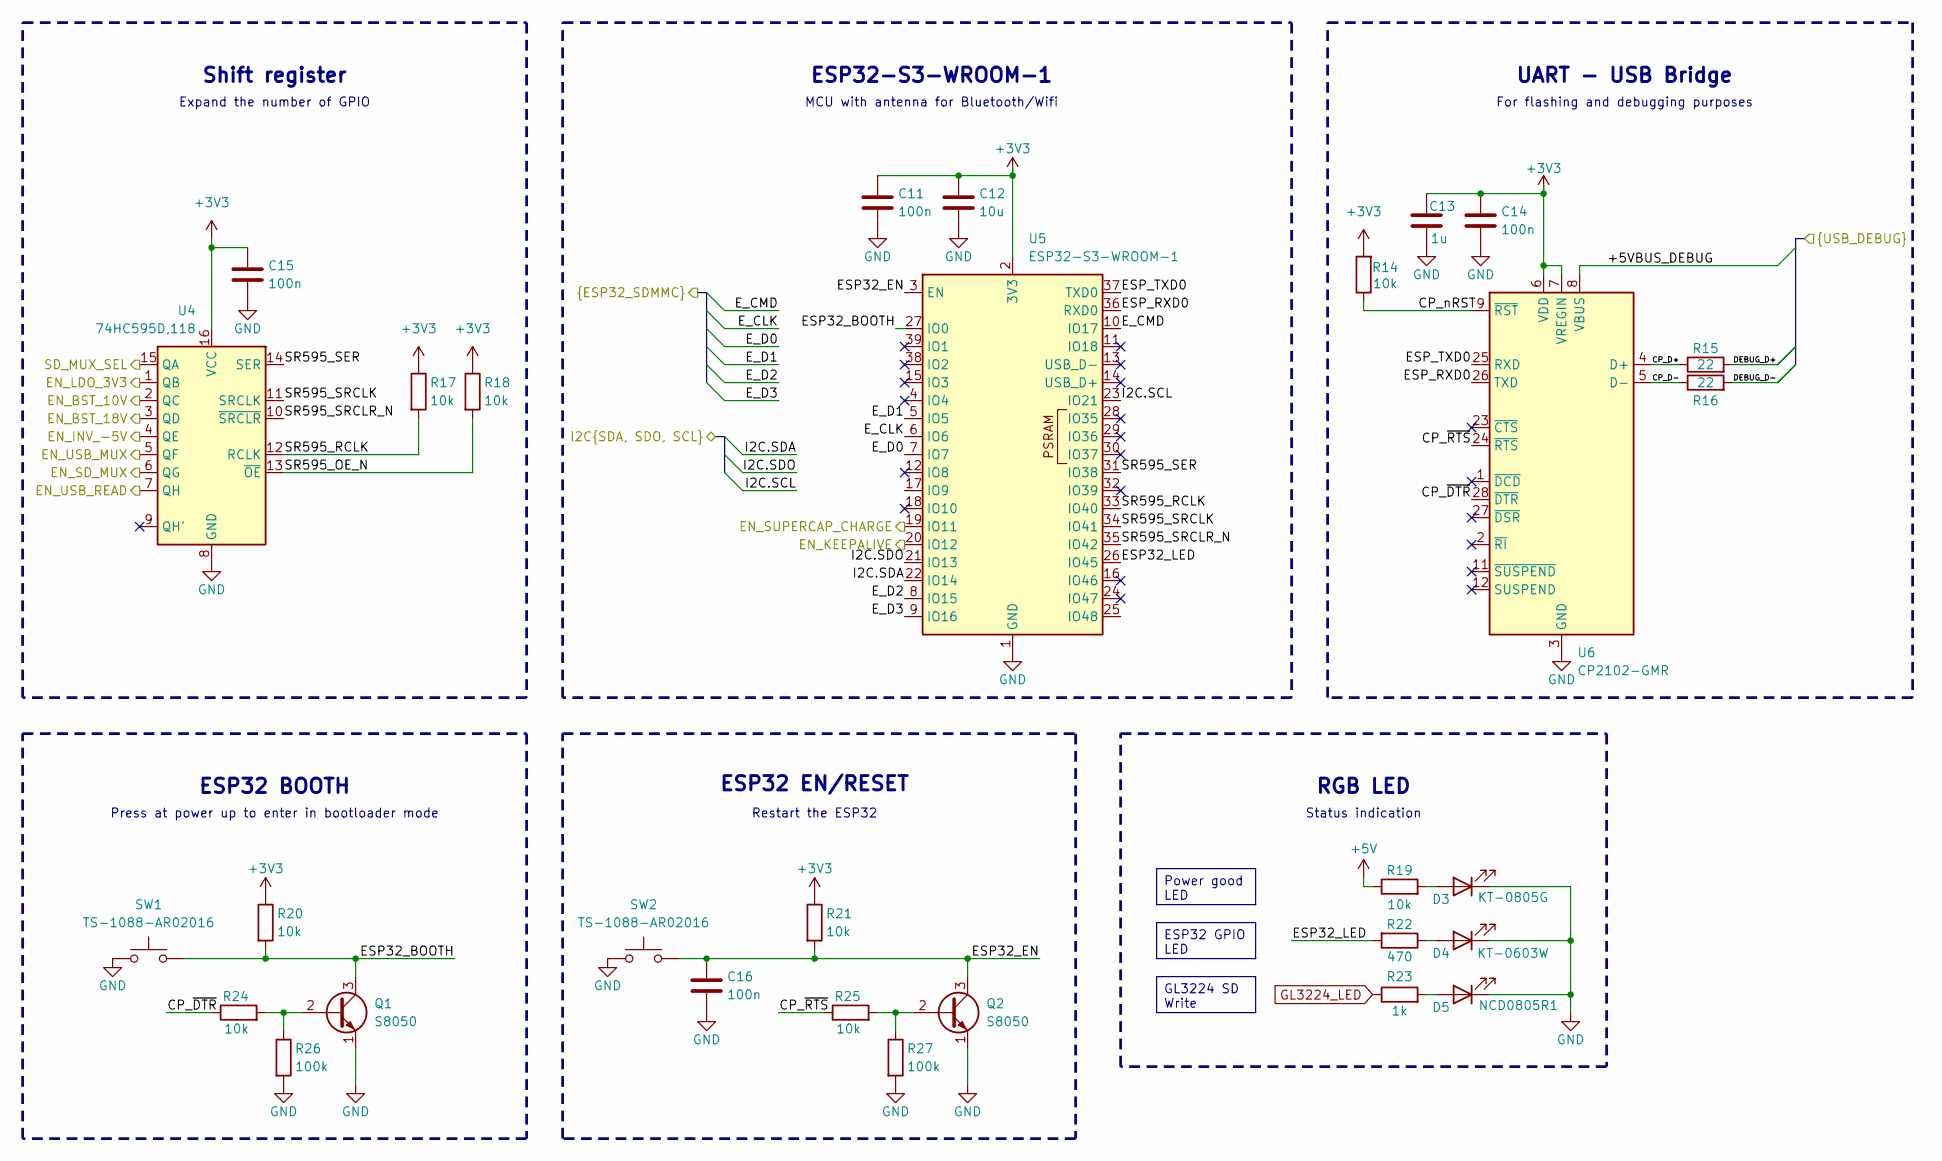
[picture p56: schematic mcu_esp32s3.kicad_sch]

Parts:
C11, C14, C15, C16: 100n; C_0603_1608Metric; LCSC C14663
C12: 10u; C_0805_2012Metric; LCSC C15850
C13: 1u; C_0805_2012Metric; LCSC C28323
D3: KT-0805G; LED_0805_2012Metric; LCSC C2297
D4: KT-0603W; LED_0603_1608Metric; LCSC C2290
D5: NCD0805R1; LED_0805_2012Metric; LCSC C84256
Q1, Q2: S8050; SOT-23; LCSC C2146
R14, R17, R18, R19, R20, R21, R24, R25: 10k; R_0603_1608Metric; LCSC C25804
R15, R16: 22; R_0603_1608Metric; LCSC C23345
R22: 470; R_0603_1608Metric; LCSC C23179
R23: 1k; R_0603_1608Metric; LCSC C21190
R26, R27: 100k; R_0603_1608Metric; LCSC C25803
SW1, SW2: TS-1088-AR02016; LCSC C720477
U4: 74HC595D,118; SOIC-16_3.9x9.9mm_P1.27mm; LCSC C5947
U5: ESP32-S3-WROOM-1; LCSC C2913202
U6: CP2102-GMR; QFN-28-1EP_5x5mm_P0.5mm_EP3.25x3.25mm; LCSC C6568

Connections:
+3V3: C11.1, C12.1, C13.1, C14.1, C15.1, R14.2, R17.1, R18.1, R20.1, R21.1, U4.16 (VCC), U5.2 (3V3), U6.6 (VDD), U6.7 (VREGIN); also elsewhere on the board
+5V: R19.1; also elsewhere on the board
/DATA_SAVING/EN_SD_MUX: U4.6 (QG); also elsewhere on the board
/DATA_SAVING/EN_USB_MUX: U4.5 (QF); also elsewhere on the board
/DATA_SAVING/EN_USB_READ: U4.7 (QH); also elsewhere on the board
/DATA_SAVING/E_CLK: U5.6 (IO6); also elsewhere on the board
/DATA_SAVING/E_CMD: U5.10 (IO17); also elsewhere on the board
/DATA_SAVING/E_D0: U5.7 (IO7); also elsewhere on the board
/DATA_SAVING/E_D1: U5.5 (IO5); also elsewhere on the board
/DATA_SAVING/E_D2: U5.8 (IO15); also elsewhere on the board
/DATA_SAVING/E_D3: U5.9 (IO16); also elsewhere on the board
/DATA_SAVING/SD_MUX_SEL: U4.15 (QA); also elsewhere on the board
/IMU/I2C.SCL: U5.23 (IO21); also elsewhere on the board
/IMU/I2C.SDA: U5.22 (IO14); also elsewhere on the board
/IMU/I2C.SDO: U5.21 (IO13); also elsewhere on the board
/IO_CONNECTOR/+5VBUS_DEBUG: U6.8 (VBUS); also elsewhere on the board
/IO_CONNECTOR/DEBUG_D+: R15.2; also elsewhere on the board
/IO_CONNECTOR/DEBUG_D-: R16.2; also elsewhere on the board
/IO_CONNECTOR/EN_KEEPALIVE: U5.20 (IO12); also elsewhere on the board
/MCU_ESP32S3/CP_D+: R15.1, U6.4 (D+)
/MCU_ESP32S3/CP_D-: R16.1, U6.5 (D-)
/MCU_ESP32S3/CP_nRST: R14.1, U6.9 (~RST)
/MCU_ESP32S3/CP_~DTR: R24.1, U6.28 (~DTR)
/MCU_ESP32S3/CP_~RTS: R25.1, U6.24 (~RTS)
/MCU_ESP32S3/EN_BST_10V: U4.2 (QC); also elsewhere on the board
/MCU_ESP32S3/EN_BST_18V: U4.3 (QD); also elsewhere on the board
/MCU_ESP32S3/EN_INV_-5V: U4.4 (QE); also elsewhere on the board
/MCU_ESP32S3/EN_LDO_3V3: U4.1 (QB); also elsewhere on the board
/MCU_ESP32S3/ESP32_BOOTH: Q1.3 (C), R20.2, SW1.2, U5.27 (IO0)
/MCU_ESP32S3/ESP32_EN: C16.1, Q2.3 (C), R21.2, SW2.2, U5.3 (EN)
/MCU_ESP32S3/ESP32_LED: R22.2, U5.26 (IO45)
/MCU_ESP32S3/ESP_RXD0: U5.36 (RXD0), U6.26 (TXD)
/MCU_ESP32S3/ESP_TXD0: U5.37 (TXD0), U6.25 (RXD)
/MCU_ESP32S3/SR595_OE_N: R18.2, U4.13 (~OE)
/MCU_ESP32S3/SR595_RCLK: R17.2, U4.12 (RCLK), U5.33 (IO40)
/MCU_ESP32S3/SR595_SER: U4.14 (SER), U5.31 (IO38)
/MCU_ESP32S3/SR595_SRCLK: U4.11 (SRCLK), U5.34 (IO41)
/MCU_ESP32S3/SR595_SRCLR_N: U4.10 (~SRCLR), U5.35 (IO42)
GL3224_LED: R23.1; also elsewhere on the board
GND: C11.2, C12.2, C13.2, C14.2, C15.2, C16.2, D3.1 (K), D4.1 (K), D5.1 (K), Q1.1 (E), Q2.1 (E), R26.2, R27.2, SW1.1, SW2.1, U4.8 (GND), U5.1 (GND), U5.40 (GND), U5.41 (GND), U6.3 (GND), U6.29 (GND); also elsewhere on the board
unnamed: D3.2 (A), R19.2
unnamed: D4.2 (A), R22.1
unnamed: D5.2 (A), R23.2
unnamed: Q1.2 (B), R24.2, R26.1
unnamed: Q2.2 (B), R25.2, R27.1

Notes on the sheet:
Shift register
Expand the number of GPIO
Restart the ESP32
ESP32-S3-WROOM-1
Press at power up to enter in bootloader mode
ESP32 BOOTH
Status indication
MCU with antenna for Bluetooth/Wifi
ESP32 EN/RESET
For flashing and debugging purposes
UART - USB Bridge
RGB LED
ESP32 GPIO LED
Power good LED
GL3224 SD Write

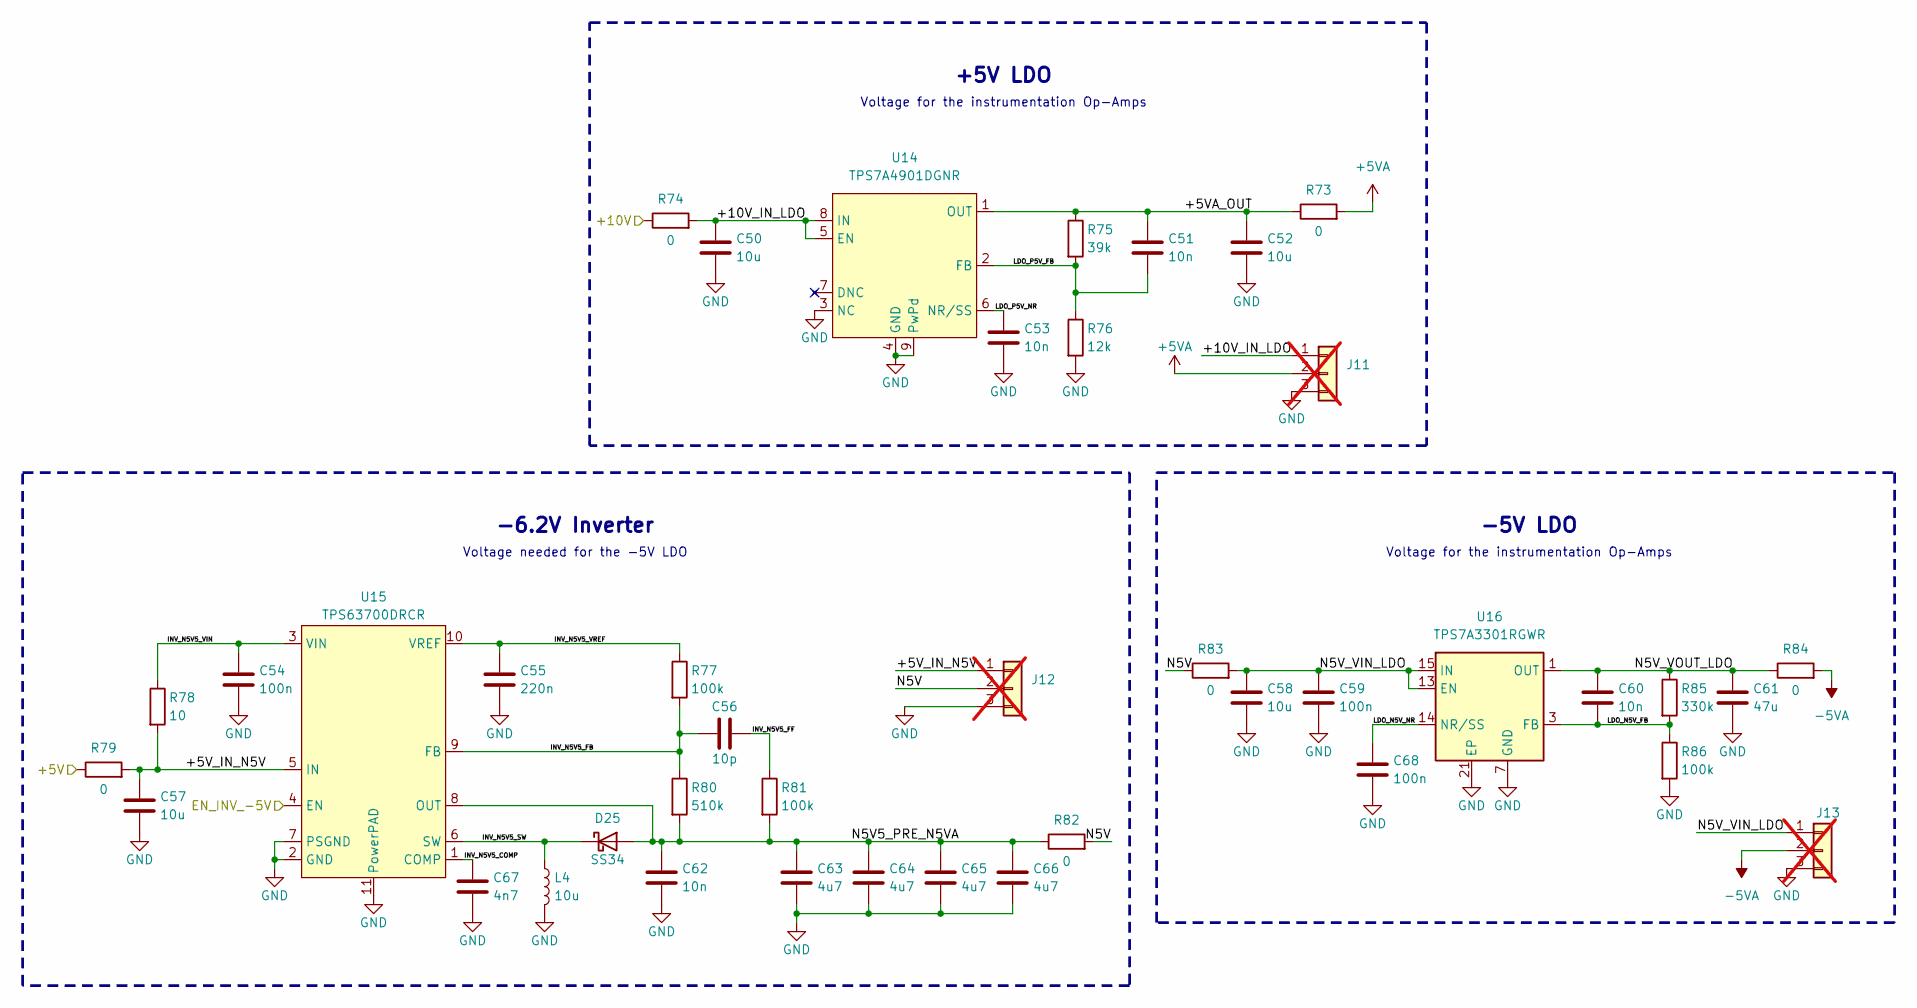
[picture p57: schematic pwr_opamp_4v5_neg5.kicad_sch]

Parts:
C50, C52, C57, C58: 10u; C_0805_2012Metric; LCSC C15850
C51, C53, C60, C62: 10n; C_0603_1608Metric; LCSC C57112
C54, C59, C68: 100n; C_0603_1608Metric; LCSC C14663
C55: 220n; C_0603_1608Metric; LCSC C21120
C56: 10p; C_0603_1608Metric; LCSC C1634
C61: 47u; C_1206_3216Metric; LCSC C96123
C63, C64, C65, C66: 4u7; C_1206_3216Metric; LCSC C29823
C67: 4n7; C_0603_1608Metric; LCSC C53987
D25: SS34; D_SMA; LCSC C8678
J11, J12, J13: Conn_01x03; PinHeader_1x03_P2.54mm_Vertical; not fitted
L4: 10u; L_Sunlord_MWSA0503S; LCSC C177248
R73, R74, R79, R82, R83, R84: 0; R_1206_3216Metric; LCSC C17888
R75: 39k; R_0603_1608Metric; LCSC C23153
R76: 12k; R_0603_1608Metric; LCSC C22790
R77, R81, R86: 100k; R_0603_1608Metric; LCSC C25803
R78: 10; R_0603_1608Metric; LCSC C22859
R80: 510k; R_0603_1608Metric; LCSC C23192
R85: 330k; R_0603_1608Metric; LCSC C23137
U14: TPS7A4901DGNR; HVSSOP-8-1EP_3x3mm_P0.65mm_EP1.57x1.89mm; LCSC C16430
U15: TPS63700DRCR; VSON-10-1EP_3x3mm_P0.5mm_EP1.2x2mm; LCSC C54792
U16: TPS7A3301RGWR; Texas_RGW0020A_VQFN-20-1EP_5x5mm_P0.65mm_EP3.15x3.15mm; LCSC C90082

Connections:
+5V: R79.1; also elsewhere on the board
+5VA: J11.2, R73.2
-5VA: J13.2, R84.2
/MCU_ESP32S3/EN_INV_-5V: U15.4 (EN); also elsewhere on the board
/PWR_5VA_NEG5/+5VA_OUT: C51.1, C52.1, R73.1, R75.1, U14.1 (OUT)
/PWR_5VA_NEG5/+5V_IN_N5V: C57.1, J12.1, R78.2, R79.2, U15.5 (IN)
/PWR_5VA_NEG5/+10V_IN_LDO: C50.1, J11.1, R74.2, U14.5 (EN), U14.8 (IN)
/PWR_5VA_NEG5/INV_N5V5_COMP: C67.1, U15.1 (COMP)
/PWR_5VA_NEG5/INV_N5V5_FB: C56.1, R77.2, R80.1, U15.9 (FB)
/PWR_5VA_NEG5/INV_N5V5_FF: C56.2, R81.1
/PWR_5VA_NEG5/INV_N5V5_SW: D25.1 (K), L4.1, U15.6 (SW)
/PWR_5VA_NEG5/INV_N5V5_VIN: C54.1, R78.1, U15.3 (VIN)
/PWR_5VA_NEG5/INV_N5V5_VREF: C55.1, R77.1, U15.10 (VREF)
/PWR_5VA_NEG5/LDO_N5V_FB: C60.2, R85.2, R86.1, U16.3 (FB)
/PWR_5VA_NEG5/LDO_N5V_NR: C68.1, U16.14 (NR/SS)
/PWR_5VA_NEG5/LDO_P5V_FB: C51.2, R75.2, R76.1, U14.2 (FB)
/PWR_5VA_NEG5/LDO_P5V_NR: C53.1, U14.6 (NR/SS)
/PWR_5VA_NEG5/N5V5_PRE_N5VA: C62.1, C63.1, C64.1, C65.1, C66.1, D25.2 (A), R80.2, R81.2, R82.1, U15.8 (OUT)
/PWR_5VA_NEG5/N5V5_PRE_N5VA_bridge: J12.2, R82.2, R83.1
/PWR_5VA_NEG5/N5V_VIN_LDO: C58.1, C59.1, J13.1, R83.2, U16.13 (EN), U16.15 (IN), U16.16 (IN)
/PWR_5VA_NEG5/N5V_VOUT_LDO: C60.1, C61.1, R84.1, R85.1, U16.1 (OUT), U16.20 (OUT)
/PWR_9V_BRIDGE/+10V: R74.1; also elsewhere on the board
GND: C50.2, C52.2, C53.2, C54.2, C55.2, C57.2, C58.2, C59.2, C61.2, C62.2, C63.2, C64.2, C65.2, C66.2, C67.2, C68.2, J11.3, J12.3, J13.3, L4.2, R76.2, R86.2, U14.3 (NC), U14.4 (GND), U14.9 (PwPd), U15.2 (GND), U15.7 (PSGND), U15.11 (PowerPAD), U16.7 (GND), U16.21 (EP); also elsewhere on the board

Notes on the sheet:
-5V LDO
Voltage for the instrumentation Op-Amps
Voltage needed for the -5V LDO
+5V LDO
-6.2V Inverter

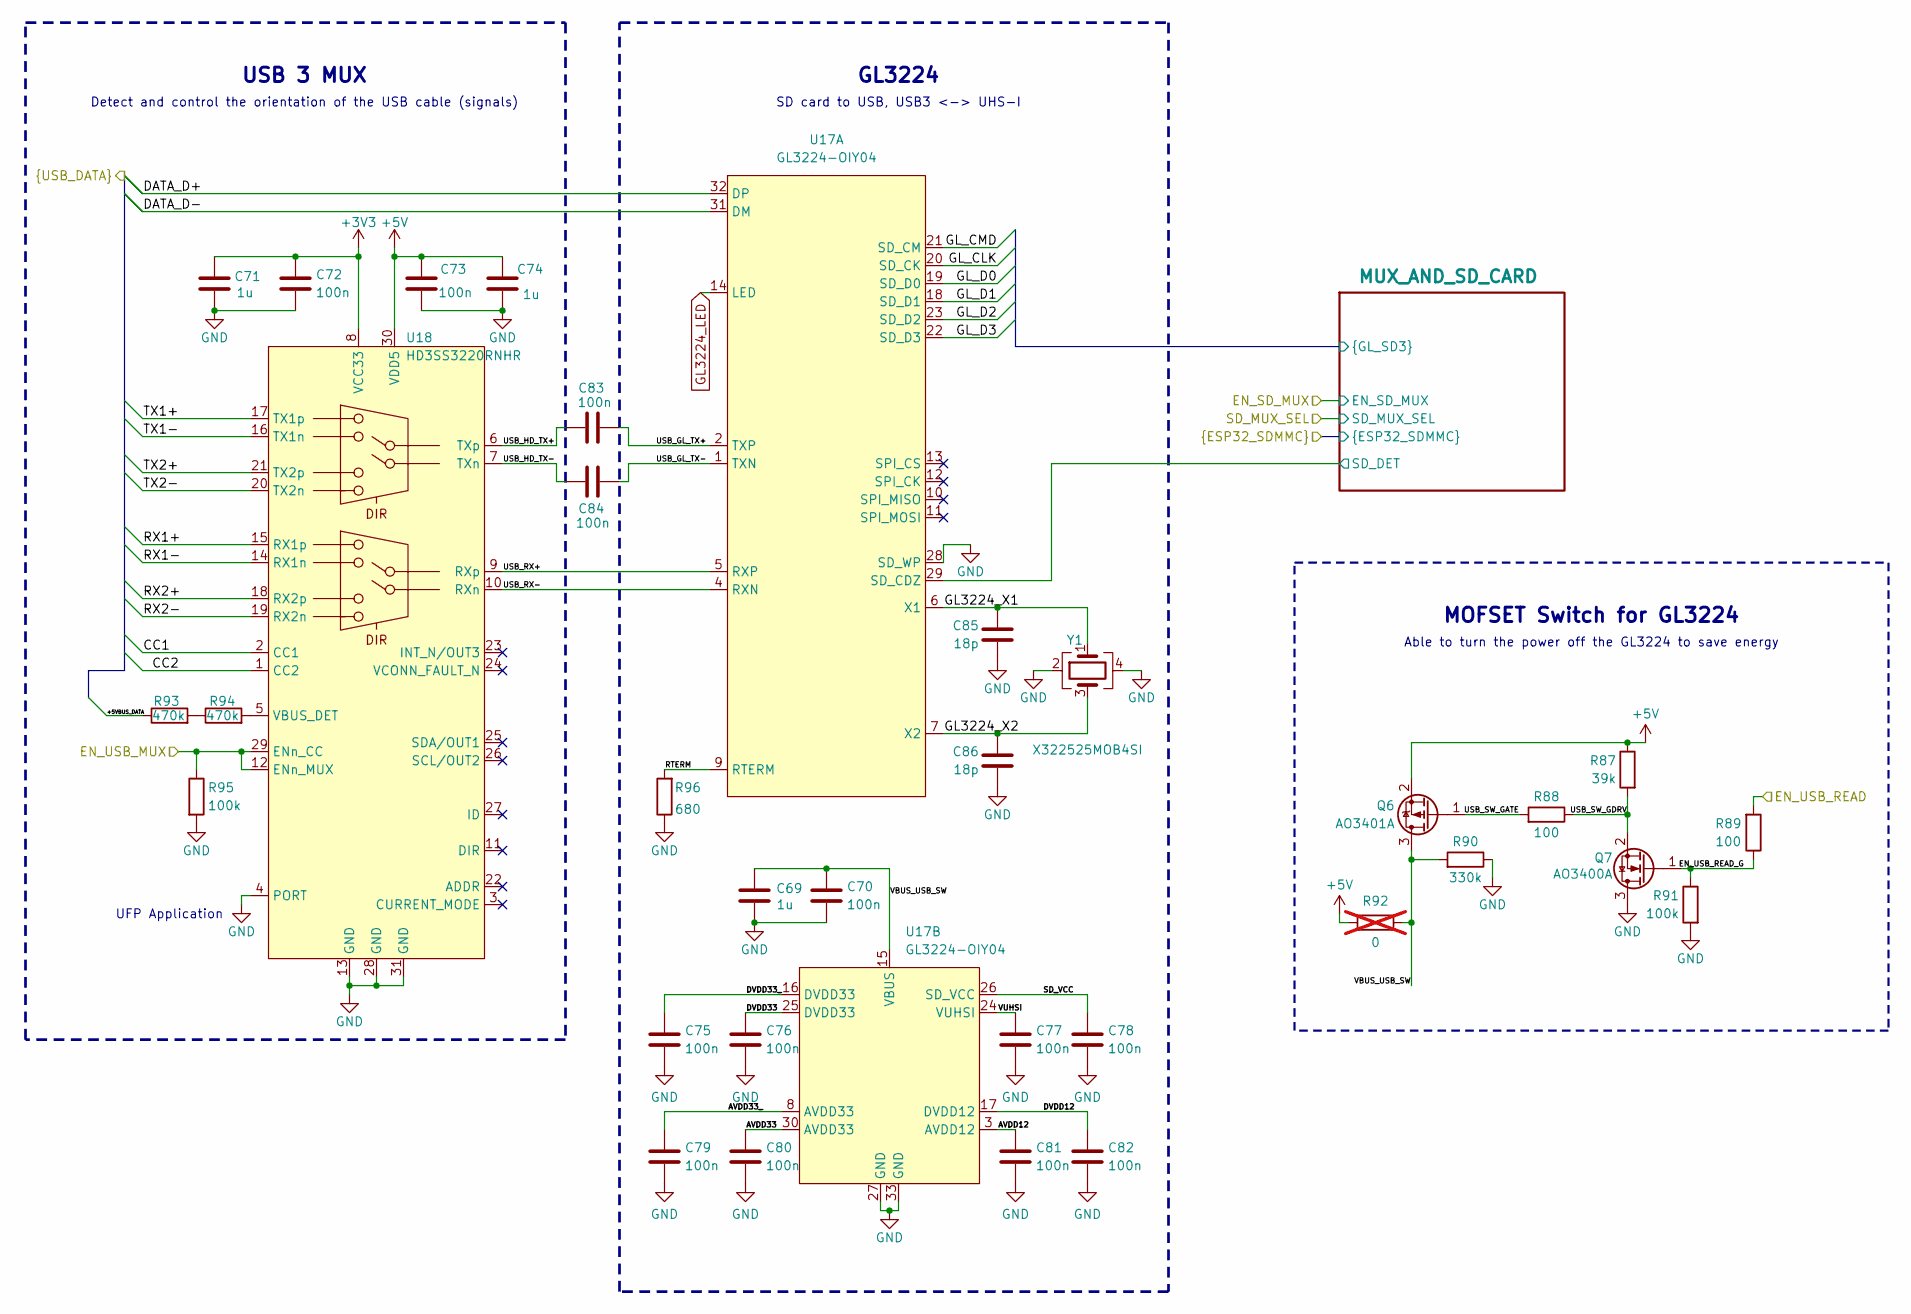
[picture p58: schematic sd_card_saving_usb_to_pc.kicad_sch]

Parts:
C69, C71, C74: 1u; C_0805_2012Metric; LCSC C28323
C70, C72, C73, C75, C76, C77, C78, C79, C80, C81, C82, C83, C84: 100n; C_0603_1608Metric; LCSC C14663
C85, C86: 18p; C_0603_1608Metric; LCSC C1647
Q6: AO3401A; SOT-23; LCSC C15127
Q7: AO3400A; SOT-23; LCSC C20917
R87: 39k; R_0603_1608Metric; LCSC C23153
R88, R89: 100; R_0603_1608Metric; LCSC C22775
R90: 330k; R_0603_1608Metric; LCSC C23137
R91, R95: 100k; R_0603_1608Metric; LCSC C25803
R92: 0; R_1206_3216Metric; LCSC C17888; not fitted
R93, R94: 470k; R_0603_1608Metric; LCSC C23178
R96: 680; R_0603_1608Metric; LCSC C23228
U17: GL3224-OIY04; QFN-32-1EP_5x5mm_P0.5mm_EP3.1x3.1mm; LCSC C157357
U18: HD3SS3220RNHR; Texas_RNH0030A_WQFN-30-1EP_2.5x4.5mm_P0.4mm_EP1.2x3.2mm; LCSC C165155
Y1: X322525MOB4SI; Crystal_SMD_3225-4Pin_3.2x2.5mm; LCSC C9006

Connections:
+3V3: C71.2, C72.1, U18.8 (VCC33); also elsewhere on the board
+5V: C73.1, C74.2, Q6.2 (S), R87.1, R92.2, U18.30 (VDD5); also elsewhere on the board
/DATA_SAVING/+5VBUS_DATA: R93.1; also elsewhere on the board
/DATA_SAVING/+5VBUS_DET: R94.2, U18.5 (VBUS_DET)
/DATA_SAVING/AVDD12: C81.1, U17.3 (AVDD12)
/DATA_SAVING/AVDD33: C80.1, U17.30 (AVDD33)
/DATA_SAVING/AVDD33_: C79.1, U17.8 (AVDD33)
/DATA_SAVING/CC1: U18.2 (CC1); also elsewhere on the board
/DATA_SAVING/CC2: U18.1 (CC2); also elsewhere on the board
/DATA_SAVING/DATA_D+: U17.32 (DP); also elsewhere on the board
/DATA_SAVING/DATA_D-: U17.31 (DM); also elsewhere on the board
/DATA_SAVING/DVDD12: C82.1, U17.17 (DVDD12)
/DATA_SAVING/DVDD33: C76.1, U17.25 (DVDD33)
/DATA_SAVING/DVDD33_: C75.1, U17.16 (DVDD33)
/DATA_SAVING/EN_USB_MUX: R95.1, U18.12 (ENn_MUX), U18.29 (ENn_CC); also elsewhere on the board
/DATA_SAVING/EN_USB_READ: R89.2; also elsewhere on the board
/DATA_SAVING/EN_USB_READ_G: Q7.1 (G), R89.1, R91.1
/DATA_SAVING/GL3224_X1: C85.1, U17.6 (X1), Y1.1
/DATA_SAVING/GL3224_X2: C86.1, U17.7 (X2), Y1.3
/DATA_SAVING/MUX_AND_SD_CARD/GL_CLK: U17.20 (SD_CK); also elsewhere on the board
/DATA_SAVING/MUX_AND_SD_CARD/GL_CMD: U17.21 (SD_CM); also elsewhere on the board
/DATA_SAVING/MUX_AND_SD_CARD/GL_D0: U17.19 (SD_D0); also elsewhere on the board
/DATA_SAVING/MUX_AND_SD_CARD/GL_D1: U17.18 (SD_D1); also elsewhere on the board
/DATA_SAVING/MUX_AND_SD_CARD/GL_D2: U17.23 (SD_D2); also elsewhere on the board
/DATA_SAVING/MUX_AND_SD_CARD/GL_D3: U17.22 (SD_D3); also elsewhere on the board
/DATA_SAVING/MUX_AND_SD_CARD/SD_DET: U17.29 (SD_CDZ); also elsewhere on the board
/DATA_SAVING/RTERM: R96.2, U17.9 (RTERM)
/DATA_SAVING/RX1+: U18.15 (RX1p); also elsewhere on the board
/DATA_SAVING/RX1-: U18.14 (RX1n); also elsewhere on the board
/DATA_SAVING/RX2+: U18.18 (RX2p); also elsewhere on the board
/DATA_SAVING/RX2-: U18.19 (RX2n); also elsewhere on the board
/DATA_SAVING/SD_VCC: C78.1, U17.26 (SD_VCC)
/DATA_SAVING/TX1+: U18.17 (TX1p); also elsewhere on the board
/DATA_SAVING/TX1-: U18.16 (TX1n); also elsewhere on the board
/DATA_SAVING/TX2+: U18.21 (TX2p); also elsewhere on the board
/DATA_SAVING/TX2-: U18.20 (TX2n); also elsewhere on the board
/DATA_SAVING/USB_GL_TX+: C83.2, U17.2 (TXP)
/DATA_SAVING/USB_GL_TX-: C84.2, U17.1 (TXN)
/DATA_SAVING/USB_HD_TX+: C83.1, U18.6 (TXp)
/DATA_SAVING/USB_HD_TX-: C84.1, U18.7 (TXn)
/DATA_SAVING/USB_RX+: U17.5 (RXP), U18.9 (RXp)
/DATA_SAVING/USB_RX-: U17.4 (RXN), U18.10 (RXn)
/DATA_SAVING/USB_SW_GATE: Q6.1 (G), R88.2
/DATA_SAVING/USB_SW_GDRV: Q7.2 (S), R87.2, R88.1
/DATA_SAVING/VBUS_USB_SW: C69.2, C70.1, Q6.3 (D), R90.2, R92.1, U17.15 (VBUS)
/DATA_SAVING/VUHSI: C77.1, U17.24 (VUHSI)
GL3224_LED: U17.14 (LED); also elsewhere on the board
GND: C69.1, C70.2, C71.1, C72.2, C73.2, C74.1, C75.2, C76.2, C77.2, C78.2, C79.2, C80.2, C81.2, C82.2, C85.2, C86.2, Q7.3 (D), R90.1, R91.2, R95.2, R96.1, U17.27 (GND), U17.28 (SD_WP), U17.33 (GND), U18.4 (PORT), U18.13 (GND), U18.28 (GND), U18.31 (GND), Y1.2, Y1.4; also elsewhere on the board
unnamed: R93.2, R94.1

Notes on the sheet:
USB 3 MUX
Detect and control the orientation of the USB cable (signals)
GL3224
UFP Application
MOFSET Switch for GL3224
Able to turn the power off the GL3224 to save energy
SD card to USB, USB3 <-> UHS-I

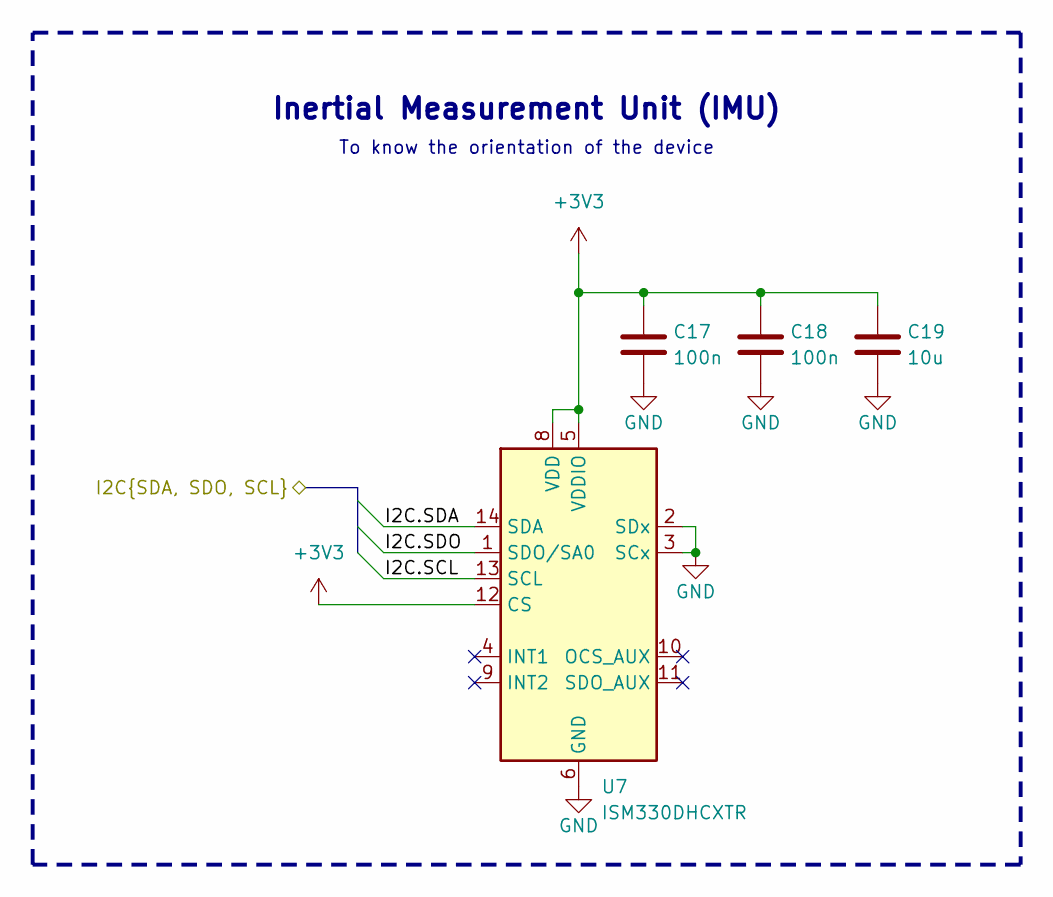
[picture p59: schematic imu.kicad_sch]

Parts:
C17, C18: 100n; C_0603_1608Metric; LCSC C14663
C19: 10u; C_0805_2012Metric; LCSC C15850
U7: ISM330DHCXTR; LGA-14_3x2.5mm_P0.5mm_LayoutBorder3x4y; LCSC C2655101

Connections:
+3V3: C17.1, C18.1, C19.1, U7.5 (VDDIO), U7.8 (VDD), U7.12 (CS); also elsewhere on the board
/IMU/I2C.SCL: U7.13 (SCL); also elsewhere on the board
/IMU/I2C.SDA: U7.14 (SDA); also elsewhere on the board
/IMU/I2C.SDO: U7.1 (SDO/SA0); also elsewhere on the board
GND: C17.2, C18.2, C19.2, U7.2 (SDx), U7.3 (SCx), U7.6 (GND), U7.7 (GND); also elsewhere on the board

Notes on the sheet:
Inertial Measurement Unit (IMU)
To know the orientation of the device

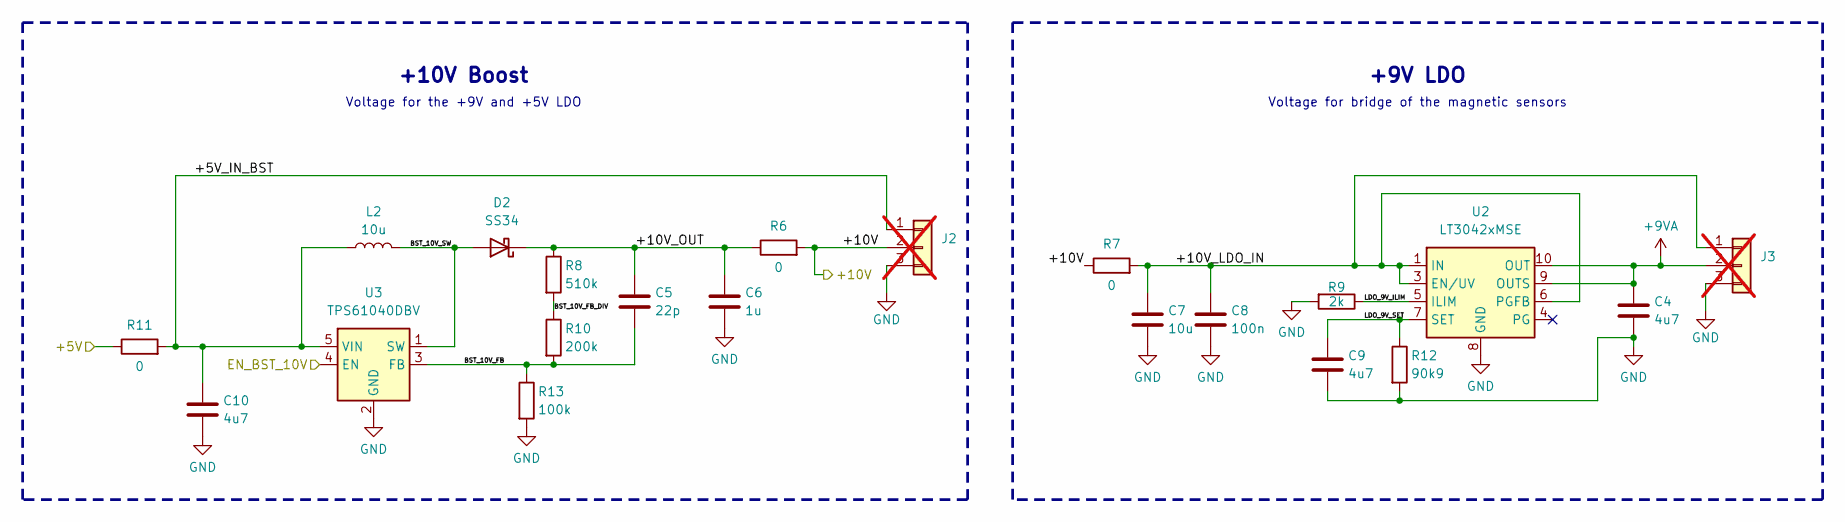
[picture p60: schematic pwr_9v_bridge.kicad_sch]

Parts:
C4, C9, C10: 4u7; C_1206_3216Metric; LCSC C29823
C5: 22p; C_0603_1608Metric; LCSC C1653
C6: 1u; C_0805_2012Metric; LCSC C28323
C7: 10u; C_0805_2012Metric; LCSC C15850
C8: 100n; C_0603_1608Metric; LCSC C14663
D2: SS34; D_SMA; LCSC C8678
J2, J3: Conn_01x03; PinHeader_1x03_P2.54mm_Vertical; not fitted
L2: 10u; L_Sunlord_MWSA0503S; LCSC C177248
R6, R7, R11: 0; R_1206_3216Metric; LCSC C17888
R8: 510k; R_0603_1608Metric; LCSC C23192
R9: 2k; R_0603_1608Metric; LCSC C22975
R10: 200k; R_0603_1608Metric; LCSC C25811
R12: 90k9; R_1206_3216Metric; LCSC C870933
R13: 100k; R_0603_1608Metric; LCSC C25803
U2: LT3042xMSE; MSOP-10-1EP_3x3mm_P0.5mm_EP1.68x1.88mm; LCSC C580009
U3: TPS61040DBV; SOT-23-5; LCSC C7722

Connections:
+5V: R11.1; also elsewhere on the board
+9VA: C4.1, J3.2, U2.9 (OUTS), U2.10 (OUT)
/MCU_ESP32S3/EN_BST_10V: U3.4 (EN); also elsewhere on the board
/PWR_9V_BRIDGE/+5V_IN_BST: C10.1, J2.1, L2.1, R11.2, U3.5 (VIN)
/PWR_9V_BRIDGE/+10V: J2.2, R6.2, R7.1; also elsewhere on the board
/PWR_9V_BRIDGE/+10V_LDO_IN: C7.1, C8.1, J3.1, R7.2, U2.1 (IN), U2.2 (IN), U2.3 (EN/UV), U2.6 (PGFB)
/PWR_9V_BRIDGE/+10V_OUT: C5.1, C6.1, D2.1 (K), R6.1, R8.1
/PWR_9V_BRIDGE/BST_10V_FB: C5.2, R10.2, R13.1, U3.3 (FB)
/PWR_9V_BRIDGE/BST_10V_FB_DIV: R8.2, R10.1
/PWR_9V_BRIDGE/BST_10V_SW: D2.2 (A), L2.2, U3.1 (SW)
/PWR_9V_BRIDGE/LDO_9V_ILIM: R9.1, U2.5 (ILIM)
/PWR_9V_BRIDGE/LDO_9V_SET: C9.1, R12.1, U2.7 (SET)
GND: C4.2, C6.2, C7.2, C8.2, C9.2, C10.2, J2.3, J3.3, R9.2, R12.2, R13.2, U2.8 (GND), U2.11 (GND), U3.2 (GND); also elsewhere on the board

Notes on the sheet:
Voltage for bridge of the magnetic sensors
+9V LDO
Voltage for the +9V and +5V LDO
+10V Boost

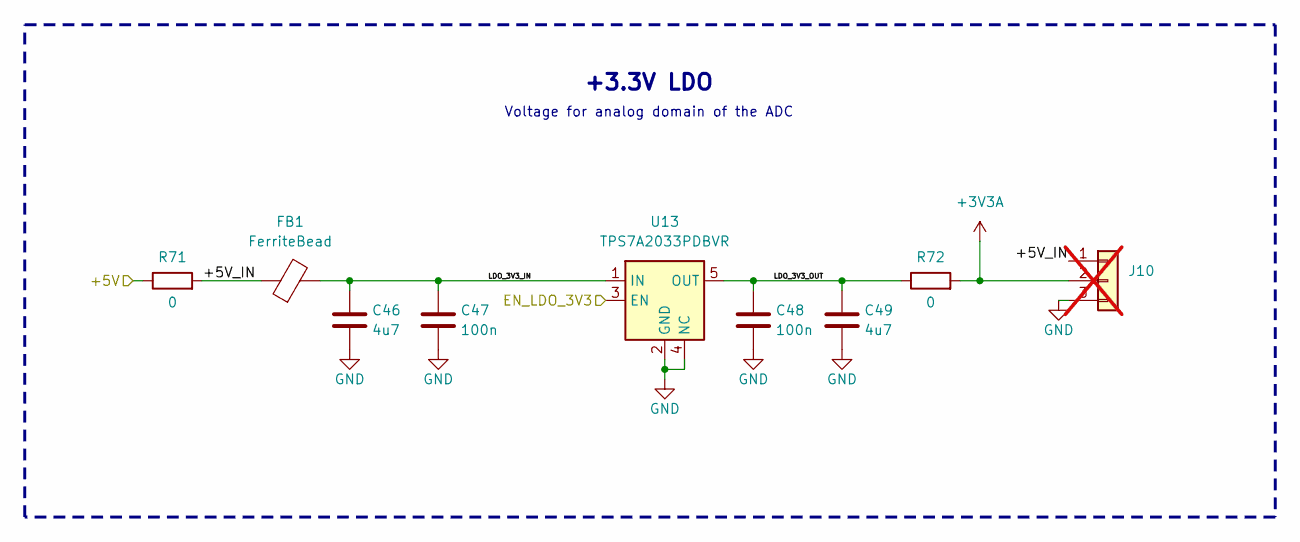
[picture p61: schematic pwr_3v3a.kicad_sch]

Parts:
C46, C49: 4u7; C_1206_3216Metric; LCSC C29823
C47, C48: 100n; C_0603_1608Metric; LCSC C14663
FB1: FerriteBead; L_0603_1608Metric; LCSC C14709
J10: Conn_01x03; PinHeader_1x03_P2.54mm_Vertical; not fitted
R71, R72: 0; R_1206_3216Metric; LCSC C17888
U13: TPS7A2033PDBVR; SOT-23-5; LCSC C2862740

Connections:
+3V3A: J10.2, R72.2
+5V: R71.1; also elsewhere on the board
/MCU_ESP32S3/EN_LDO_3V3: U13.3 (EN); also elsewhere on the board
/PWR_3V3A/+5V_IN: FB1.1, J10.1, R71.2
/PWR_3V3A/LDO_3V3_IN: C46.1, C47.1, FB1.2, U13.1 (IN)
/PWR_3V3A/LDO_3V3_OUT: C48.1, C49.1, R72.1, U13.5 (OUT)
GND: C46.2, C47.2, C48.2, C49.2, J10.3, U13.2 (GND), U13.4 (NC); also elsewhere on the board

Notes on the sheet:
+3.3V LDO
Voltage for analog domain of the ADC

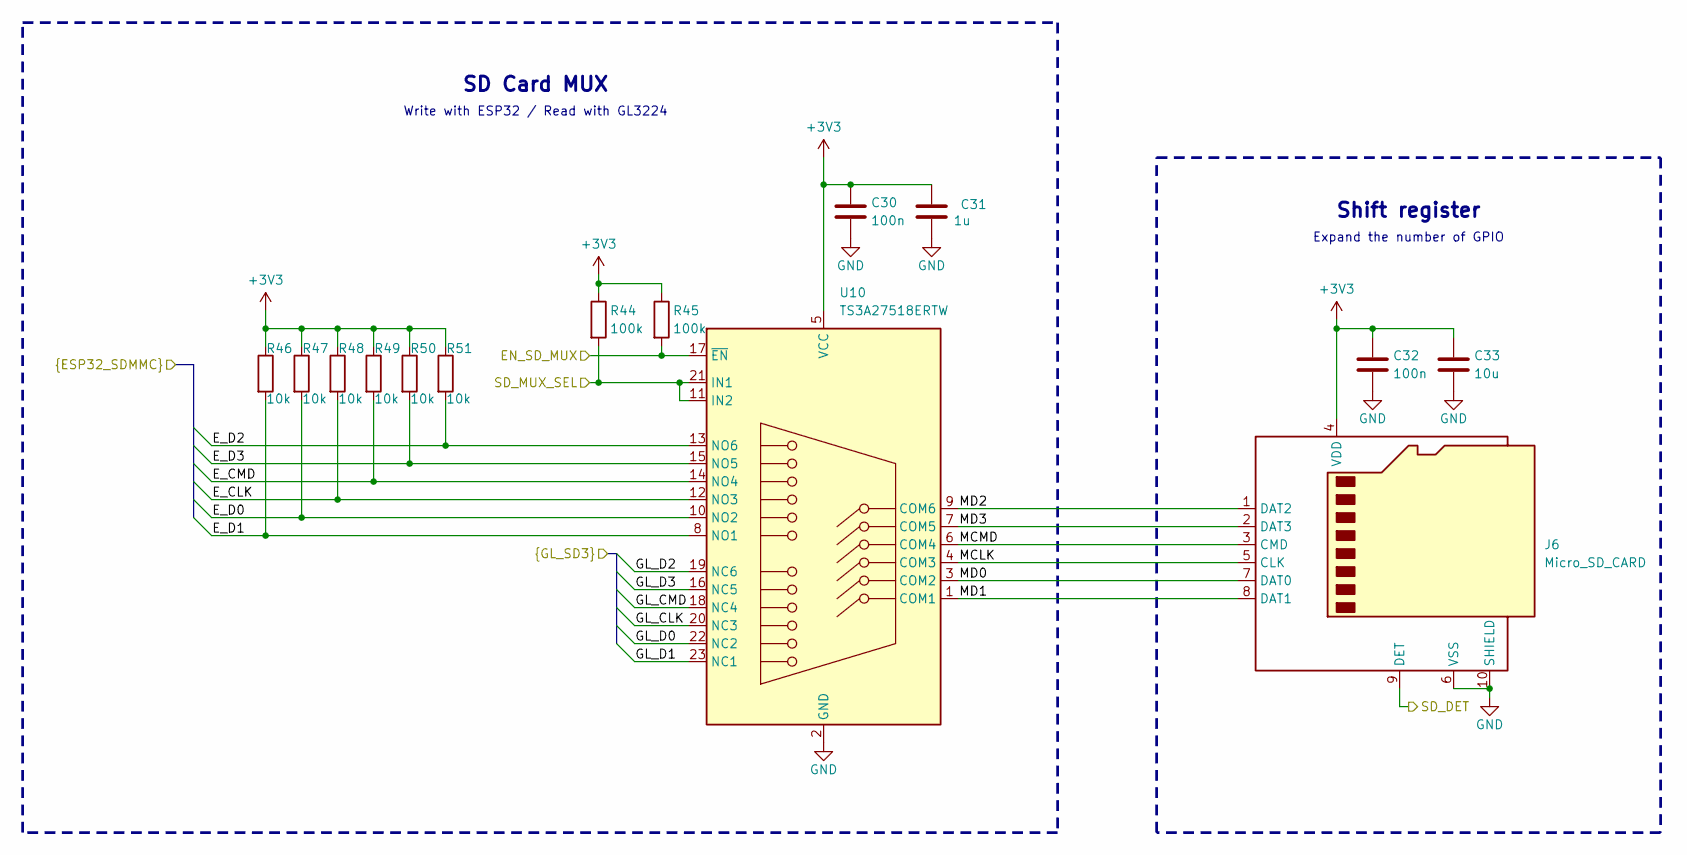
[picture p62: schematic MUX_AND_SD_MOMORY.kicad_sch]

Parts:
C30, C32: 100n; C_0603_1608Metric; LCSC C14663
C31: 1u; C_0805_2012Metric; LCSC C28323
C33: 10u; C_0805_2012Metric; LCSC C15850
J6: Micro_SD_CARD; CONN_503398-1892_MOL; LCSC C428492
R44, R45: 100k; R_0603_1608Metric; LCSC C25803
R46, R47, R48, R49, R50, R51: 10k; R_0603_1608Metric; LCSC C25804
U10: TS3A27518ERTW; TSSOP-24_4.4x7.8mm_P0.65mm; LCSC C2651937

Connections:
+3V3: C30.1, C31.2, C32.1, C33.1, J6.4 (VDD), R44.1, R45.1, R46.1, R47.1, R48.1, R49.1, R50.1, R51.1, U10.5 (VCC); also elsewhere on the board
/DATA_SAVING/EN_SD_MUX: R45.2, U10.17 (~EN); also elsewhere on the board
/DATA_SAVING/E_CLK: R48.2, U10.12 (NO3); also elsewhere on the board
/DATA_SAVING/E_CMD: R49.2, U10.14 (NO4); also elsewhere on the board
/DATA_SAVING/E_D0: R47.2, U10.10 (NO2); also elsewhere on the board
/DATA_SAVING/E_D1: R46.2, U10.8 (NO1); also elsewhere on the board
/DATA_SAVING/E_D2: R51.2, U10.13 (NO6); also elsewhere on the board
/DATA_SAVING/E_D3: R50.2, U10.15 (NO5); also elsewhere on the board
/DATA_SAVING/MUX_AND_SD_CARD/GL_CLK: U10.20 (NC3); also elsewhere on the board
/DATA_SAVING/MUX_AND_SD_CARD/GL_CMD: U10.18 (NC4); also elsewhere on the board
/DATA_SAVING/MUX_AND_SD_CARD/GL_D0: U10.22 (NC2); also elsewhere on the board
/DATA_SAVING/MUX_AND_SD_CARD/GL_D1: U10.23 (NC1); also elsewhere on the board
/DATA_SAVING/MUX_AND_SD_CARD/GL_D2: U10.19 (NC6); also elsewhere on the board
/DATA_SAVING/MUX_AND_SD_CARD/GL_D3: U10.16 (NC5); also elsewhere on the board
/DATA_SAVING/MUX_AND_SD_CARD/MCLK: J6.5 (CLK), U10.4 (COM3)
/DATA_SAVING/MUX_AND_SD_CARD/MCMD: J6.3 (CMD), U10.6 (COM4)
/DATA_SAVING/MUX_AND_SD_CARD/MD0: J6.7 (DAT0), U10.3 (COM2)
/DATA_SAVING/MUX_AND_SD_CARD/MD1: J6.8 (DAT1), U10.1 (COM1)
/DATA_SAVING/MUX_AND_SD_CARD/MD2: J6.1 (DAT2), U10.9 (COM6)
/DATA_SAVING/MUX_AND_SD_CARD/MD3: J6.2 (DAT3), U10.7 (COM5)
/DATA_SAVING/MUX_AND_SD_CARD/SD_DET: J6.9 (DET); also elsewhere on the board
/DATA_SAVING/SD_MUX_SEL: R44.2, U10.11 (IN2), U10.21 (IN1); also elsewhere on the board
GND: C30.2, C31.1, C32.2, C33.2, J6.6 (VSS), J6.10 (SHIELD), J6.11 (VSS), J6.12 (VSS), J6.13 (VSS), J6.14 (VSS), U10.2 (GND); also elsewhere on the board

Notes on the sheet:
Expand the number of GPIO
Write with ESP32 / Read with GL3224
Shift register
SD Card MUX

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
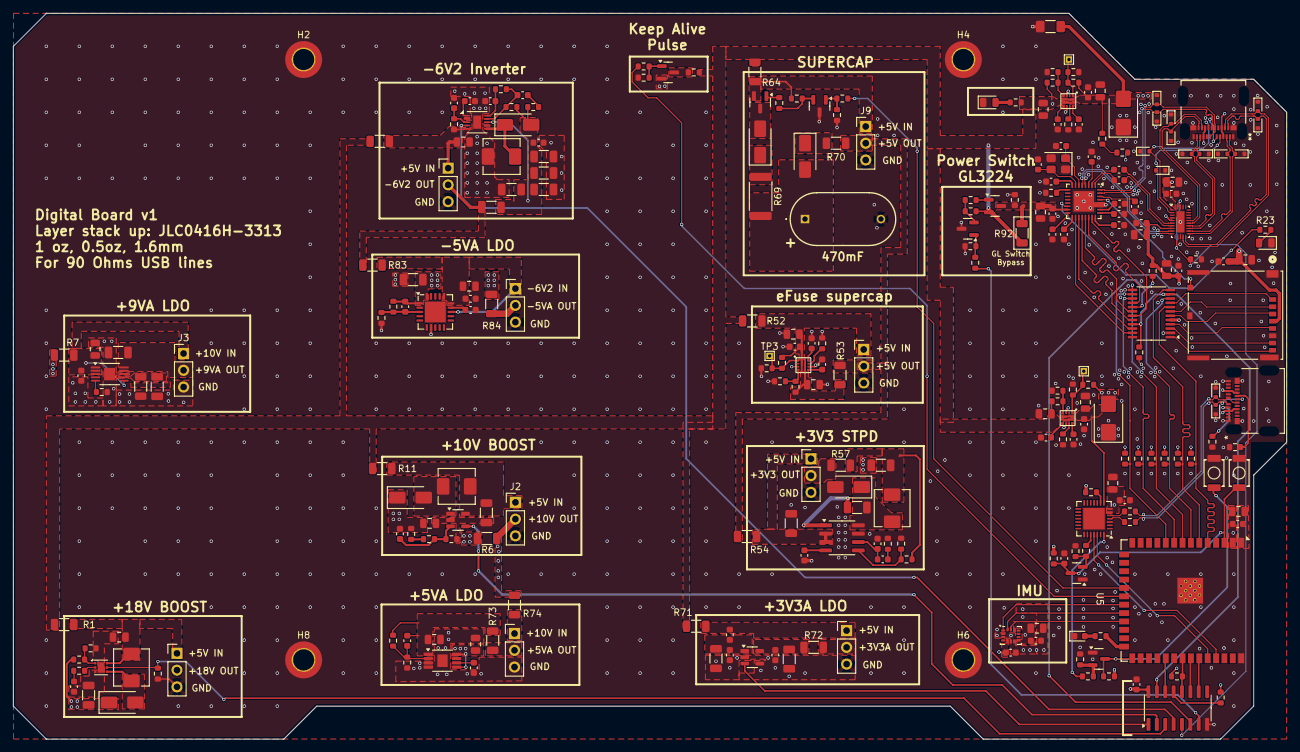
[picture p63: board Digital_test_board.kicad_pcb from above]

Board: 4 copper layers, 193.0 x 110.0 mm, 260 parts (0 on the bottom side), 172 nets.
