Benjamin-girard-1/magnetometer-node/hardware/pcb/GPS_TILE/GPS_TILE.kicad_pcb

## KiCad design hardware/pcb/GPS_TILE/GPS_TILE.kicad_pcb (2026-04-30)

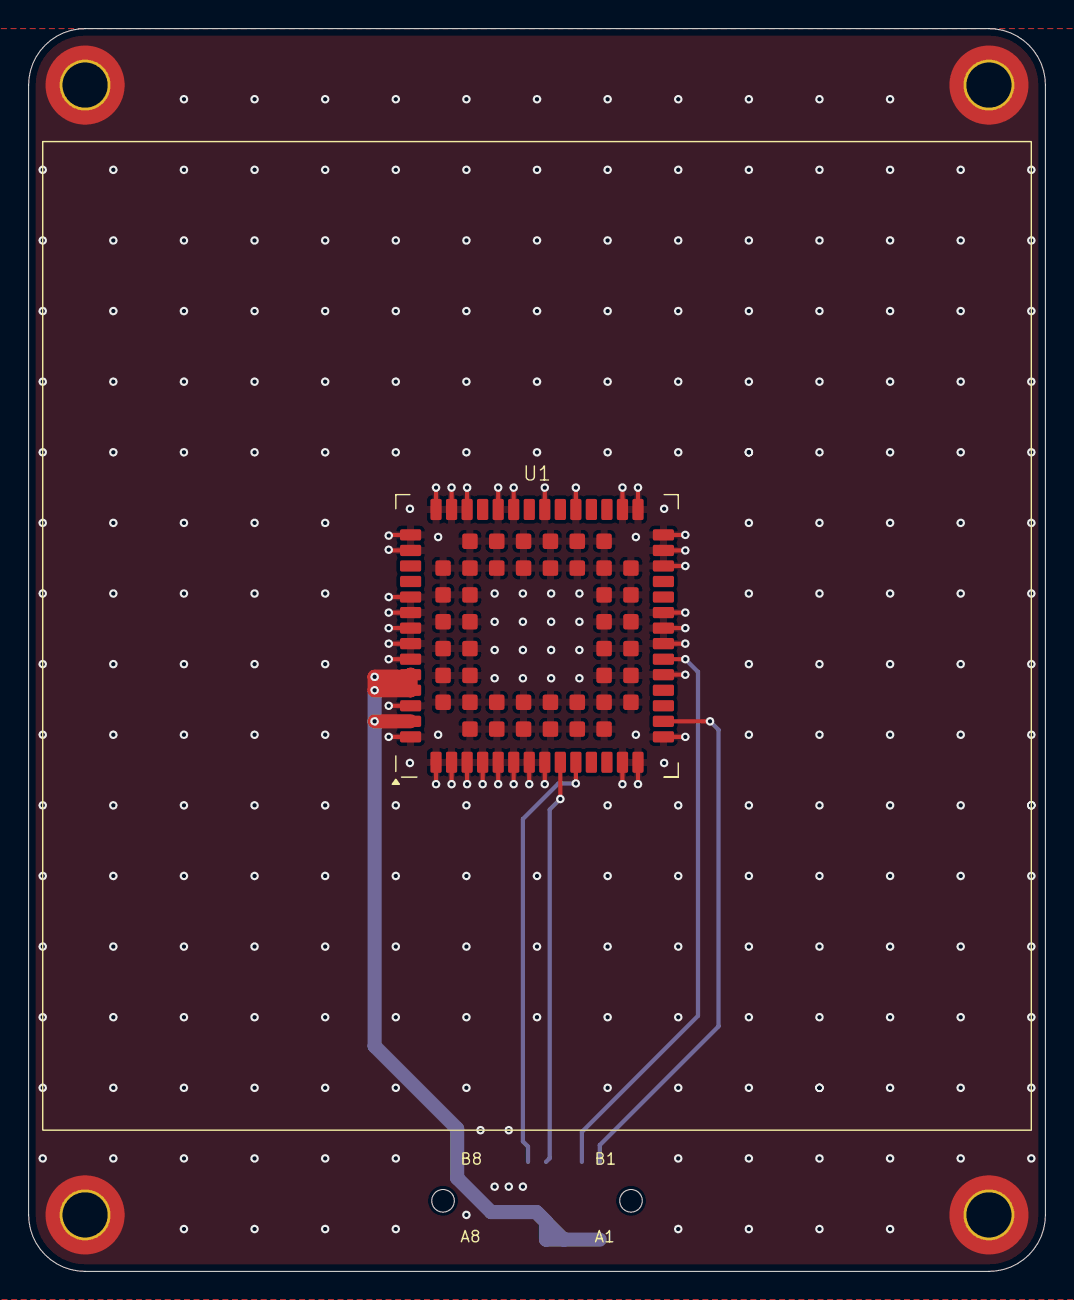
[picture p64: board GPS_TILE.kicad_pcb from above]

Board: 2 copper layers, 72.0 x 88.0 mm, 6 parts (1 on the bottom side), 6 nets.

Parts:
H1, H2, H3, H4: MountingHole_Pad; MountingHole_3.2mm_M3_DIN965_Pad_TopBottom
J1: 1374028; PHOENIX_1374028
U1: DAN-F10N; u-blox_DAN-F10N_LCC-56_20x20mm

Connections:
+3.3V: J1.A1, J1.A2, J1.A3, J1.A4, U1.52 (VCC), U1.53 (VCC), U1.55 (V_BCKP)
/GPS_NRESET: J1.B1, U1.16 (RESET_N)
/GPS_TIMEPULSE: J1.B2, U1.20 (TIMEPULSE)
/GPS_UART.RX: J1.B4, U1.9 (RXD)
/GPS_UART.TX: J1.B5, U1.10 (TXD)
GND: H1.1, H2.1, H3.1, H4.1, J1.A5, J1.A6, J1.A7, J1.A8, J1.B6, J1.B7, J1.B8, J1.MP1, J1.MP2, J1.MP3, J1.MP4, U1.1 (GND), U1.2 (GND), U1.3 (GND), U1.4 (GND), U1.5 (GND), U1.6 (GND), U1.7 (GND), U1.8 (GND), U1.13 (GND), U1.14 (GND), U1.15 (GND), U1.19 (GND), U1.21 (GND), U1.22 (GND), U1.23 (GND), U1.26 (GND), U1.27 (GND), U1.28 (GND), U1.29 (GND), U1.30 (GND), U1.33 (GND), U1.35 (GND), U1.37 (GND), U1.38 (GND), U1.40 (GND), U1.41 (GND), U1.42 (GND), U1.43 (GND), U1.44 (GND), U1.47 (GND), U1.48 (GND), U1.49 (GND), U1.50 (GND), U1.51 (GND), U1.54 (GND), U1.56 (GND), U1.EP
