Benjamin-girard-1/magnetometer-node/hardware/pcb/Expension_card_design/With_GL3224/Untitled/Untitled.kicad_pcb

## KiCad design hardware/pcb/Expension_card_design/With_GL3224/Untitled/Untitled.kicad_pcb (2026-04-30)

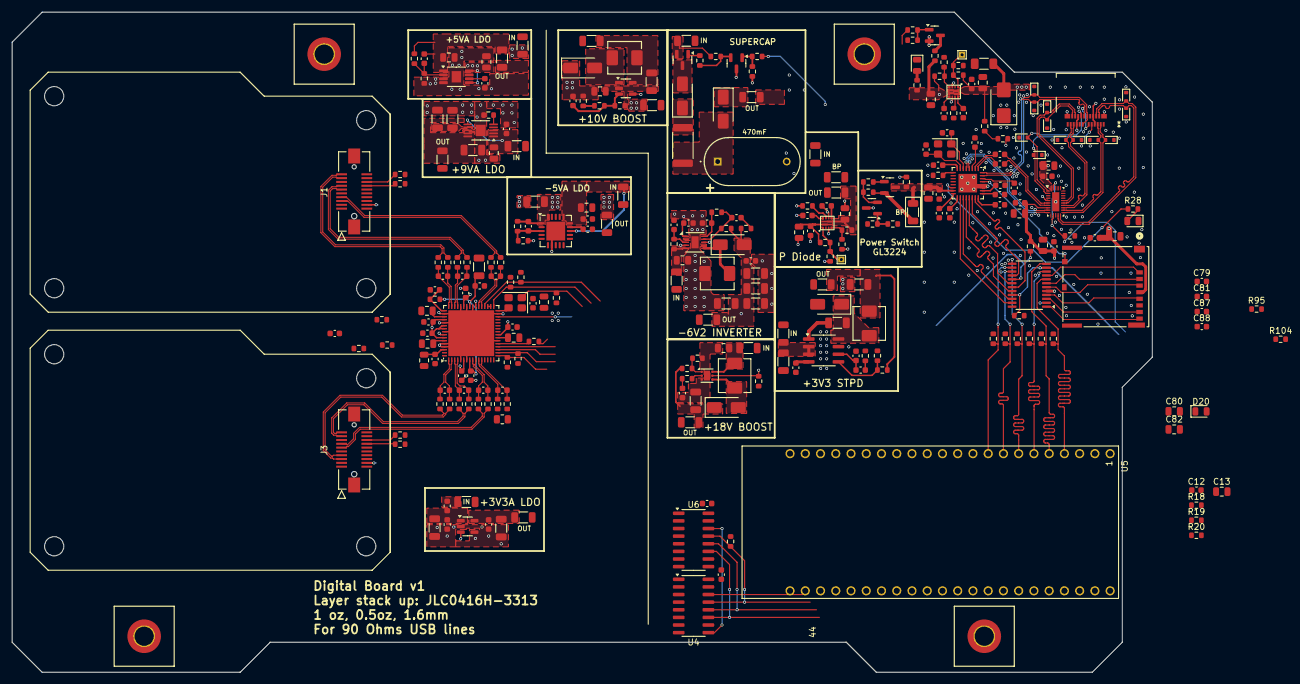
[picture p65: board hardware/pcb/Expension_card_design/With_GL3224/Untitled/Untitled.kica… from above]

Board: 4 copper layers, 190.0 x 110.0 mm, 282 parts (0 on the bottom side), 194 nets.

Parts:
C1, C7, C13, C17, C23, C34#2, C36, C51, C60, C62, C66, C72, C82: 10u; C_0805_2012Metric
C2, C6, C9, C10, C32#2, C35, C74, C75, C76, C77: 4u7; C_1206_3216Metric
C3, C18, C28, C29, C61, C63, C68, C73: 10n; C_0603_1608Metric
C4: 22p; C_0603_1608Metric
C5, C15, C20, C32, C57, C58, C59, C80, C83, C86, C91: 1u; C_0805_2012Metric
C8, C11, C12, C14, C16, C21, C31, C33, C33#2, C34, C37, C38, C39, C40, C41, C42, C43, C50, C53, C54, C56, C64, C67, C71, C79, C81, C84, C85, C87, C88, C92, C93, C94, C95, C96, C97, C98, C98#2, C99, C99#2, C100: 100n; C_0603_1608Metric
C19, C30, C44, C45, C47, C48, C49, C52: 1n; C_0603_1608Metric
C22, C24: 22u; C_1206_3216Metric
C25, C55, C69: 47u; C_1206_3216Metric
C26, C78: 4n7; C_0603_1608Metric
C27, C70: 10p; C_0603_1608Metric
C31#2: 470mF; C_Radial_D8.0mm_P11.50mm
C46, C65: 220n; C_0603_1608Metric
C89, C90: 18p; C_0603_1608Metric
D1, D2, D16, D17, D18, D19: SS34; D_SMA
D3: KT-0805G; LED_0805_2012Metric
D3#2: P6SMB6.8CA; D_SMB
D4, D5, D6, D7, D8, D9, D10, D11, D12, D13, D14, D15: H5VUD5BB; D_SOD-523
D5#2, D20: NCD0805R1; LED_0805_2012Metric
FB1: FerriteBead; L_0603_1608Metric
H1, H2, H3, H4: PCB_MountingHole; MountingHole_3.2mm_M3_DIN965_Pad_TopBottom
J1, J3: 550910274; Expansion_card
J2: USB_C_RECEPTACLE_MOLEX; CONN_201267-0005_MOL
J4: Micro_SD_CARD; CONN_503398-1892_MOL
L1, L2, L3, L4: 10u; L_Sunlord_MWSA0503S
Q1, Q3, Q5: AO3400A; SOT-23
Q2, Q4: AO3401A; SOT-23
R1, R2, R9, R10, R11, R15, R31, R32, R33, R34, R37, R44, R49, R51, R52#2, R80, R81, R84, R85, R90, R93, R112: 0; R_1206_3216Metric
R3: 49k9; R_0603_1608Metric
R4, R7, R8, R17, R23, R30, R36, R50, R52, R53, R54, R57, R71, R74, R76, R78, R86, R89, R92, R94, R95, R105, R111: 100k; R_0603_1608Metric
R5, R21, R25, R41, R59, R96, R97, R98, R99, R100, R101: 10k; R_0603_1608Metric
R6: 3k6; R_0603_1608Metric
R12, R91: 510k; R_0603_1608Metric
R13, R28, R56, R63, R66, R79, R104: 1k; R_0603_1608Metric
R14, R24, R38: 200k; R_0603_1608Metric
R16: 90k9; R_1206_3216Metric
R18, R19, R20, R58, R60, R61, R62, R64, R65, R67, R69, R70, R72, R73, R75, R77: 22; R_0603_1608Metric
R22, R35, R102, R103: 470k; R_0603_1608Metric
R25#2, R39, R45, R82, R107: 39k; R_0603_1608Metric
R26: R_1206_3216Metric_Pad1.30x1.75mm_HandSolder
R27, R43: 2k; R_0603_1608Metric
R28#2, R29, R46, R47, R108, R109: 100; R_0603_1608Metric
R40: 75k; R_0603_1608Metric
R42: 24k; R_0603_1608Metric
R48: 22; R_2512_6332Metric
R55: 300k; R_0603_1608Metric
R68: 2k4; R_0805_2012Metric
R83: 12k; R_0603_1608Metric
R87, R110: 330k; R_0603_1608Metric
R88: 10; R_0603_1608Metric
R106: 680; R_0603_1608Metric
TP1, TP2: TestPoint; TestPoint_THTPad_1.0x1.0mm_Drill0.5mm
U1: TPS61170; WSON-6-1EP_2x2mm_P0.65mm_EP1x1.6mm
U2: LT3042xMSE; MSOP-10-1EP_3x3mm_P0.5mm_EP1.68x1.88mm
U3: TPS61040DBV; SOT-23-5
U4, U6: 74HC595D,118; SOIC-16_3.9x9.9mm_P1.27mm
U5: ESP32-S3-DevKitC; MODULE_ESP32-S3-DEVKITC
U7, U8: TPS25210LRPWR; VQFN-HR-10
U9: TPS54331DR; SOIC-8_3.9x4.9mm_P1.27mm
U10: TPS7A2033PDBVR; SOT-23-5
U11: AD7779; QFN-64-1EP_9x9mm_P0.5mm_EP7.65x7.65mm
U12: TPS7A4901DGNR; HVSSOP-8-1EP_3x3mm_P0.65mm_EP1.57x1.89mm
U13: TPS7A3301RGWR; Texas_RGW0020A_VQFN-20-1EP_5x5mm_P0.65mm_EP3.15x3.15mm
U14: TPS63700DRCR; VSON-10-1EP_3x3mm_P0.5mm_EP1.2x2mm
U15: TS3A27518ERTW; TSSOP-24_4.4x7.8mm_P0.65mm
U16: GL3224-OIY04; QFN-32-1EP_5x5mm_P0.5mm_EP3.1x3.1mm
U17: HD3SS3220RNHR; Texas_RNH0030A_WQFN-30-1EP_2.5x4.5mm_P0.4mm_EP1.2x3.2mm
Y1: OT2JI-111-8.192M; Crystal_SMD_3225-4Pin_3.2x2.5mm
Y2: X322525MOB4SI; Crystal_SMD_3225-4Pin_3.2x2.5mm

Connections:
+1V65: J1.12, J3.12, U11.57 (VCM)
+3V3: C11.1, C12.1, C13.1, C14.1, C31.1, C32.2, C33.1, C34#2.1, C42.1, C50.1, C51.1, C79.1, C80.2, C81.1, C82.1, C83.2, C84.1, J4.4 (VDD), R21.1, R37.2, R52.1, R59.2, R76.1, R78.1, R94.1, R95.1, R96.1, R97.1, R98.1, R99.1, R100.1, R101.1, U4.16 (VCC), U5.1 (ESP_3V3), U5.2 (ESP_3V3), U6.16 (VCC), U7.3 (PG), U8.3 (PG), U11.24 (IOVDD), U15.5 (VCC), U17.8 (VCC33), Y1.4 (VDD)
+3V3A: C36.1, C37.1, C38.1, C39.1, C40.1, C41.1, J1.2, J3.2, R52#2.2, R63.1, U11.6 (AVDD1A), U11.43 (AVDD1B), U11.52 (AVDD2B), U11.54 (FORMAT1), U11.55 (FORMAT0), U11.58 (AVDD2A), U11.62 (AVDD4)
+5V: C17.1, C85.1, C86.2, Q4.2 (S), R1.1, R15.1, R23.1, R25.1, R28#2.1, R31.1, R32.1, R44.1, R51.1, R90.1, R107.1, R112.2, U7.6 (OUT), U17.30 (VDD5)
+5VA: J1.14, J3.14, R80.2
+9VA: J1.16, J3.16, R11.2, R55.1
+18V: J1.13, J3.13, R2.2
-5VA: J1.15, J3.15, R85.2
/ADC_AD777x/ADC_9VA_MON: C43.1, R55.2, R56.1, R57.1
/ADC_AD777x/ADC_9VA_MON_FLT: R56.2, U11.39 (AIN6+)
/ADC_AD777x/ADC_AREG1CAP: C58.1, U11.59 (AREG1CAP)
/ADC_AD777x/ADC_AREG2CAP: C59.1, U11.51 (AREG2CAP)
/ADC_AD777x/ADC_CONVST_SAR: R71.1, U6.4 (QE), U11.17 (CONVST_SAR)
/ADC_AD777x/ADC_CS: R18.1, R59.1, U11.18 (ALERT/~CS)
/ADC_AD777x/ADC_DREGCAP: C57.1, U11.23 (DREGCAP)
/ADC_AD777x/ADC_IN0+: C44.1, R58.2, U11.2 (AIN0+)
/ADC_AD777x/ADC_IN0-: C44.2, R60.2, U11.1 (AIN0-)
/ADC_AD777x/ADC_IN1+: C45.1, R61.2, U11.4 (AIN1+)
/ADC_AD777x/ADC_IN1-: C45.2, R64.2, U11.3 (AIN1-)
/ADC_AD777x/ADC_IN2+: C47.1, R65.2, U11.10 (AIN2+)
/ADC_AD777x/ADC_IN2-: C47.2, R67.2, U11.9 (AIN2-)
/ADC_AD777x/ADC_IN3+: C52.1, R75.2, U11.37 (AIN7+)
/ADC_AD777x/ADC_IN3-: C52.2, R77.2, U11.38 (AIN7-)
/ADC_AD777x/ADC_IN4+: C48.1, R69.2, U11.47 (AIN4+)
/ADC_AD777x/ADC_IN4-: C48.2, R70.2, U11.48 (AIN4-)
/ADC_AD777x/ADC_IN5+: C49.1, R72.2, U11.45 (AIN5+)
/ADC_AD777x/ADC_IN5-: C49.2, R73.2, U11.46 (AIN5-)
/ADC_AD777x/ADC_MCLK: U11.32 (XTAL2/MCLK), Y1.3 (OUT)
/ADC_AD777x/ADC_MCLK_EN: R78.2, U6.7 (QH), Y1.1 (Tri-State)
/ADC_AD777x/ADC_REF+: C53.1, C54.1, C55.1, R79.1, U11.8 (REF1+), U11.41 (REF2+)
/ADC_AD777x/ADC_REF_OUT: C56.1, R79.2, U11.49 (REF_OUT)
/ADC_AD777x/ADC_RESET: R76.2, U6.6 (QG), U11.36 (~RESET)
/ADC_AD777x/ADC_SCLK: R19.1, U11.19 (DCLK2/SCLK)
/ADC_AD777x/ADC_SDI: R20.1, U11.20 (DCLK1/SDI)
/ADC_AD777x/ADC_SDO_R: R62.1, U11.21 (DCLK0/SDO)
/ADC_AD777x/ADC_START: R74.1, U6.5 (QF), U11.33 (~START)
/ADC_AD777x/AIN0+: J3.3, R60.1
/ADC_AD777x/AIN0-: J3.4, R58.1
/ADC_AD777x/AIN1+: J3.7, R67.1
/ADC_AD777x/AIN1-: J3.6, R65.1
/ADC_AD777x/AIN2+: J3.10, R61.1
/ADC_AD777x/AIN2-: J3.9, R64.1
/ADC_AD777x/AIN3+: J1.4, R75.1
/ADC_AD777x/AIN3-: J1.3, R77.1
/ADC_AD777x/AIN4+: J1.7, R73.1
/ADC_AD777x/AIN4-: J1.6, R72.1
/ADC_AD777x/AIN5+: J1.9, R69.1
/ADC_AD777x/AIN5-: J1.10, R70.1
/ADC_AD777x/PT1000_AIN+: C46.1, R63.2, U11.12 (AIN3+)
/ADC_AD777x/PT1000_AIN-: C46.2, R66.2, U11.11 (AIN3-)
/ADC_AD777x/PT1000_DRAIN: R66.1, R68.2
/DATA_SAVING/+5VBUS_DATA: C15.1, C16.1, D3#2.2 (A2), J2.A4 (VBUS), J2.A9 (VBUS), J2.B4 (VBUS), J2.B9 (VBUS), R22.1, R26.2, R102.1, U7.5 (IN)
/DATA_SAVING/AVDD12: C99#2.1, U16.3 (AVDD12)
/DATA_SAVING/AVDD33: C98#2.1, U16.30 (AVDD33)
/DATA_SAVING/AVDD33_: C97.1, U16.8 (AVDD33)
/DATA_SAVING/CC1: D5.2, J2.A5 (CC1), U17.2 (CC1)
/DATA_SAVING/CC2: D4.2, J2.B5 (CC2), U17.1 (CC2)
/DATA_SAVING/DATA_D+: D15.2, J2.A6 (D+), J2.B6 (D+), U16.32 (DP)
/DATA_SAVING/DATA_D-: D14.2, J2.A7 (D-), J2.B7 (D-), U16.31 (DM)
/DATA_SAVING/DVDD12: C100.1, U16.17 (DVDD12)
/DATA_SAVING/DVDD33: C94.1, U16.25 (DVDD33)
/DATA_SAVING/DVDD33_: C93.1, U16.16 (DVDD33)
/DATA_SAVING/EN_SD_MUX: R52.2, R95.2, U4.6 (QG), U15.17 (~EN)
/DATA_SAVING/EN_USB_MUX: R105.1, U4.5 (QF), U17.12 (ENn_MUX), U17.29 (ENn_CC)
/DATA_SAVING/EN_USB_READ: R109.2, U4.7 (QH)
/DATA_SAVING/EN_USB_READ_G: Q5.1 (G), R109.1, R111.1
/DATA_SAVING/E_CLK: R98.2, U5.5 (GPIO5), U15.12 (NO3)
/DATA_SAVING/E_CMD: R99.2, U5.9 (GPIO16), U15.14 (NO4)
/DATA_SAVING/E_D0: R97.2, U5.6 (GPIO5), U15.10 (NO2)
/DATA_SAVING/E_D1: R96.2, U5.4 (GPIO4), U15.8 (NO1)
/DATA_SAVING/E_D2: R101.2, U5.7 (GPIO7), U15.13 (NO6)
/DATA_SAVING/E_D3: R100.2, U5.8 (GPIO15), U15.15 (NO5)
/DATA_SAVING/GL3224_X1: C89.1, U16.6 (X1), Y2.1
/DATA_SAVING/GL3224_X2: C90.1, U16.7 (X2), Y2.3
/DATA_SAVING/GL_CLK: U15.20 (NC3), U16.20 (SD_CK)
/DATA_SAVING/GL_CMD: U15.18 (NC4), U16.21 (SD_CM)
/DATA_SAVING/GL_D0: U15.22 (NC2), U16.19 (SD_D0)
/DATA_SAVING/GL_D1: U15.23 (NC1), U16.18 (SD_D1)
/DATA_SAVING/GL_D2: U15.19 (NC6), U16.23 (SD_D2)
/DATA_SAVING/GL_D3: U15.16 (NC5), U16.22 (SD_D3)
/DATA_SAVING/LED: R104.1, U16.14 (LED)
/DATA_SAVING/MCLK: J4.5 (CLK), U15.4 (COM3)
/DATA_SAVING/MCMD: J4.3 (CMD), U15.6 (COM4)
/DATA_SAVING/MD0: J4.7 (DAT0), U15.3 (COM2)
/DATA_SAVING/MD1: J4.8 (DAT1), U15.1 (COM1)
/DATA_SAVING/MD2: J4.1 (DAT2), U15.9 (COM6)
/DATA_SAVING/MD3: J4.2 (DAT3), U15.7 (COM5)
/DATA_SAVING/RTERM: R106.2, U16.9 (RTERM)
/DATA_SAVING/RX1+: D9.2, J2.B11 (RX1+), U17.15 (RX1p)
/DATA_SAVING/RX1-: D8.2, J2.B10 (RX1-), U17.14 (RX1n)
/DATA_SAVING/RX2+: D7.2, J2.A10 (RX2-), U17.18 (RX2p)
/DATA_SAVING/RX2-: D6.2, J2.A11 (RX2+), U17.19 (RX2n)
/DATA_SAVING/SD_MUX_SEL: R94.2, U4.15 (QA), U15.11 (IN2), U15.21 (IN1)
/DATA_SAVING/SD_VCC: C96.1, U16.26 (SD_VCC)
/DATA_SAVING/TX1+: D12.2, J2.A3 (TX1-), U17.17 (TX1p)
/DATA_SAVING/TX1-: D13.2, J2.A2 (TX1+), U17.16 (TX1n)
/DATA_SAVING/TX2+: D10.2, J2.B3 (TX2-), U17.21 (TX2p)
/DATA_SAVING/TX2-: D11.2, J2.B2 (TX2+), U17.20 (TX2n)
/DATA_SAVING/USB_GL_TX+: C87.2, C98.2, U16.2 (TXP)
/DATA_SAVING/USB_GL_TX-: C88.2, C99.2, U16.1 (TXN)
/DATA_SAVING/USB_HD_TX+: C87.1, C98.1, U17.6 (TXp)
/DATA_SAVING/USB_HD_TX-: C88.1, C99.1, U17.7 (TXn)
/DATA_SAVING/USB_RX+: U16.5 (RXP), U17.9 (RXp)
/DATA_SAVING/USB_RX-: U16.4 (RXN), U17.10 (RXn)
/DATA_SAVING/USB_SW_GATE: Q4.1 (G), R108.2
/DATA_SAVING/USB_SW_GDRV: Q5.2 (S), R107.2, R108.1
/DATA_SAVING/VBUS_USB_SW: C91.2, C92.1, Q4.3 (D), R110.2, R112.1, U16.15 (VBUS)
/DATA_SAVING/VUHSI: C95.1, U16.24 (VUHSI)
/IO_CONNECTOR/5VDAT_EFUSE_DVDT: C19.1, U7.7 (dV/dt)
/IO_CONNECTOR/5VDAT_EFUSE_EN_ULVO: R22.2, R24.1, TP1.1, U7.1 (EN/ULVO)
/IO_CONNECTOR/5VDAT_EFUSE_ILM: R27.1, U7.9 (ILM)
/IO_CONNECTOR/5VDAT_EFUSE_ITIMER: C18.1, U7.10 (ITIMER)
/IO_CONNECTOR/5VDAT_EFUSE_PGTH: R23.2, R25#2.1, U7.4 (PGTH)
/IO_CONNECTOR/EN_KEEPALIVE_GATE: Q1.1 (G), R29.2, R30.1
/IO_CONNECTOR/KEEPALIVE_DRAIN: Q1.3 (D), R28#2.2
/MCU_ESP32S3/EN_BST_10V: U3.4 (EN), U4.2 (QC)
/MCU_ESP32S3/EN_BST_18V: R4.1, U1.5 (CTRL), U4.3 (QD)
/MCU_ESP32S3/EN_INV_-5V: U4.4 (QE), U14.4 (EN)
/MCU_ESP32S3/EN_LDO_3V3: U4.1 (QB), U10.3 (EN)
/MCU_ESP32S3/SR_CHAIN_DATA: U4.9 (QH'), U6.14 (SER)
/MCU_ESP32S3/SR_LATCH: U4.12 (RCLK), U6.12 (RCLK)
/MCU_ESP32S3/SR_OE_N: R21.2, U4.13 (~OE), U6.13 (~OE)
/MCU_ESP32S3/SR_SHIFT_CLK: U4.11 (SRCLK), U6.11 (SRCLK)
/PWR_3V3A/+5V_IN: FB1.1, R51.2
/PWR_3V3A/LDO_3V3_IN: C32#2.1, C33#2.1, FB1.2, U10.1 (IN)
/PWR_3V3A/LDO_3V3_OUT: C34.1, C35.1, R52#2.1, U10.5 (OUT)
/PWR_3V3D/3V3D_EFUSE_DVDT: C30.1, U8.7 (dV/dt)
/PWR_3V3D/3V3D_EFUSE_EN_ULVO: R35.2, R38.1, TP2.1, U8.1 (EN/ULVO)
/PWR_3V3D/3V3D_EFUSE_ILM: R43.1, U8.9 (ILM)
/PWR_3V3D/3V3D_EFUSE_ITIMER: C29.1, U8.10 (ITIMER)
/PWR_3V3D/3V3D_EFUSE_PGTH: R36.2, R39.1, U8.4 (PGTH)
/PWR_3V3D/5V_HOLDUP_CAP: R31.2, R33.2, R34.1, R49.2
/PWR_3V3D/5V_HOLDUP_DIODE: C23.1, R33.1, R36.1, U8.6 (OUT)
/PWR_3V3D/5V_HOLDUP_IN: C24.1, R34.2, U9.2 (VIN), U9.3 (EN)
/PWR_3V3D/5V_SUPERCAP: C31#2.1, D18.2 (A), R48.2
/PWR_3V3D/+3V3_OUT: C25.1, L3.2, R37.1, R40.1
/PWR_3V3D/+5V_IN: C20.1, C21.1, R32.2, R35.1, U8.5 (IN)
/PWR_3V3D/+5V_SUPERCAP_IN: Q2.2 (S), R44.2, R45.1
/PWR_3V3D/STPD_3V3_BOOT: C22.1, U9.1 (BOOT)
/PWR_3V3D/STPD_3V3_COMP: C26.1, C27.1, U9.6 (COMP)
/PWR_3V3D/STPD_3V3_COMP_F: C26.2, R41.1
/PWR_3V3D/STPD_3V3_PH: C22.2, D16.1 (K), L3.1, U9.8 (PH)
/PWR_3V3D/STPD_3V3_SS: C28.1, U9.4 (SS)
/PWR_3V3D/STPD_3V3_VSENS: R40.2, R42.1, U9.5 (VSENSE)
/PWR_5VA_NEG5/+5VA_OUT: C61.1, C62.1, R80.1, R82.1, U12.1 (OUT)
/PWR_5VA_NEG5/+5V_IN_N5V: C72.1, R88.2, R90.2, U14.5 (IN)
/PWR_5VA_NEG5/+10V_IN_LDO: C60.1, R81.2, U12.5 (EN), U12.8 (IN)
/PWR_5VA_NEG5/INV_N5V5_COMP: C78.1, U14.1 (COMP)
/PWR_5VA_NEG5/INV_N5V5_FB: C70.1, R86.2, R91.1, U14.9 (FB)
/PWR_5VA_NEG5/INV_N5V5_FF: C70.2, R92.1
/PWR_5VA_NEG5/INV_N5V5_SW: D19.1 (K), L4.1, U14.6 (SW)
/PWR_5VA_NEG5/INV_N5V5_VIN: C64.1, R88.1, U14.3 (VIN)
/PWR_5VA_NEG5/INV_N5V5_VREF: C65.1, R86.1, U14.10 (VREF)
/PWR_5VA_NEG5/LDO_N5V_FB: C68.2, R87.2, R89.1, U13.3 (FB)
/PWR_5VA_NEG5/LDO_N5V_NR: C71.1, U13.14 (NR/SS)
/PWR_5VA_NEG5/LDO_P5V_FB: C61.2, R82.2, R83.1, U12.2 (FB)
/PWR_5VA_NEG5/LDO_P5V_NR: C63.1, U12.6 (NR/SS)
/PWR_5VA_NEG5/N5V: R84.1, R93.2
/PWR_5VA_NEG5/N5V5_PRE_N5VA: C73.1, C74.1, C75.1, C76.1, C77.1, D19.2 (A), R91.2, R92.2, R93.1, U14.8 (OUT)
/PWR_5VA_NEG5/N5V_VIN_LDO: C66.1, C67.1, R84.2, U13.13 (EN), U13.15 (IN), U13.16 (IN)
/PWR_5VA_NEG5/N5V_VOUT_LDO: C68.1, C69.1, R85.1, R87.1, U13.1 (OUT), U13.20 (OUT)
/PWR_9V_BRIDGE/+5V_IN_BST: C10.1, L2.1, R15.2, U3.5 (VIN)
/PWR_9V_BRIDGE/+9V_LDO_OUT: C6.1, R11.1, U2.9 (OUTS), U2.10 (OUT)
/PWR_9V_BRIDGE/+10V: R9.2, R10.1, R81.1
/PWR_9V_BRIDGE/+10V_LDO_IN: C7.1, C8.1, R10.2, U2.1 (IN), U2.2 (IN), U2.3 (EN/UV), U2.6 (PGFB)
/PWR_9V_BRIDGE/+10V_OUT: C4.1, C5.1, D2.1 (K), R9.1, R12.1
/PWR_9V_BRIDGE/BST_10V_FB: C4.2, R14.2, R17.1, U3.3 (FB)
/PWR_9V_BRIDGE/BST_10V_FB_DIV: R12.2, R14.1
/PWR_9V_BRIDGE/BST_10V_SW: D2.2 (A), L2.2, U3.1 (SW)
/PWR_9V_BRIDGE/LDO_9V_ILIM: R13.2, U2.5 (ILIM)
/PWR_9V_BRIDGE/LDO_9V_SET: C9.1, R16.1, U2.7 (SET)
/RESET_1: J3.18, R53.1, U6.2 (QC)
/RESET_2: J1.18, R7.1, U6.15 (QA)
/SENSOR_SET_RESET_DRIVER/+18V_OUT: C2.1, D1.1 (K), R2.1, R3.1
/SENSOR_SET_RESET_DRIVER/BST_18V_COMP: R5.1, U1.2 (COMP)
/SENSOR_SET_RESET_DRIVER/BST_18V_COMP_FILT: C3.1, R5.2
/SENSOR_SET_RESET_DRIVER/BST_18V_FB: R3.2, R6.1, U1.1 (FB)
/SENSOR_SET_RESET_DRIVER/BST_18V_IN: C1.1, L1.1, R1.2, U1.6 (VIN)
/SENSOR_SET_RESET_DRIVER/BST_18V_SW: D1.2 (A), L1.2, U1.4 (SW)
/SET_1: J3.17, R54.1, U6.3 (QD)
/SET_2: J1.17, R8.1, U6.1 (QB)
GND: C1.2, C2.2, C3.2, C5.2, C6.2, C7.2, C8.2, C9.2, C10.2, C11.2, C12.2, C13.2, C14.2, C15.2, C16.2, C17.2, C18.2, C19.2, C20.2, C21.2, C23.2, C24.2, C25.2, C27.2, C28.2, C29.2, C30.2, C31.2, C31#2.2, C32.1, C32#2.2, C33.2, C33#2.2, C34.2, C34#2.2, C35.2, C36.2, C37.2, C38.2, C39.2, C40.2, C41.2, C42.2, C43.2, C50.2, C51.2, C53.2, C54.2, C55.2, C56.2, C57.2, C58.2, C59.2, C60.2, C62.2, C63.2, C64.2, C65.2, C66.2, C67.2, C69.2, C71.2, C72.2, C73.2, C74.2, C75.2, C76.2, C77.2, C78.2, C79.2, C80.1, C81.2, C82.2, C83.1, C84.2, C85.2, C86.1, C89.2, C90.2, C91.1, C92.2, C93.2, C94.2, C95.2, C96.2, C97.2, C98#2.2, C99#2.2, C100.2, D3.1 (K), D3#2.1 (A1), D4.1, D5.1, D5#2.1 (K), D6.1, D7.1, D8.1, D9.1, D10.1, D11.1, D12.1, D13.1, D14.1, D15.1, D16.2 (A), D20.1 (K), H1.1, H2.1, H3.1, H4.1, J1.5, J1.8, J1.11, J1.P1, J1.P2, J2.A1 (GND), J2.A12 (GND), J2.B1 (GND), J2.B12 (GND), J3.5, J3.8, J3.11, J3.P1, J3.P2, J4.6 (VSS), J4.10 (SHIELD), J4.11 (VSS), J4.12 (VSS), J4.13 (VSS), J4.14 (VSS), L4.2, Q1.2 (S), Q3.3 (D), Q5.3 (D), R4.2, R6.2, R7.2, R8.2, R13.1, R16.2, R17.2, R24.2, R25#2.2, R26.1, R27.2, R30.2, R38.2, R39.2, R41.2, R42.2, R43.2, R50.2, R53.2, R54.2, R57.2, R68.1, R71.2, R74.2, R83.2, R89.2, R105.2, R106.1, R110.1, R111.2, U1.3 (GND), U1.7 (TP), U2.8 (GND), U2.11 (GND), U3.2 (GND), U4.8 (GND), U5.22 (GND), U5.23 (GND), U5.43 (GND), U5.44 (GND), U6.8 (GND), U7.8 (GND), U8.8 (GND), U9.7 (GND), U10.2 (GND), U10.4 (NC), U11.5 (AVSS1A), U11.7 (REF1-), U11.22 (DGND), U11.31 (XTAL1), U11.40 (AIN6-), U11.42 (REF2-), U11.44 (AVSS1B), U11.50 (AVSS2B), U11.53 (AVSS3), U11.56 (CLK_SEL), U11.60 (AVSS2A), U11.61 (AVSS4), U11.65 (EPAD(AVSSx)), U12.3 (NC), U12.4 (GND), U12.9 (PwPd), U13.7 (GND), U13.21 (EP), U14.2 (GND), U14.7 (PSGND), U14.11 (PowerPAD), U15.2 (GND), U16.27 (GND), U16.28 (SD_WP), U16.33 (GND), U17.4 (PORT), U17.13 (GND), U17.28 (GND), U17.31 (GND), Y1.2 (GND), Y2.2, Y2.4
unnamed: D3.2 (A), R25.2
unnamed: D5#2.2 (A), R28.2
unnamed: D17.2 (A), Q2.3 (D)
unnamed: D17.1 (K), R48.1
unnamed: D18.1 (K), R49.1
unnamed: D20.2 (A), R104.2
unnamed: Q2.1 (G), R46.2
unnamed: Q3.1 (G), R47.1, R50.1
unnamed: Q3.2 (S), R45.2, R46.1
unnamed: R102.2, R103.1
unnamed: U11.34 (~SYNC_OUT), U11.35 (~SYNC_IN)
unnamed: R103.2, U17.5 (VBUS_DET)
