Benjamin-girard-1/magnetometer-node/hardware/pcb/DAN_F10N_testboard/DAN_F10N_testboard.kicad_pcb

## KiCad design hardware/pcb/DAN_F10N_testboard/DAN_F10N_testboard.kicad_pcb (2026-01-07)

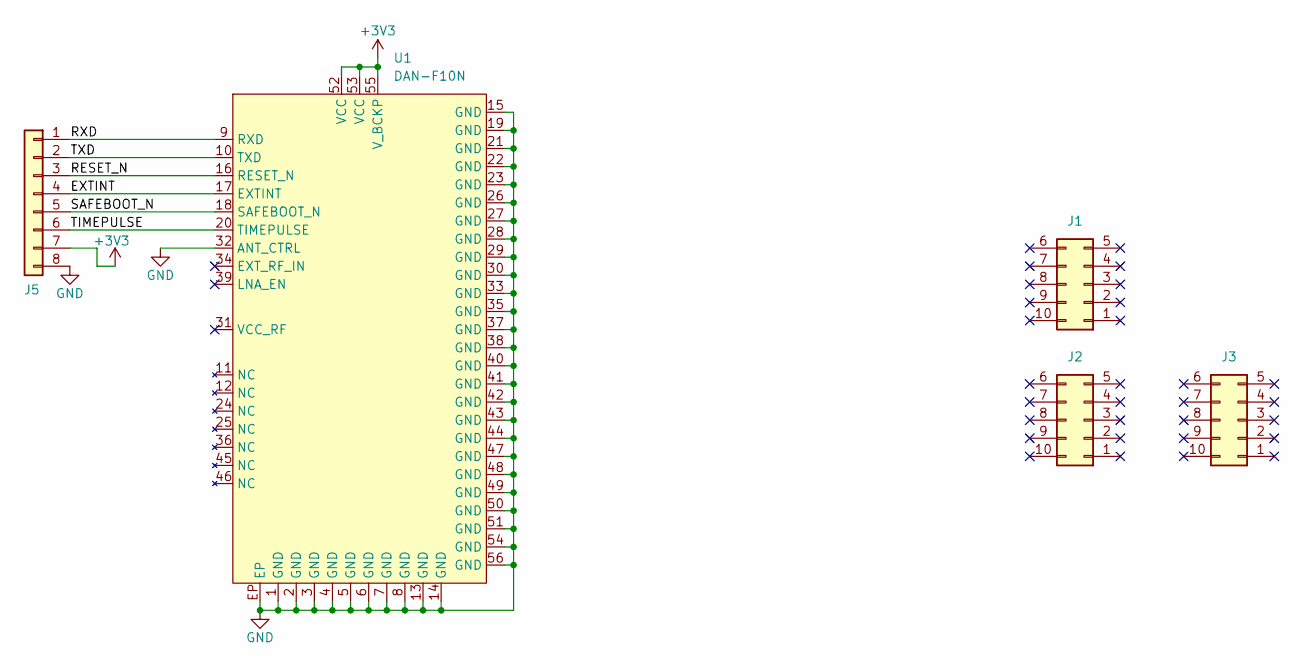
[picture p66: schematic DAN_F10N_testboard.kicad_sch]

Parts:
J1, J2, J3: Conn_02x05_Counter_Clockwise; PinHeader_2x05_P2.54mm_Vertical
J5: Conn_01x08; PinHeader_1x08_P2.54mm_Vertical
U1: DAN-F10N; u-blox_DAN-F10N_LCC-56_20x20mm

Connections:
+3V3: J5.7, U1.52 (VCC), U1.53 (VCC), U1.55 (V_BCKP)
/EXTINT: J5.4, U1.17 (EXTINT)
/RESET_N: J5.3, U1.16 (RESET_N)
/RXD: J5.1, U1.9 (RXD)
/SAFEBOOT_N: J5.5, U1.18 (SAFEBOOT_N)
/TIMEPULSE: J5.6, U1.20 (TIMEPULSE)
/TXD: J5.2, U1.10 (TXD)
GND: J5.8, U1.1 (GND), U1.2 (GND), U1.3 (GND), U1.4 (GND), U1.5 (GND), U1.6 (GND), U1.7 (GND), U1.8 (GND), U1.13 (GND), U1.14 (GND), U1.15 (GND), U1.19 (GND), U1.21 (GND), U1.22 (GND), U1.23 (GND), U1.26 (GND), U1.27 (GND), U1.28 (GND), U1.29 (GND), U1.30 (GND), U1.32 (ANT_CTRL), U1.33 (GND), U1.35 (GND), U1.37 (GND), U1.38 (GND), U1.40 (GND), U1.41 (GND), U1.42 (GND), U1.43 (GND), U1.44 (GND), U1.47 (GND), U1.48 (GND), U1.49 (GND), U1.50 (GND), U1.51 (GND), U1.54 (GND), U1.56 (GND), U1.EP

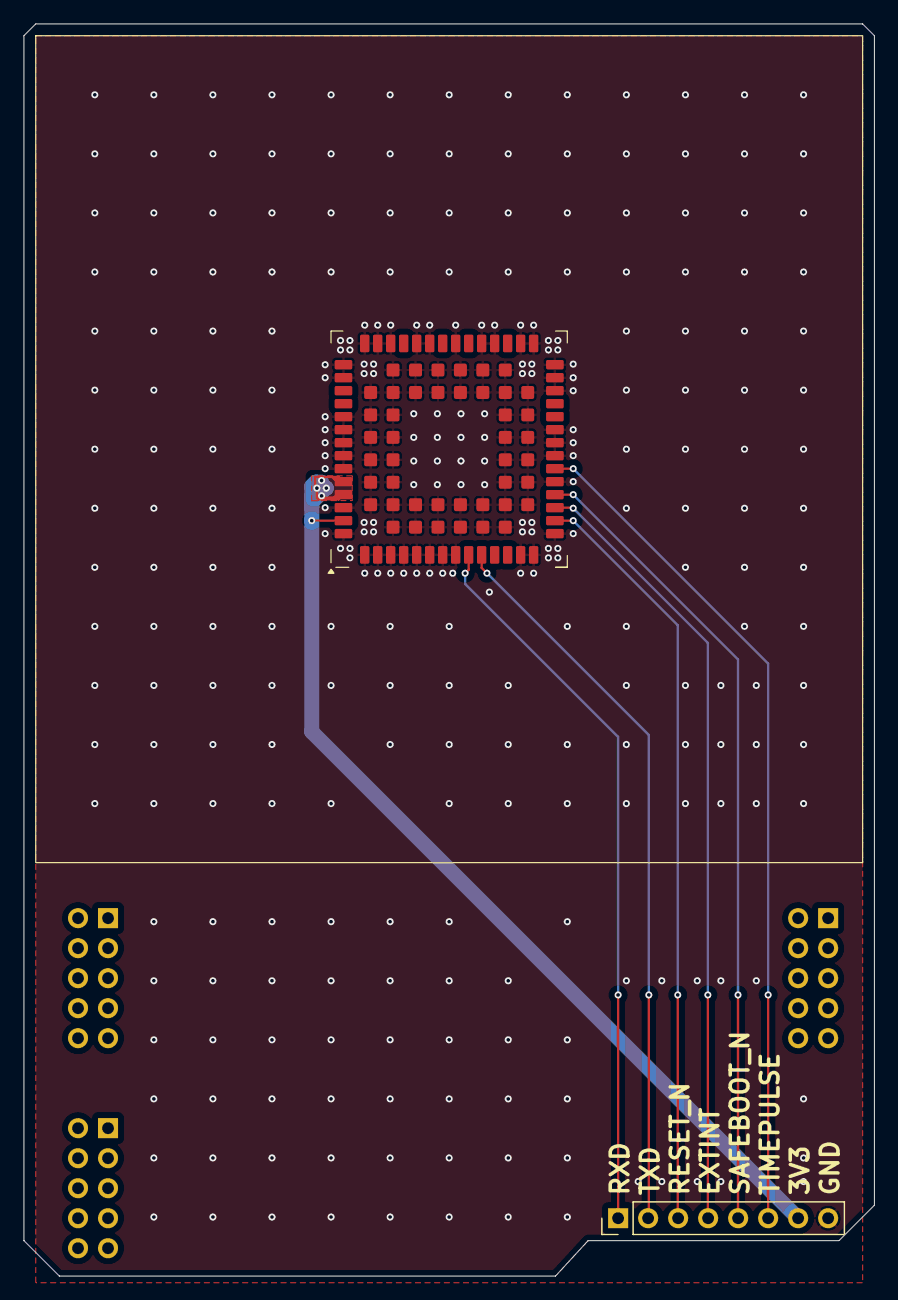
[picture p67: board DAN_F10N_testboard.kicad_pcb from above]

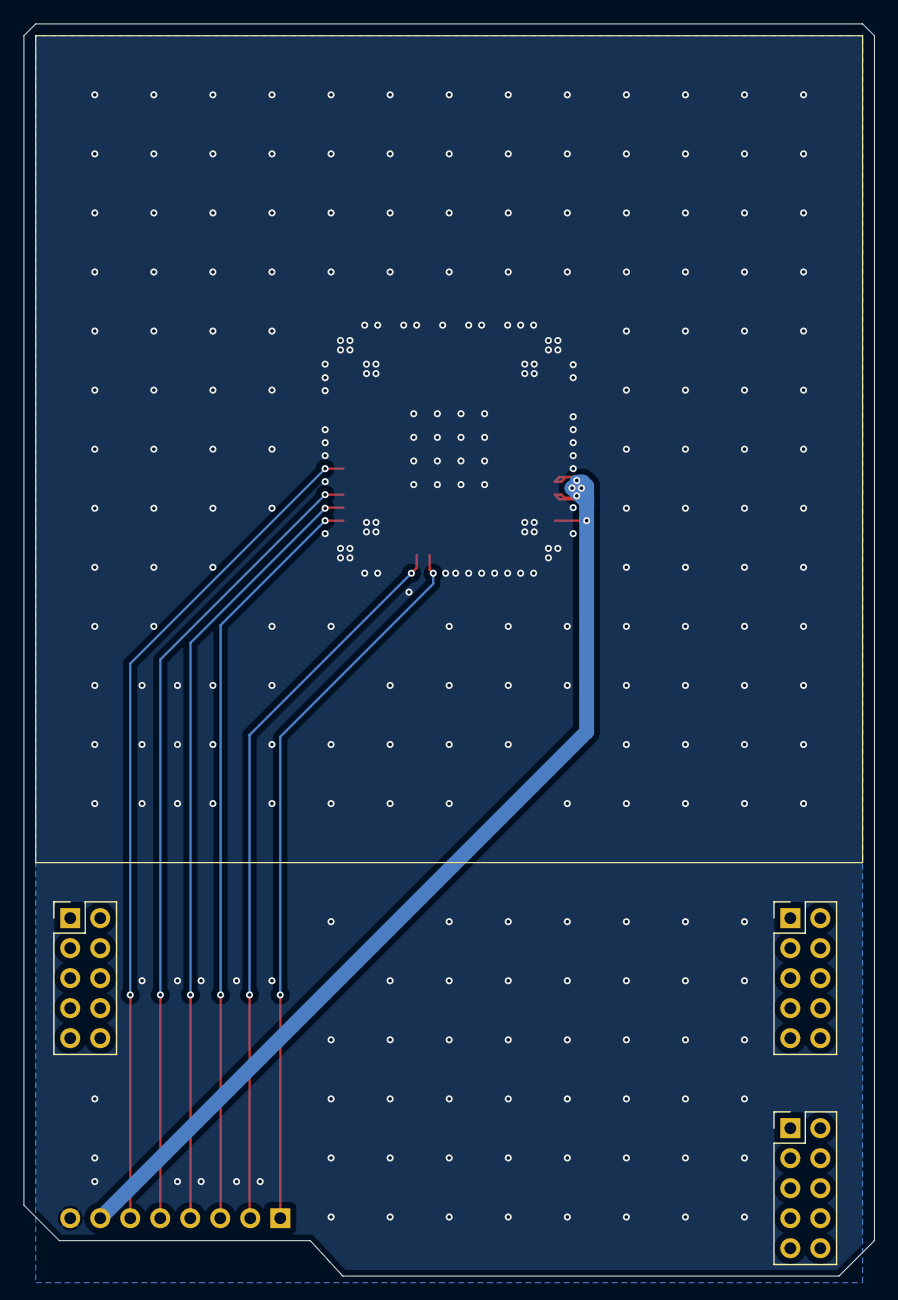
[picture p68: board DAN_F10N_testboard.kicad_pcb from below]

Board: 4 copper layers, 72.0 x 106.0 mm, 5 parts (3 on the bottom side), 8 nets.
