Benjamin-girard-1/magnetometer-node/firmware/esp32/ESP32-S3-WROOM-1/Mainboard/geophys-daq/main/adc_stream.h

#ifndef ADC_STREAM_H
#define ADC_STREAM_H

#include "esp_err.h"

#include <stdbool.h>

esp_err_t adc_stream_start(void);
esp_err_t adc_power_on(void);
esp_err_t adc_recover(void);
esp_err_t adc_diag(void);
esp_err_t adc_set_channel_gain(uint8_t ch, uint8_t gain_x);
esp_err_t adc_set_odr(uint32_t odr_hz);
void adc_power_off(void);
bool adc_streaming(void);
void adc_log_drops_if_changed(void);

#endif /* ADC_STREAM_H */
