Benjamin-girard-1/magnetometer-node/(commit log)

2025-11-18 initial Kicad commit
    [magnetometer_node_mainboard.kicad_pcb, magnetometer_node_mainboard.kicad_sch, pwr_9v_bridge.kicad_sch, sensor_hmc100x_3axis.kicad_sch, sensor_offset_drivers.kicad_sch, sensor_set_reset_driver.kicad_sch]
2025-11-19 Schematic sensor stage done
    [adc_ad777x.kicad_sch, analog_frontend_ina851.kicad_sch, connectors_io.kicad_sch, gnss_imu.kicad_sch, magnetometer_node_mainboard.kicad_pcb, magnetometer_node_mainboard.kicad_sch, mcu_esp32s3.kicad_sch, pwr_3v3a.kicad_sch]
2025-12-11 pre SPI test
    [magnetometer_node_mainboard.kicad_sch, sensor_offset_drivers.kicad_sch, sensor_set_reset_driver.kicad_sch]
2026-04-30 first code for the v1
    [6mm_HEX_Spacer_M4.step, 904_body_bottom.FCStd, 904_body_bottom.step, 904_body_top.FCStd, 904_body_top.step, 904_frame.FCStd, 904_frame.step, 904_frame10.step]
2026-04-30 SCL3300 driver functionnal
    [geophys_mainboard.kicad_pcb, pwr_3v3d.kicad_sch]
2026-05-01 Somewhat fix the ad7779 driver to read the thermistor but error with divider
    [ADC.kicad_sch]
2026-05-05 Bring up thermistor logging with IMU temperature references
    [ADC.kicad_sch, connectors_io.kicad_sch, exp_card_1.kicad_sch, imu.kicad_sch, mcu_esp32s3.kicad_sch, pwr_3v3a.kicad_sch, pwr_3v3d.kicad_sch, pwr_9v_bridge.kicad_sch]
2026-05-25 Backup avant deletion offset/dac
    [01_Base_HC_v1.stl, 02_Coil_Closer_HC_v1.stl, 03_Back_plate_HC_v1.stl, 04_Coil_Top_HC_v1.stl, 05_Pillar_HC_v1.stl, 904_frame12.stl, ADC.kicad_sch, Bottom_coil_B.stl]
2026-05-27 SD mux and 3V3D power sequencing bring-up
    [ADC.kicad_sch, RESET.csv, SET.csv, SETRESET.csv, connectors_io.kicad_sch, exp_card_1.kicad_sch, geophys_mainboard.kicad_pcb, imu.kicad_sch]
2026-06-01 Python app works as I want
    [imu_tilt_test_20260601-092800.csv, magnetic_expension.kicad_pcb]
2026-06-02 ADC Works! Gain is normal
    [mag_scope_data_20260601-150846.csv, mag_scope_data_20260601-154437.csv]
2026-06-03 calibration on the z and x axis
    [analog_frontend_ina851.kicad_sch, exp_card_1.kicad_sch, magnetic_expension.kicad_sch, mcu_esp32s3.kicad_sch, sensor_hmc100x_3axis.kicad_sch, sensor_offset_drivers.kicad_sch, sensor_set_reset_driver.kicad_sch]
2026-06-09 Work in progress rev2
    [CONN.kicad_sch, analog_frontend_ina851.kicad_sch, geophys_mainboard.kicad_pcb, magnetic_expension.kicad_pcb, magnetic_expension.kicad_sch, pwr_3v3a.kicad_sch, pwr_3v3d.kicad_sch, pwr_9v_bridge.kicad_sch]
2026-06-22 Delete hardware/pcb/lib.zip
    delete
2026-06-22 Delete hardware/pcb/Expension_card_design/PCB.zip
    pcb.zip delete
2026-06-23 clearing git
    [ANALOG_BALANCING.kicad_sch, Bridge_offset.kicad_sch, CONN.kicad_sch, Magnetic_sensor_board_v1_bom.csv, Magnetic_sensor_board_v1_designators.csv, Magnetic_sensor_board_v1_positions.csv, Simulation_mag_v2.kicad_pcb, Simulation_mag_v2.kicad_sch]
2026-06-26 kicad mag board done
    [ADC.kicad_sch, ANALOG_BALANCING.kicad_sch, GNSS.kicad_sch, GNSS_board.kicad_pcb, GNSS_board.kicad_sch, GPS_tile.kicad_sch, MMR_Mainboard_1_bom.csv, MMR_Mainboard_1_designators.csv]
